TANACHAT007/diy-spirometer/02_design/feasibility.md

# Feasibility — DIY Spirometer (IoT, Venturi + SDP810)

Venturi D = 28.0 mm, d = 23.0 mm (β = 0.821), ρ = 1.15, Cd = 0.98; Sensirion SDP810-500Pa (±500 Pa, I2C).

| Q (L/s) | ΔP (Pa) | count SDP810 |
|---|---|---|
| 0.1 | 0.019 | 1 |
| 0.2 | 0.076 | 5 |
| 0.5 | 0.472 | 28 |
| 1 | 1.889 | 113 |
| 2 | 7.557 | 453 |
| 5 | 47.232 | 2834 |
| 8 | 120.914 | 7255 |
| 10 | 188.928 | 11336 |
| 12 | 272.057 | 16323 |
| 14 | 370.300 | 22218 |
| 16 | 483.657 | 29019 |

| ตรวจ | ค่า | ผล |
|---|---|---|
| ช่วงวัด ≥ 16 L/s ก่อนเซนเซอร์อิ่มตัว (ndd = ±16) | อิ่มตัวที่ 16.3 L/s | ✅ |
| ความต้านทานลม < 1.5 cmH2O/L/s (ATS/ERS 2019) | 0.046 cmH2O/L/s | ✅ |
| ความละเอียดที่ 0.2 L/s (ปลายการเป่า) | 0.076 Pa = 4.5 count | ✅ |
| อัตราสุ่ม ≥ 100 Hz | SDP810 continuous 0.5 ms → ใช้ 200 Hz | ✅ |
| แบต 1000 mAh ต่อการชาร์จ | ≈ 337 ครั้งเป่า / ชาร์จ, sleep ≈ 417 วัน | ✅ |
| ชาร์จผ่านแท่น (XIAO S3 charger 100 mA) | ≈ 12 ชม. เต็ม (ตั้งไว้บนแท่นข้ามคืน) | ✅ |
| ขั้วสปริง pogo 2 ขา 1 A | 5 V 0.5 A สูงสุด | ✅ |

## เทียบกับ ndd Easy on-PC
| | ndd Easy on-PC | ของเรา |
|---|---|---|
| การเชื่อมต่อ | สาย USB เข้า PC | ไร้สาย BLE (มือถือ) + Wi-Fi → คลาวด์ + USB-C |
| พลังงาน | ไฟจาก USB | แบต LiPo 1000 mAh + แท่นชาร์จ |
| แสดงผล | บนคอมเท่านั้น | จอกลม 1.28" บนตัวเครื่อง + เว็บแอป + แดชบอร์ดห้องเรียน |
| ข้อมูล | ซอฟต์แวร์ PC | Firebase: ประวัติรายคน, กราฟ, ส่งออก CSV |
| ราคา | ~60,000+ บาท | ~2,000 บาท |
| ความแม่นยำ | ±2.5 % (รับรอง ATS/ERS) | เป้าหมาย ±5 % หลังสอบเทียบ (ยังไม่รับรอง) |

## ข้อจำกัด
- ΔP ของ Venturi เป็นบวกทั้งสองทิศ → วัดลมออกเป็นหลัก (FVC, FEV1, PEF, FEV1/FVC, FEF25-75).
- ต้องสอบเทียบ Cd กับกระบอกฉีด 3 L (หรือยืมจากโรงพยาบาล) ก่อนอ้างตัวเลข.
- เป็นเครื่องมือเพื่อการเรียนรู้/คัดกรองเบื้องต้น ไม่ใช่เครื่องมือแพทย์.
