TANACHAT007/diy-spirometer/CREDITS.md

# Credits

**Designed and built by Tanachat S.** (GitHub: [TANACHAT007](https://github.com/TANACHAT007)) - team **MEDTHAI**, 2026.

If you reuse, remix or print this work, please keep this credit:

> DIY IoT Spirometer - designed by Tanachat S. (TANACHAT007) / MEDTHAI - 2026 - https://github.com/TANACHAT007/diy-spirometer

- Code: MIT (`LICENSE`) - keep the copyright notice.
- Designs / documents / models: CC BY 4.0 (`LICENSE-DESIGN`) - attribution required.
- Prepared for International Youth Summit (IYS) 2026, sub-theme Health.

Third-party parts are credited to their makers (Sensirion SDP810, Seeed XIAO ESP32, GC9A01 modules); their names are used only to identify compatible parts.
