TANACHAT007/diy-spirometer/01_reference/ndd_easy_on_pc.png

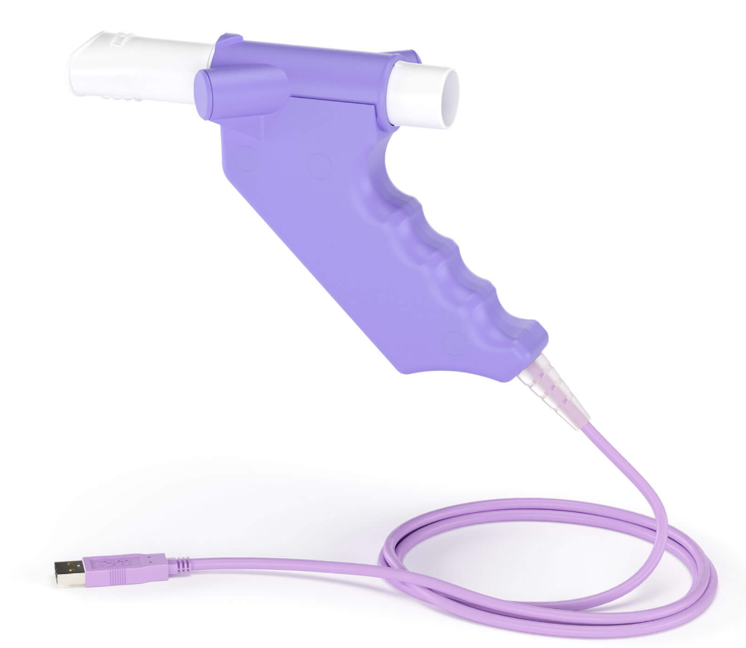
01_reference/ndd_easy_on_pc.png
