TANACHAT007/diy-spirometer/03_renders/diy-spirometer_cu_dock.png

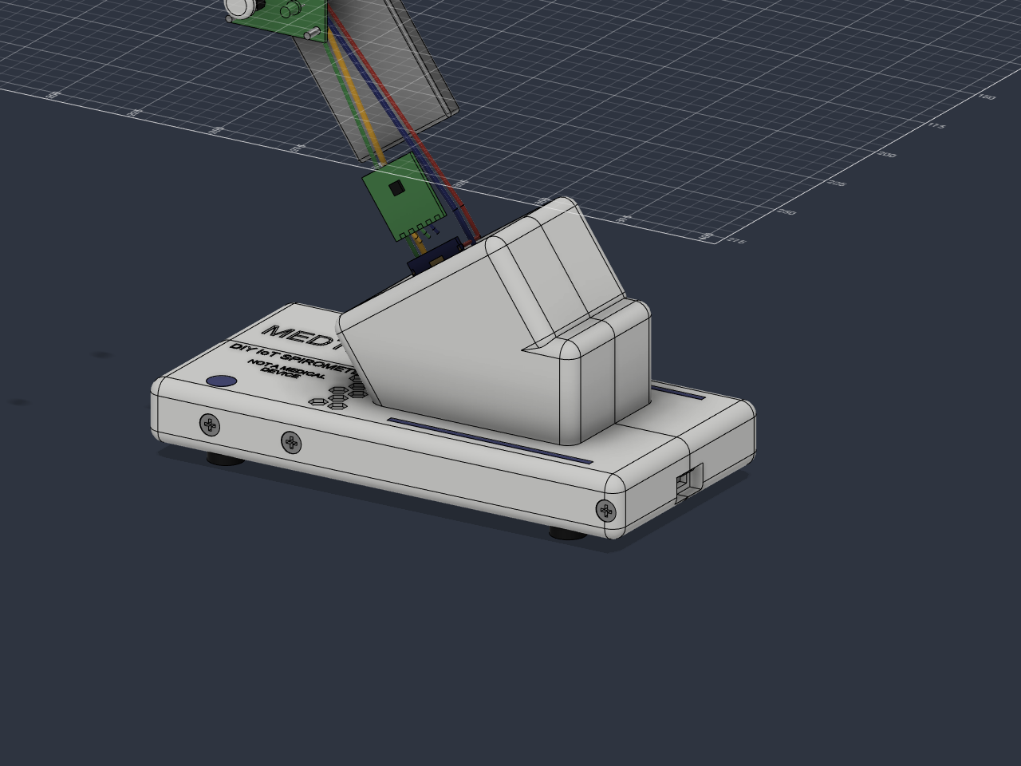
03_renders/diy-spirometer_cu_dock.png
