TANACHAT007/diy-spirometer/03_renders/diy-spirometer_cu_hero.png

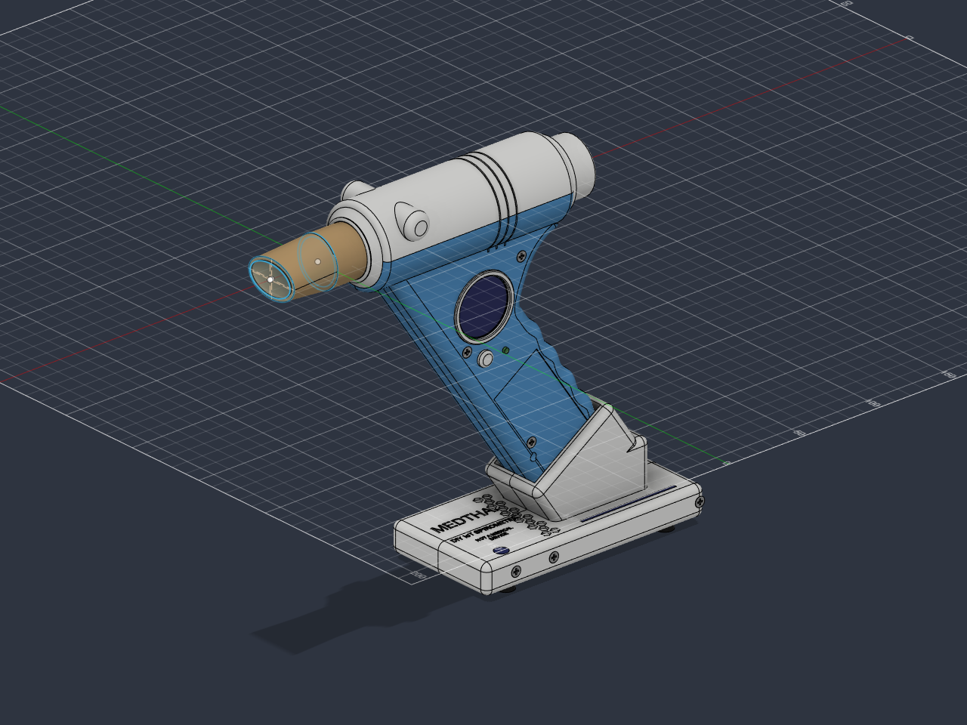
03_renders/diy-spirometer_cu_hero.png
