TANACHAT007/diy-spirometer/03_renders/diy-spirometer_cu_open.png

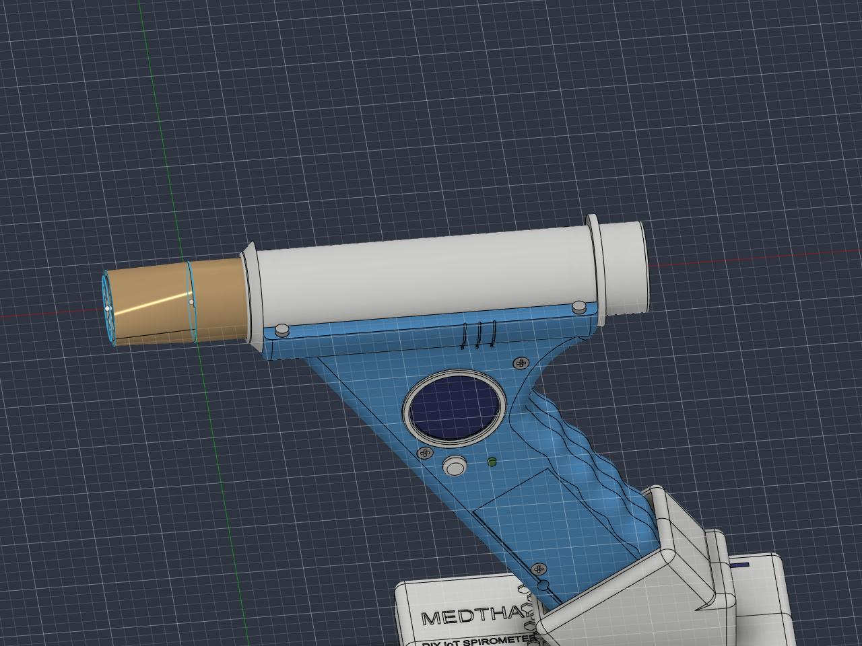
03_renders/diy-spirometer_cu_open.png
