TANACHAT007/diy-spirometer/03_renders/diy-spirometer_cut_grip.png

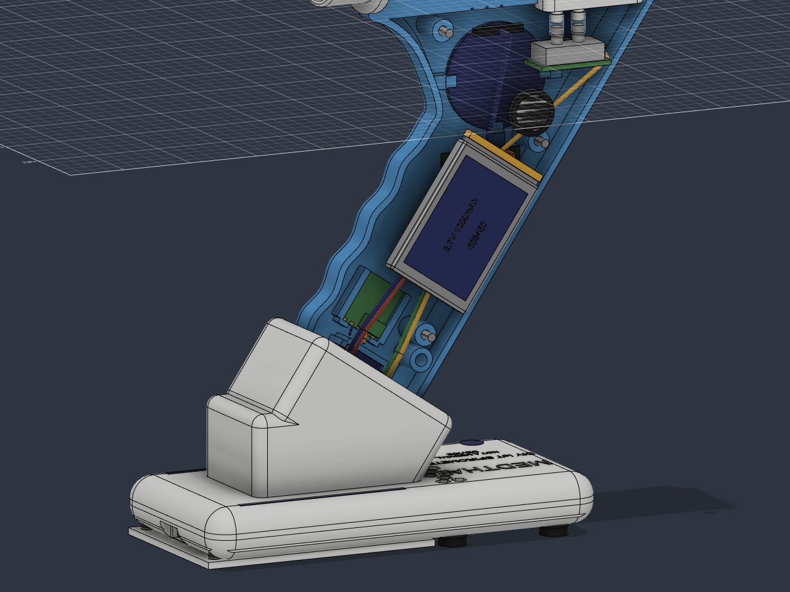
03_renders/diy-spirometer_cut_grip.png
