TANACHAT007/diy-spirometer/03_renders/diy-spirometer_cut_side.png

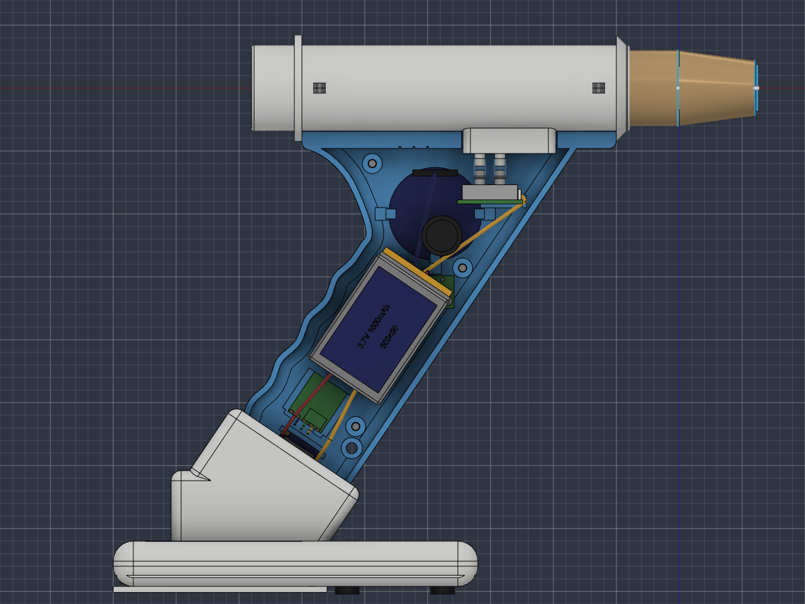
03_renders/diy-spirometer_cut_side.png
