TANACHAT007/diy-spirometer/03_renders/diy-spirometer_dockcut_open.png

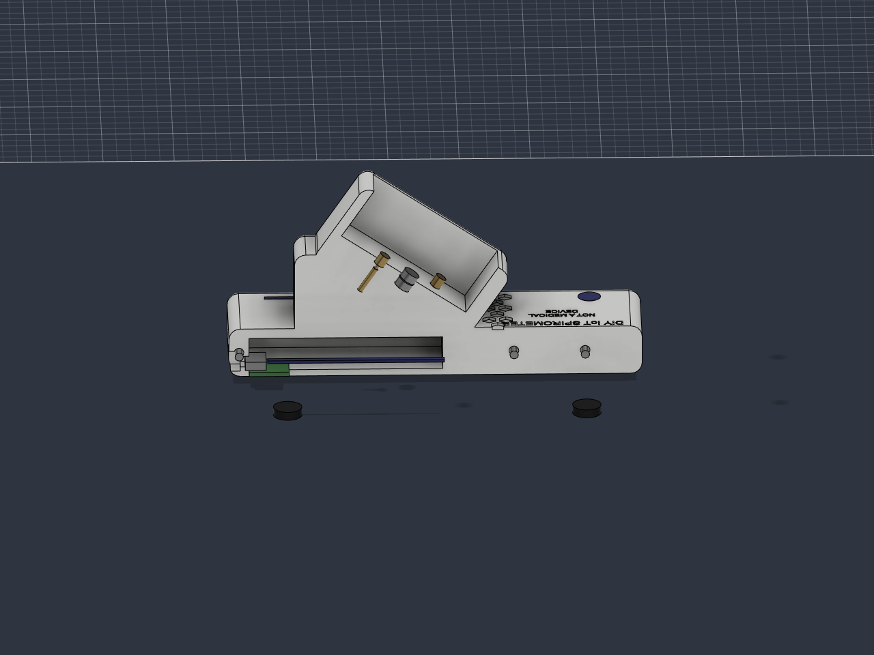
03_renders/diy-spirometer_dockcut_open.png
