TANACHAT007/diy-spirometer/03_renders/diy-spirometer_dockcut_top.png

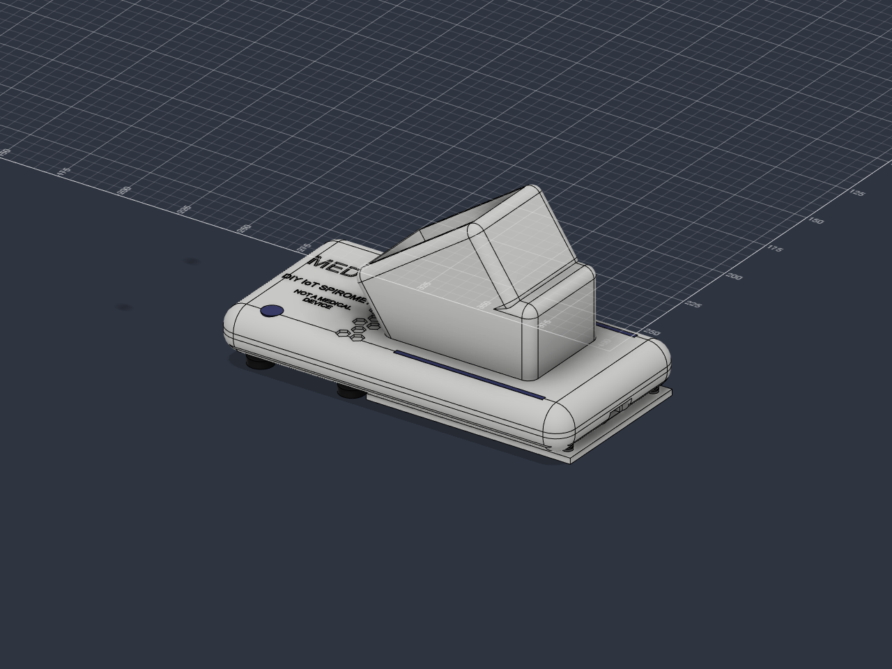
03_renders/diy-spirometer_dockcut_top.png
