TANACHAT007/diy-spirometer/03_renders/diy-spirometer_front.png

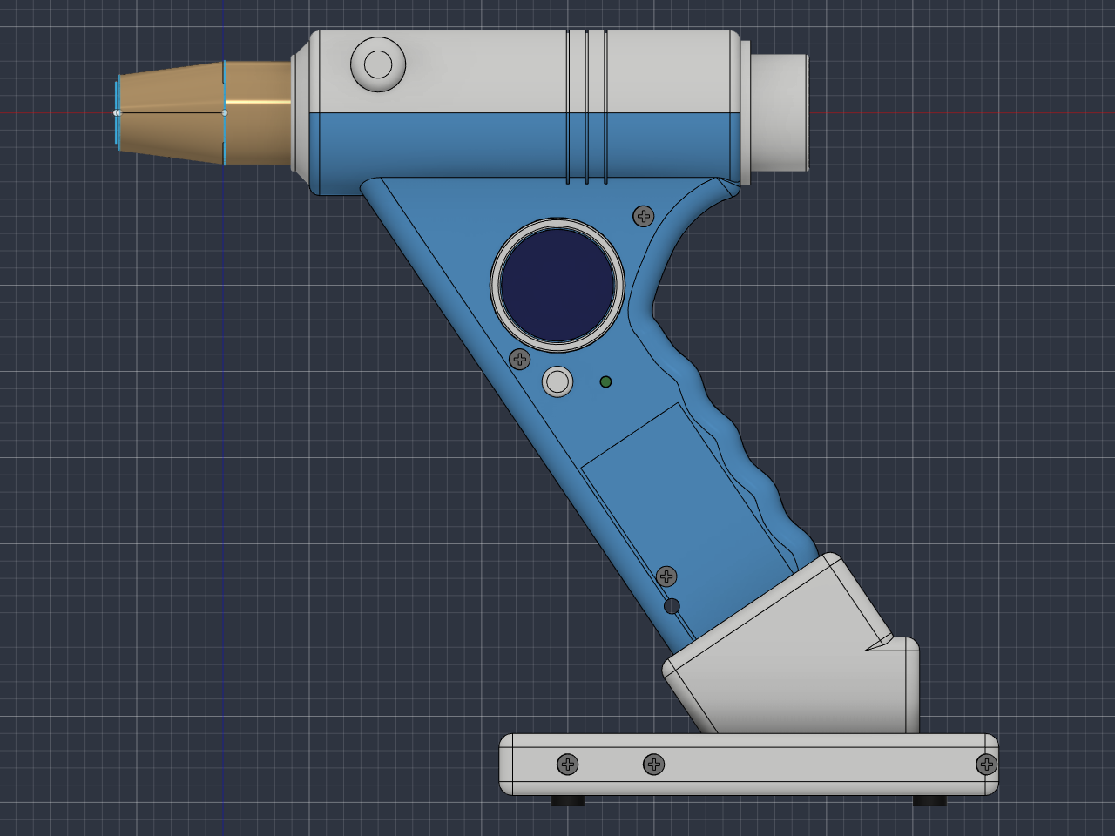
03_renders/diy-spirometer_front.png
