TANACHAT007/diy-spirometer/03_renders/diy-spirometer_iso.png

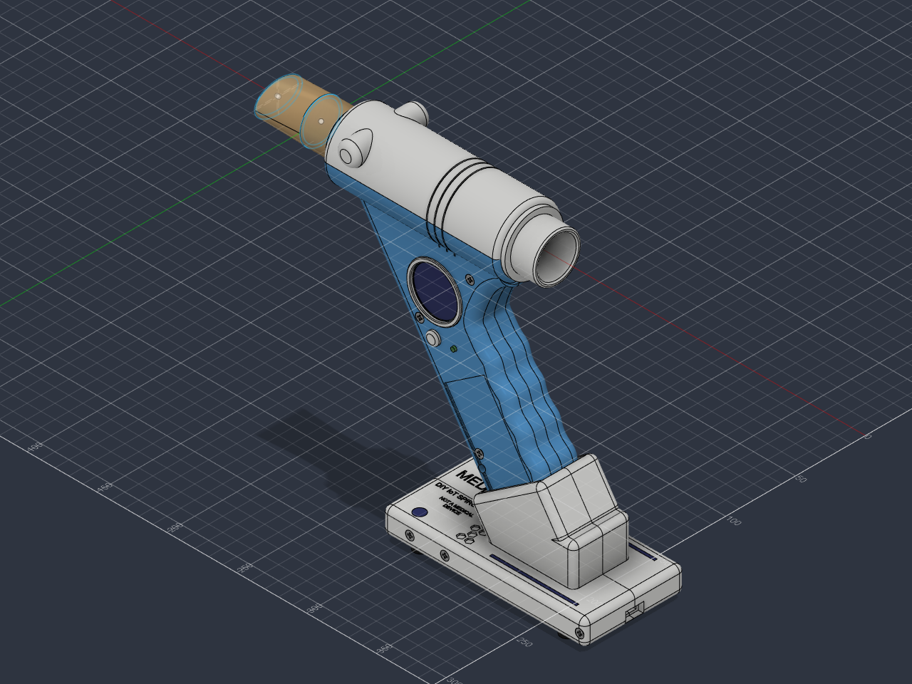
03_renders/diy-spirometer_iso.png
