TANACHAT007/diy-spirometer/03_renders/diy-spirometer_right.png

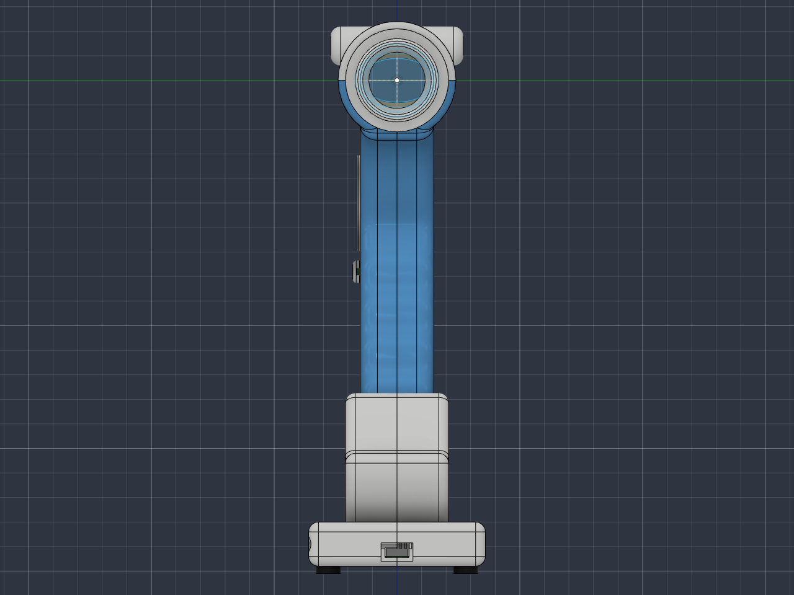
03_renders/diy-spirometer_right.png
