TANACHAT007/diy-spirometer/09_bom/bom.csv

# | Group | Item | Spec | Qty | Unit THB (est.) | Total THB | Status | Shopee | Lazada | Note
1 | อิเล็กทรอนิกส์ | บอร์ดหลัก Seeed XIAO ESP32-S3 (หรือ ESP32-C3) | 21x17.8 mm, BLE+Wi-Fi, มีวงจรชาร์จ LiPo | 1 | 350 | 350 | buy | https://shopee.co.th/search?keyword=Seeed%20XIAO%20ESP32S3 | https://www.lazada.co.th/catalog/?q=Seeed%20XIAO%20ESP32S3 | C3 ใช้ได้เหมือนกัน (ถูกกว่า) ใส่ได้ footprint เดียวกัน
2 | อิเล็กทรอนิกส์ | เซ็นเซอร์ความดันต่าง Sensirion SDP810-500Pa | I2C 0x25, บน breakout 26x14 + ขั้ว JST-GH 4 ขา | 1 | 1200 | 1200 | buy? | https://shopee.co.th/search?keyword=SDP810-500Pa%20breakout | https://www.lazada.co.th/catalog/?q=SDP810-500Pa%20breakout | ตัวเดียวที่อาจไม่มีใน Shopee: ถ้าหาไม่ได้สั่ง Mouser/DigiKey/Element14 + breakout; ตัว SMD ต้องบัดกรีละเอียด
3 | อิเล็กทรอนิกส์ | จอกลม GC9A01 1.28 นิ้ว | 240x240 SPI, PCB กลม Ø37 | 1 | 150 | 150 | buy | https://shopee.co.th/search?keyword=GC9A01%201.28%20inch%20round%20LCD | https://www.lazada.co.th/catalog/?q=GC9A01%201.28%20inch%20round%20LCD | ตรวจว่าเป็นรุ่น 7 ขา (ไม่มีทัช)
4 | อิเล็กทรอนิกส์ | แบตเตอรี่ LiPo 603450 1000 mAh | 3.7 V มีวงจร PCM, ขนาด 6x34x50 mm | 1 | 150 | 150 | buy | https://shopee.co.th/search?keyword=LiPo%20603450%201000mAh%203.7V | https://www.lazada.co.th/catalog/?q=LiPo%20603450%201000mAh%203.7V | ต้องมีวงจรป้องกัน; ขั้วต่อ JST 1.25/PH ให้ตรงกับบอร์ดหรือบัดกรีตรง
5 | อิเล็กทรอนิกส์ | ลำโพงกลมบาง Ø16 x 3.5 mm 8 ohm 0.5 W | ติดผนังด้ามขวา เสียงออกรู Ø1.4 x 19 รู | 1 | 25 | 25 | buy | https://shopee.co.th/search?keyword=mini%20speaker%2016mm%208ohm%200.5W | https://www.lazada.co.th/catalog/?q=mini%20speaker%2016mm%208ohm%200.5W | ตรวจขนาดจริงก่อนพิมพ์ (ถ้า Ø15/Ø20 ปรับ SPK_D ใน model.py); ติดเทปโฟมกันเสียงรั่ว
6 | อิเล็กทรอนิกส์ | แอมป์เสียง I2S MAX98357A breakout | 3 W class-D, ~19 x 18 mm, ไม่ต้องมี DAC | 1 | 90 | 90 | buy | https://shopee.co.th/search?keyword=MAX98357A%20I2S%20amplifier%20module | https://www.lazada.co.th/catalog/?q=MAX98357A%20I2S%20amplifier%20module | ต่อ BCLK/LRC/DIN เข้า D3/D6/D7, ใช้ 3.3 V จากบอร์ด, SD/GAIN ปล่อยค่าเดิม
7 | อิเล็กทรอนิกส์ | ปุ่ม tact switch 6x6 สูง 7 mm | ก้านยาว 7 mm | 2 | 3 | 6 | buy | https://shopee.co.th/search?keyword=tact%20switch%206x6x7 | https://www.lazada.co.th/catalog/?q=tact%20switch%206x6x7 | ซื้อเผื่อ 1
8 | อิเล็กทรอนิกส์ | LED 3 mm | สีเขียว/ฟ้า + R 330 ohm | 2 | 2 | 4 | buy | https://shopee.co.th/search?keyword=LED%203mm | https://www.lazada.co.th/catalog/?q=LED%203mm | บวกตัวต้านทาน 330 ohm
9 | อิเล็กทรอนิกส์ | แผงปุ่ม+LED (perfboard 13x29 mm) | บัดกรีปุ่ม tact + LED ลงแผงก่อน แล้ววางลงเสา 2 ต้นในตัวเครื่อง | 1 | 5 | 5 | buy | https://shopee.co.th/search?keyword=perfboard%202x8%20cm | https://www.lazada.co.th/catalog/?q=perfboard%202x8%20cm | ตัดจากแผ่นยาว
10 | ฮาร์ดแวร์ | สกรู M2x6 หัวกลม (tapping) | ยึดแผงปุ่ม+LED 2 ตัว | 2 | 2 | 4 | buy | https://shopee.co.th/search?keyword=M2x6%20self%20tapping%20screw | https://www.lazada.co.th/catalog/?q=M2x6%20self%20tapping%20screw | ซื้อเป็นชุด
11 | อิเล็กทรอนิกส์ | ตัวต้านทาน 4.7 kohm | ดึงขึ้น I2C 2 ตัว + ตัวหาร R 100 kohm 2 ตัว (วัดแบต) | 6 | 1 | 6 | buy | https://shopee.co.th/search?keyword=resistor%20kit%201/4W | https://www.lazada.co.th/catalog/?q=resistor%20kit%201/4W | ซื้อเป็นชุด
12 | อิเล็กทรอนิกส์ | สายไฟ 28-30 AWG / สาย silicone | หลายสี | 1 | 40 | 40 | buy | https://shopee.co.th/search?keyword=%E0%B8%AA%E0%B8%B2%E0%B8%A2%E0%B9%84%E0%B8%9F%2028AWG%20silicone | https://www.lazada.co.th/catalog/?q=%E0%B8%AA%E0%B8%B2%E0%B8%A2%E0%B9%84%E0%B8%9F%2028AWG%20silicone
13 | อิเล็กทรอนิกส์ | USB-C breakout (แท่นชาร์จ) | ตัวเมีย 5 V | 1 | 30 | 30 | buy | https://shopee.co.th/search?keyword=USB-C%20breakout%20board | https://www.lazada.co.th/catalog/?q=USB-C%20breakout%20board
14 | กล/ตัวยึด | Pogo pin ก้าน Ø2.0 | สปริง 2 ตัว ระยะยื่น ~2 mm | 2 | 15 | 30 | buy | https://shopee.co.th/search?keyword=pogo%20pin%202mm%20spring | https://www.lazada.co.th/catalog/?q=pogo%20pin%202mm%20spring | วัดเส้นผ่าศูนย์กลางก้านให้ได้ 2.0 mm (รูเจาะ 2.2)
15 | กล/ตัวยึด | น็อตฝังทองเหลือง M3 x 5 (OD4.5) | heat-set insert | 4 | 1 | 4 | buy | https://shopee.co.th/search?keyword=heat%20set%20insert%20M3%205mm | https://www.lazada.co.th/catalog/?q=heat%20set%20insert%20M3%205mm | ซื้อแพ็ค 50-100 ตัว
16 | กล/ตัวยึด | น็อตฝังทองเหลือง M3 x 4 (OD4.5) | heat-set insert | 6 | 1 | 6 | buy | https://shopee.co.th/search?keyword=heat%20set%20insert%20M3%204mm | https://www.lazada.co.th/catalog/?q=heat%20set%20insert%20M3%204mm | แท่นชาร์จ 4 + หน้าสัมผัสบนเครื่อง 2
17 | กล/ตัวยึด | สกรู M3x20 หัวเตเปอร์ (flat head) |  | 4 | 1 | 4 | buy | https://shopee.co.th/search?keyword=M3x20%20flat%20head%20screw | https://www.lazada.co.th/catalog/?q=M3x20%20flat%20head%20screw | ตัวเครื่อง
18 | กล/ตัวยึด | สกรู M3x6 หัวเตเปอร์ |  | 4 | 1 | 4 | buy | https://shopee.co.th/search?keyword=M3x6%20flat%20head%20screw | https://www.lazada.co.th/catalog/?q=M3x6%20flat%20head%20screw | ปิดแท่นชาร์จ
19 | กล/ตัวยึด | แม่เหล็กนีโอไดเมียม 5x2 |  | 8 | 3 | 24 | buy | https://shopee.co.th/search?keyword=neodymium%20magnet%205x2 | https://www.lazada.co.th/catalog/?q=neodymium%20magnet%205x2 | ฝาท่อ 4 คู่ (ตรวจขั้วตอนติดกาว)
20 | กล/ตัวยึด | แม่เหล็กนีโอไดเมียม 6x3 |  | 2 | 5 | 10 | buy | https://shopee.co.th/search?keyword=neodymium%20magnet%206x3 | https://www.lazada.co.th/catalog/?q=neodymium%20magnet%206x3 | นำทางด้ามเข้าแท่น
21 | กล/ตัวยึด | ท่อซิลิโคน ID3 OD5 | ยาว ~50 mm 2 ท่อน | 1 | 30 | 30 | buy | https://shopee.co.th/search?keyword=silicone%20tube%203x5mm | https://www.lazada.co.th/catalog/?q=silicone%20tube%203x5mm
22 | กล/ตัวยึด | ยางรองเท้า Ø10 x 3 mm |  | 4 | 3 | 12 | buy | https://shopee.co.th/search?keyword=rubber%20feet%2010mm%20adhesive | https://www.lazada.co.th/catalog/?q=rubber%20feet%2010mm%20adhesive | ใต้แท่นชาร์จ
23 | วัสดุพิมพ์ | เส้น PETG (สีขาว/ใส/เขียวอ่อน) สำหรับที่เป่าต้นแบบ | ที่เป่าใช้แล้วทิ้ง ชิ้นละ ~11 g (~5 บาท) | 1 | 400 | 400 | buy? | https://shopee.co.th/search?keyword=PETG%20filament%201kg | https://www.lazada.co.th/catalog/?q=PETG%20filament%201kg | ใช้พิมพ์ที่เป่าอย่างเดียว; ไม่ย่อยสลาย รุ่นต่อไปเปลี่ยนเป็นวัสดุเศษพืช; ซื้อเป็นม้วน 250-500 g ก็ได้
24 | กล/ตัวยึด | กาวตะกั่ว/ซุปเปอร์กลู + สายคล้องมือ | ติดขอบจอและฝาปุ่ม; สายร้อยรู Ø4.5 ที่ท้ายด้าม | 1 | 30 | 30 | buy | https://shopee.co.th/search?keyword=super%20glue%20gel%20%2B%20wrist%20strap%20cord | https://www.lazada.co.th/catalog/?q=super%20glue%20gel%20%2B%20wrist%20strap%20cord | ใช้กาวเจลหยดเล็กน้อย อย่าให้เข้าหน้าจอ
25 | วัสดุพิมพ์ | เทปโฟมกาวสองหน้า 1 mm | ติดลำโพง/กันเสียงรั่ว | 1 | 20 | 20 | buy | https://shopee.co.th/search?keyword=foam%20tape%201mm%20double%20sided | https://www.lazada.co.th/catalog/?q=foam%20tape%201mm%20double%20sided
26 | วัสดุพิมพ์ | เส้น PETG | ≈ 520 g (รวม +10%) | 1 | 450 | 450 | buy? | https://shopee.co.th/search?keyword=PETG%20filament%201kg | https://www.lazada.co.th/catalog/?q=PETG%20filament%201kg | ถ้ามีเส้นอยู่แล้วไม่ต้องซื้อ
