TANACHAT007/diy-spirometer/09_bom/fasteners_bom.csv

item | qty
M3x5_heat-set_insert_brass | 7
M3x20_flat_head_phillips_countersunk | 4
M3x40_flat_head_phillips_countersunk | 3
