TANACHAT007/diy-spirometer/06_cad_export/diy-spirometer_assembly.step

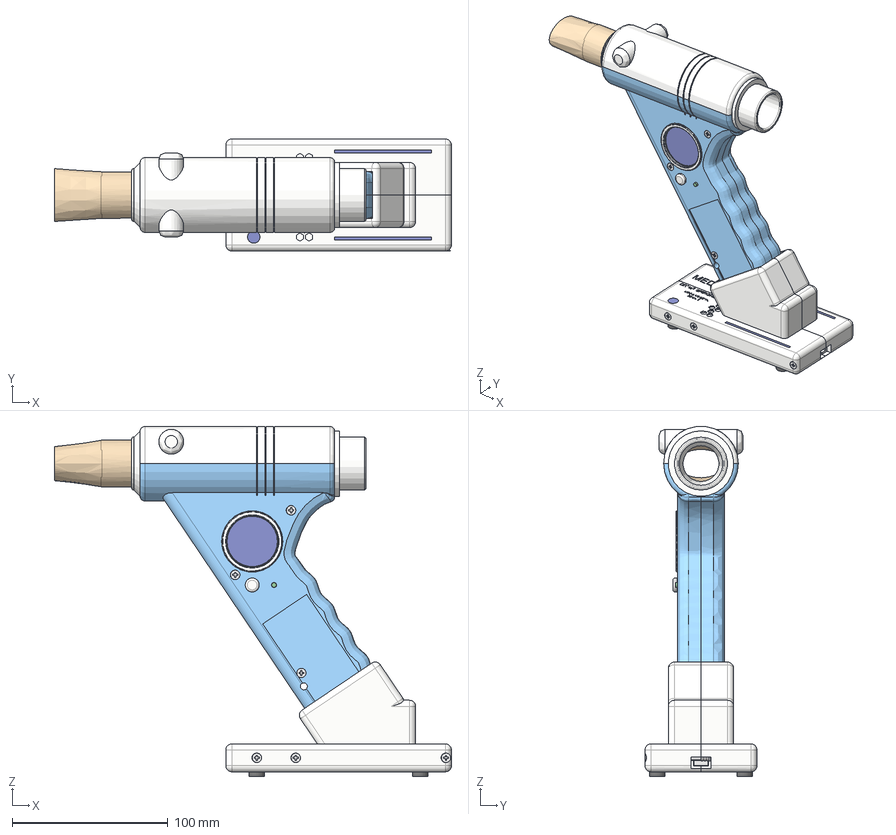
[picture p27: CAD file, 2026-10-21]
06_cad_export/diy-spirometer_assembly.step
255.0 x 72.0 x 224.8 mm
