TANACHAT007/diy-spirometer/04_print_stl/dock_left.stl

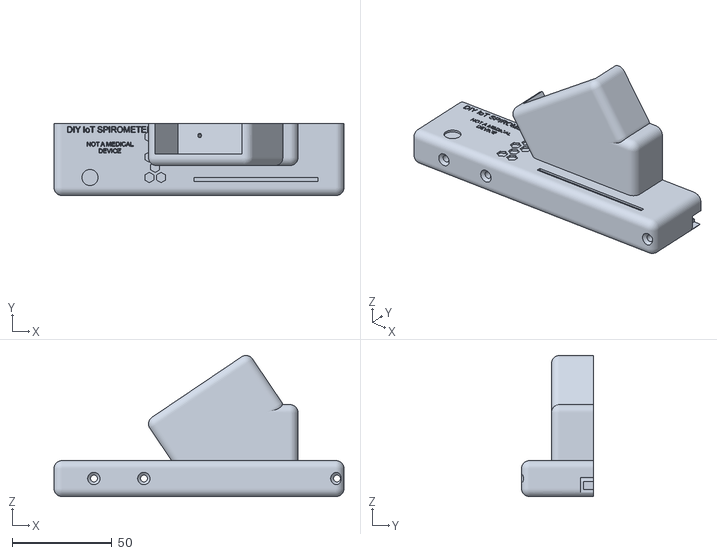
[picture p28: CAD file, 2026-10-21]
04_print_stl/dock_left.stl
145.0 x 36.0 x 70.5
