TANACHAT007/diy-spirometer/04_print_stl/print_ready/plate3_dock_halves.stl

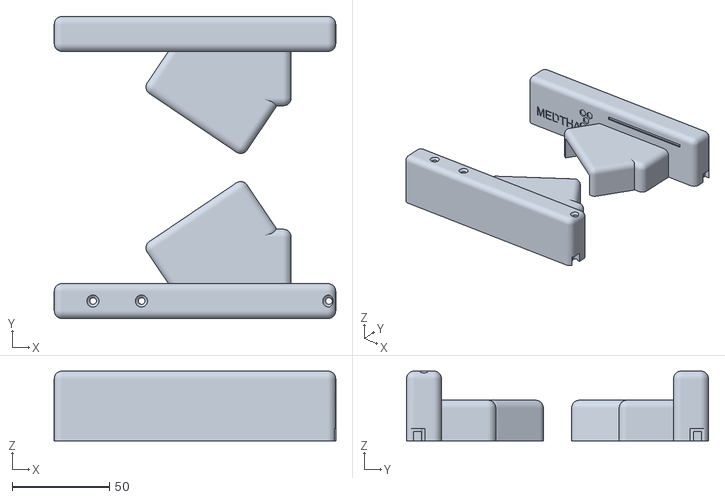
[picture p29: CAD file, 2026-10-22]
04_print_stl/print_ready/plate3_dock_halves.stl
145.0 x 155.5 x 36.0
