TANACHAT007/diy-spirometer/10_manual/web/internals/Rubber_Feet.stl

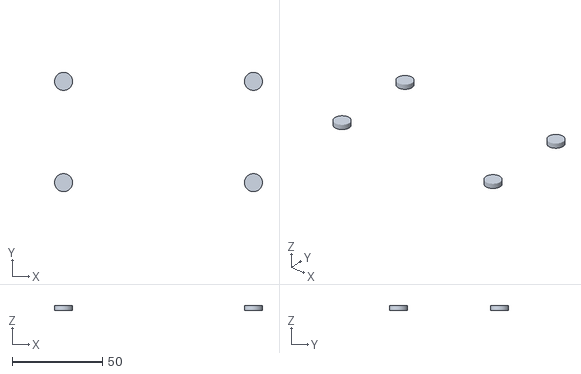
[picture p30: CAD file, 2026-10-22]
10_manual/web/internals/Rubber_Feet.stl
115.0 x 66.0 x 3.00
