TANACHAT007/diy-spirometer/04_print_stl/print_ready/plate4_small_parts.stl

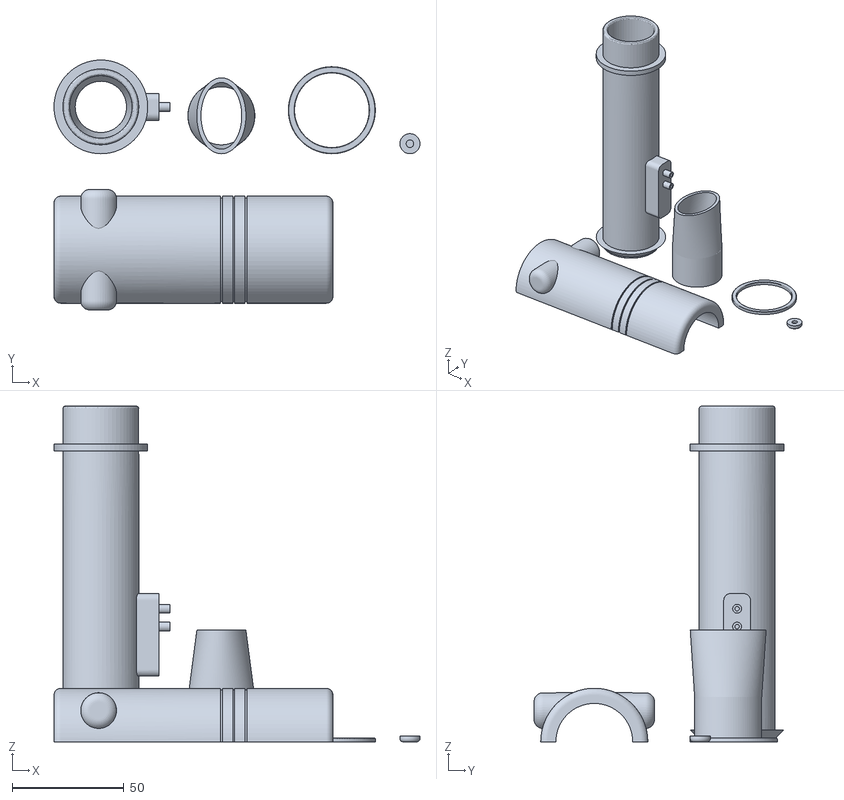
[picture p31: CAD file, 2026-10-22]
04_print_stl/print_ready/plate4_small_parts.stl
164.0 x 112.0 x 150.4
