TANACHAT007/diy-spirometer/10_manual/web/internals/E7_USB_C_Breakout_Dock.stl

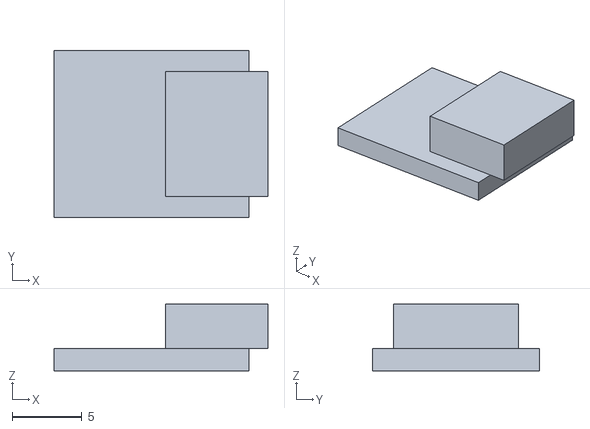
[picture p32: CAD file, 2026-10-22]
10_manual/web/internals/E7_USB_C_Breakout_Dock.stl
15.4 x 12.0 x 4.80
