TANACHAT007/diy-spirometer/04_print_stl/housing_right.stl

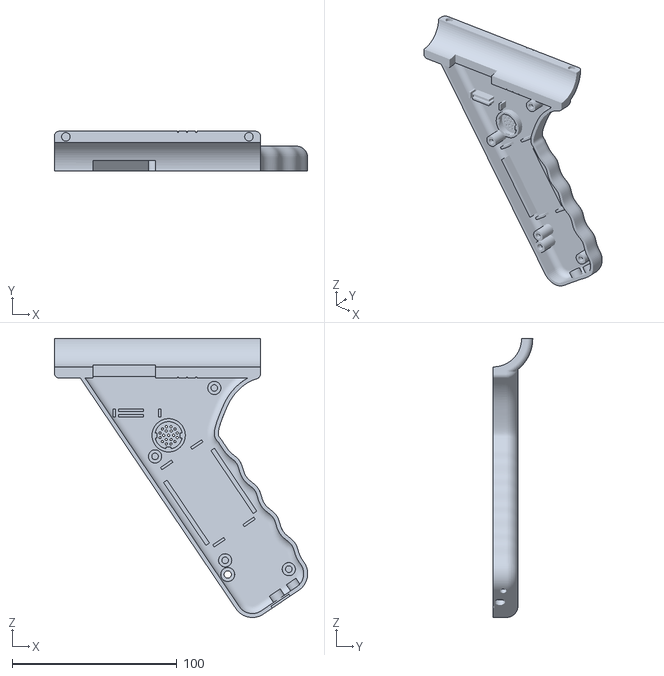
[picture p33: CAD file, 2026-10-21]
04_print_stl/housing_right.stl
153.6 x 24.0 x 169.1
