TANACHAT007/diy-spirometer/04_print_stl/print_ready/plate1_housing_left.stl

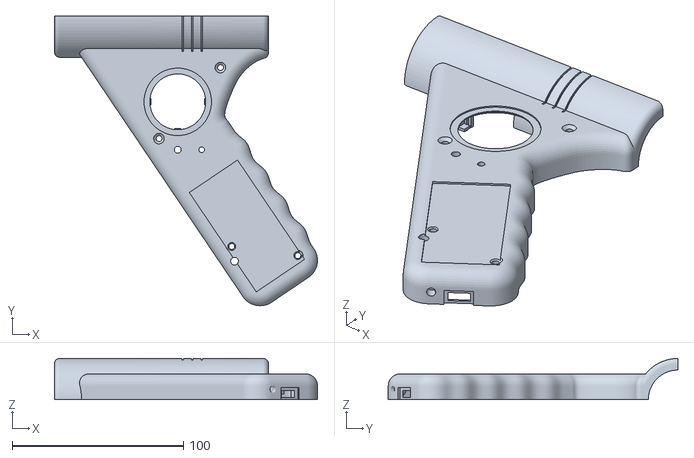
[picture p34: CAD file, 2026-10-22]
04_print_stl/print_ready/plate1_housing_left.stl
153.6 x 169.1 x 24.0
