TANACHAT007/diy-spirometer/10_manual/web/internals/E6_LED_3mm.stl

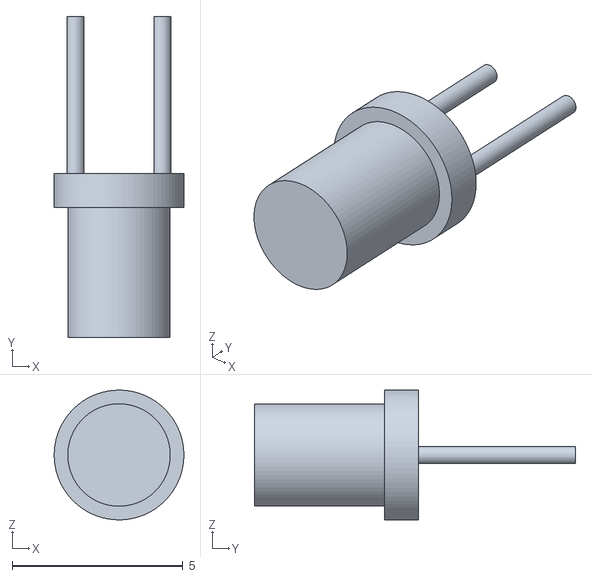
[picture p35: CAD file, 2026-10-16]
10_manual/web/internals/E6_LED_3mm.stl
3.80 x 9.40 x 3.80
