TANACHAT007/diy-spirometer/10_manual/web/internals/E7_Button_LED_Board.stl

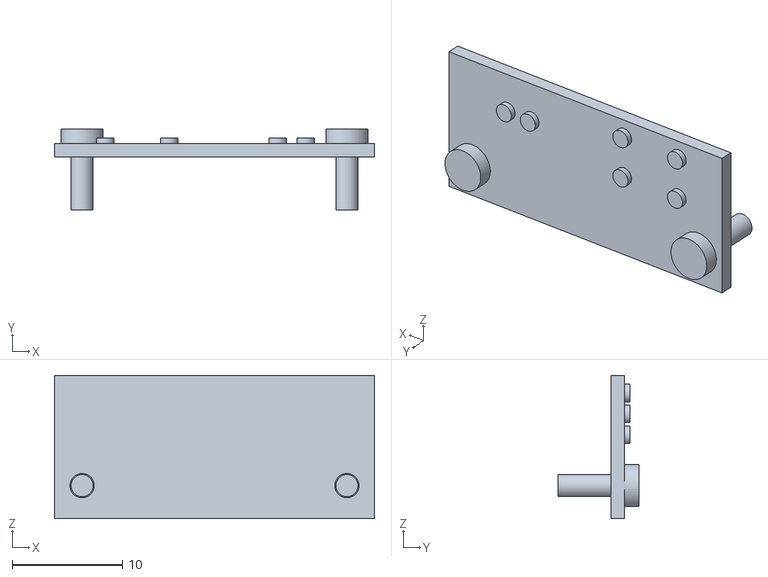
[picture p36: CAD file, 2026-10-16]
10_manual/web/internals/E7_Button_LED_Board.stl
29.0 x 7.30 x 13.0
