TANACHAT007/diy-spirometer/04_print_stl/mouthpiece.stl

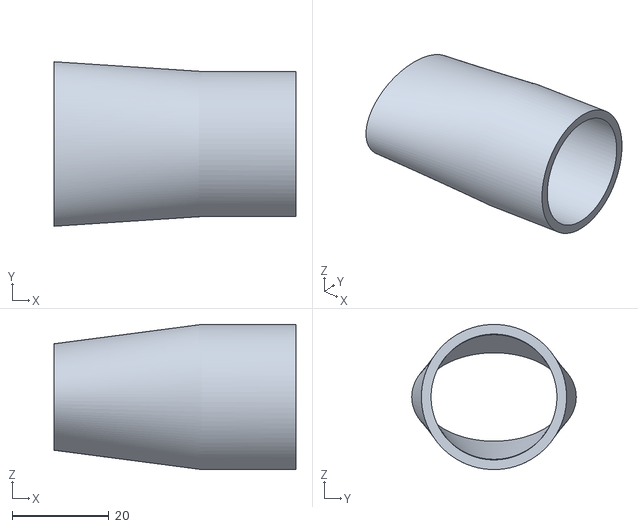
[picture p37: CAD file, 2026-10-21]
04_print_stl/mouthpiece.stl
50.0 x 34.0 x 30.0
