TANACHAT007/diy-spirometer/10_manual/web/internals/E9_MAX98357A_I2S_Amp.stl

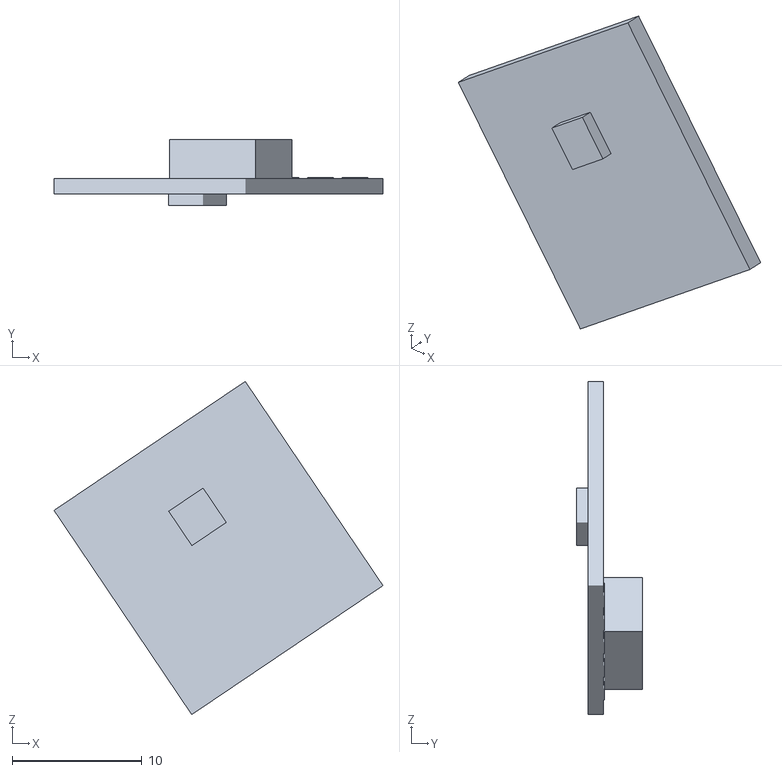
[picture p38: CAD file, 2026-10-15]
10_manual/web/internals/E9_MAX98357A_I2S_Amp.stl
25.4 x 5.10 x 25.7
