TANACHAT007/diy-spirometer/04_print_stl/button_cap.stl

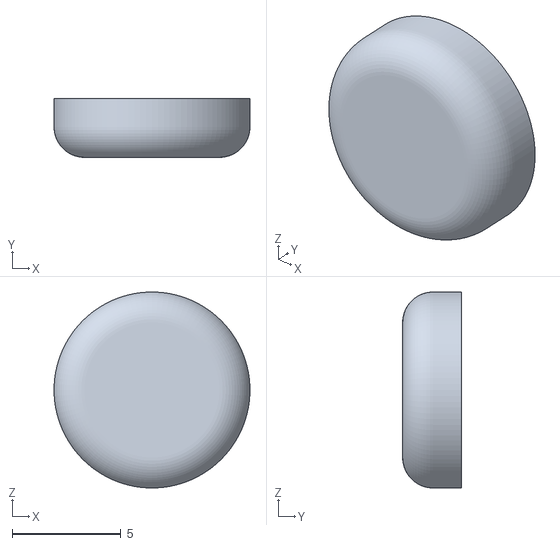
[picture p39: CAD file, 2026-10-21]
04_print_stl/button_cap.stl
9.00 x 2.70 x 9.00
