TANACHAT007/diy-spirometer/10_manual/web/internals/E8_Speaker_16mm.stl

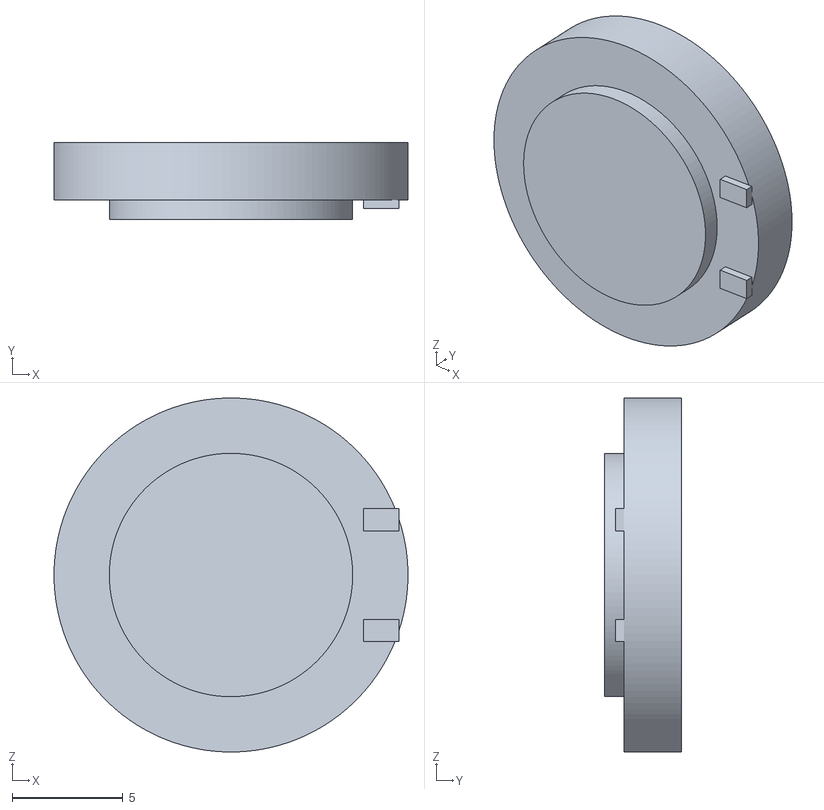
[picture p40: CAD file, 2026-10-15]
10_manual/web/internals/E8_Speaker_16mm.stl
16.0 x 3.50 x 16.0
