TANACHAT007/diy-spirometer/04_print_stl/bezel.stl

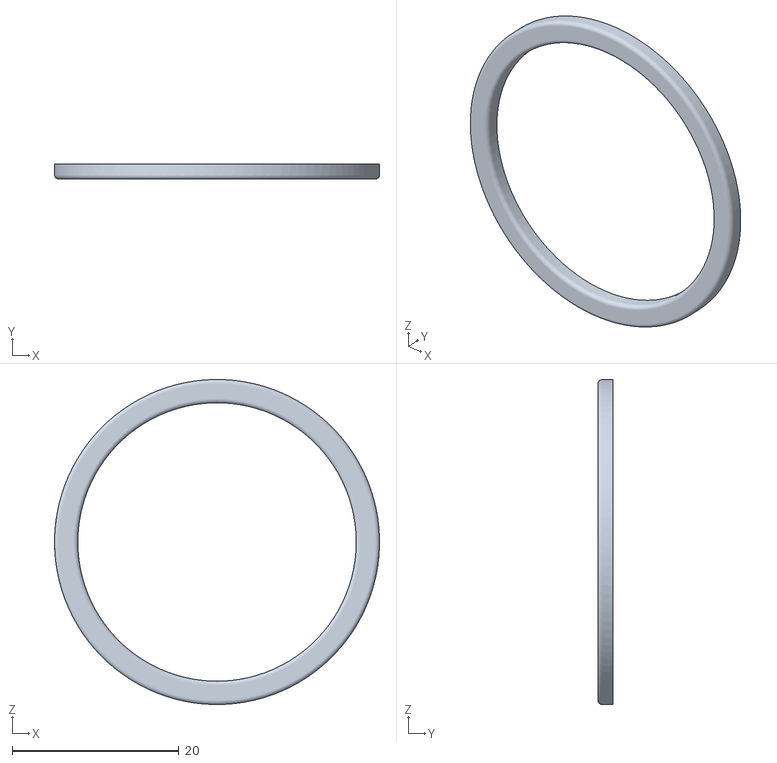
[picture p41: CAD file, 2026-10-21]
04_print_stl/bezel.stl
39.0 x 1.80 x 39.0
