TANACHAT007/diy-spirometer/10_manual/web/internals/Wires_Audio.stl

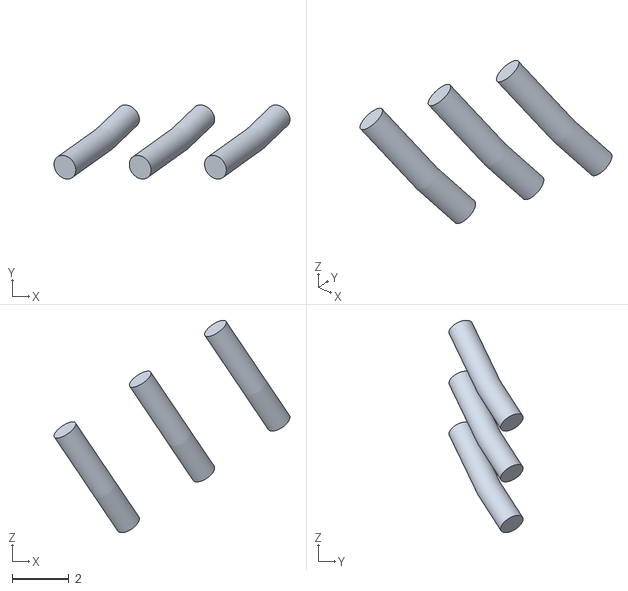
[picture p42: CAD file, 2026-10-15]
10_manual/web/internals/Wires_Audio.stl
8.32 x 2.61 x 7.49
