TANACHAT007/diy-spirometer/04_print_stl/top_cover.stl

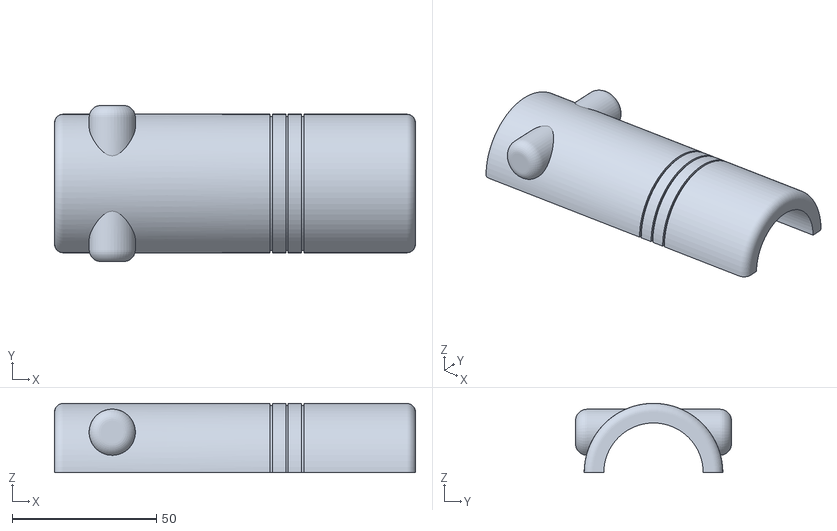
[picture p43: CAD file, 2026-10-21]
04_print_stl/top_cover.stl
125.0 x 54.0 x 24.0
