TANACHAT007/diy-spirometer/10_manual/web/internals/E2_SDP810_500Pa.stl

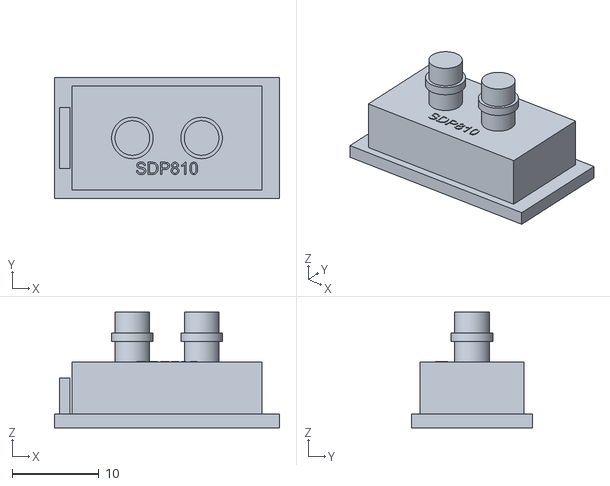
[picture p44: CAD file, 2026-10-15]
10_manual/web/internals/E2_SDP810_500Pa.stl
26.0 x 14.0 x 13.4
