TANACHAT007/diy-spirometer/04_print_stl/flow_tube.stl

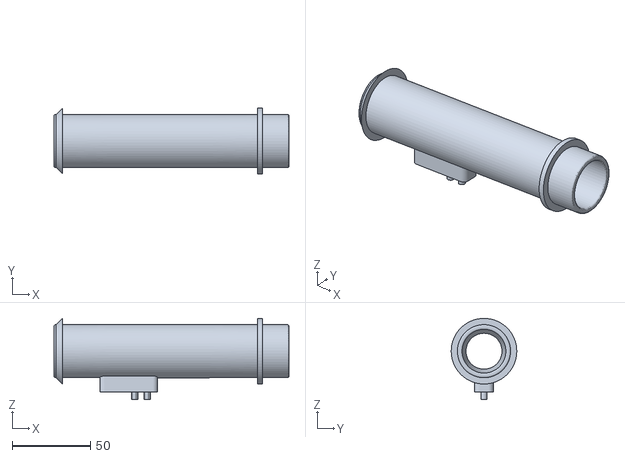
[picture p45: CAD file, 2026-10-15]
04_print_stl/flow_tube.stl
150.4 x 42.0 x 52.0
