TANACHAT007/diy-spirometer/10_manual/web/internals/Wires.stl

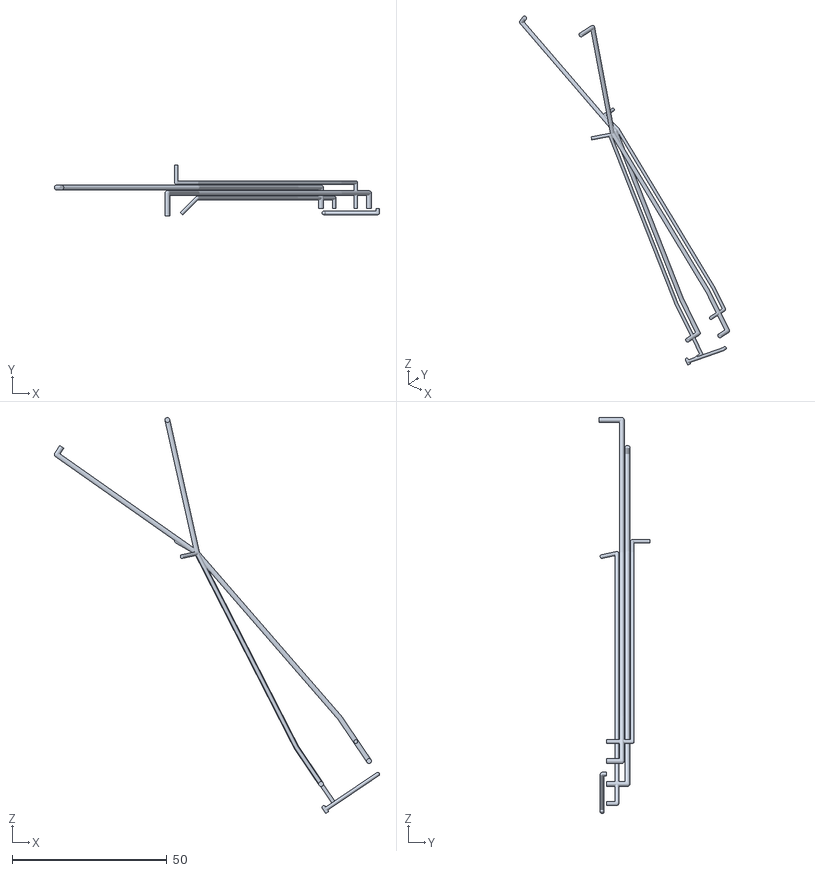
[picture p46: CAD file, 2026-10-15]
10_manual/web/internals/Wires.stl
105.2 x 16.5 x 128.1
