TANACHAT007/diy-spirometer/10_manual/web/internals/Magnets_5x2.stl

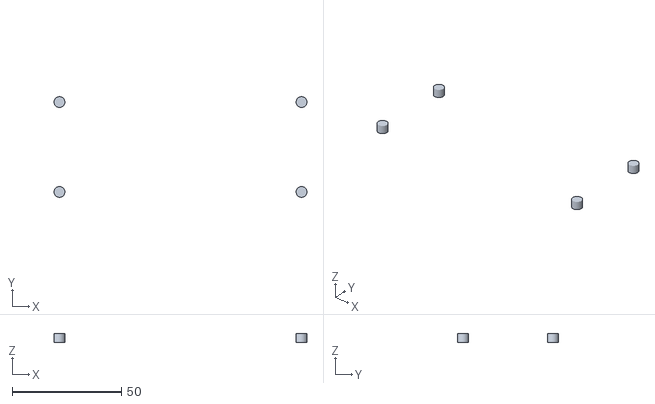
[picture p47: CAD file, 2026-10-15]
10_manual/web/internals/Magnets_5x2.stl
116.0 x 46.2 x 4.00
