TANACHAT007/diy-spirometer/10_manual/web/internals/E5_Button_6x6.stl

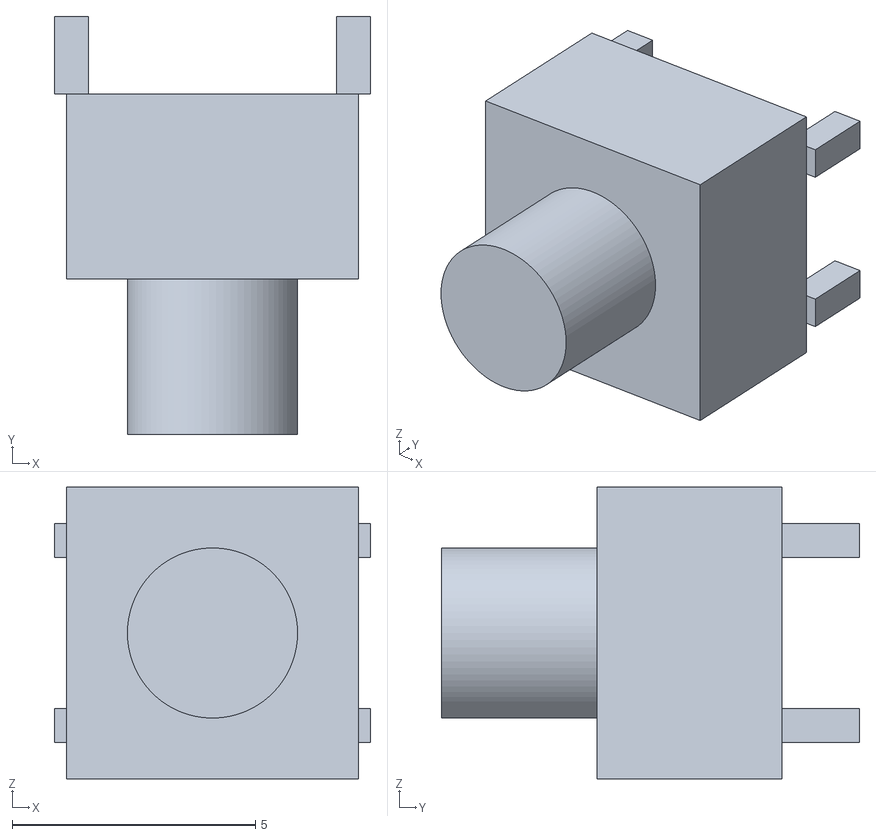
[picture p48: CAD file, 2026-10-15]
10_manual/web/internals/E5_Button_6x6.stl
6.50 x 8.60 x 6.00
