TANACHAT007/diy-spirometer/10_manual/web/internals/Silicone_Tube_3x5.stl

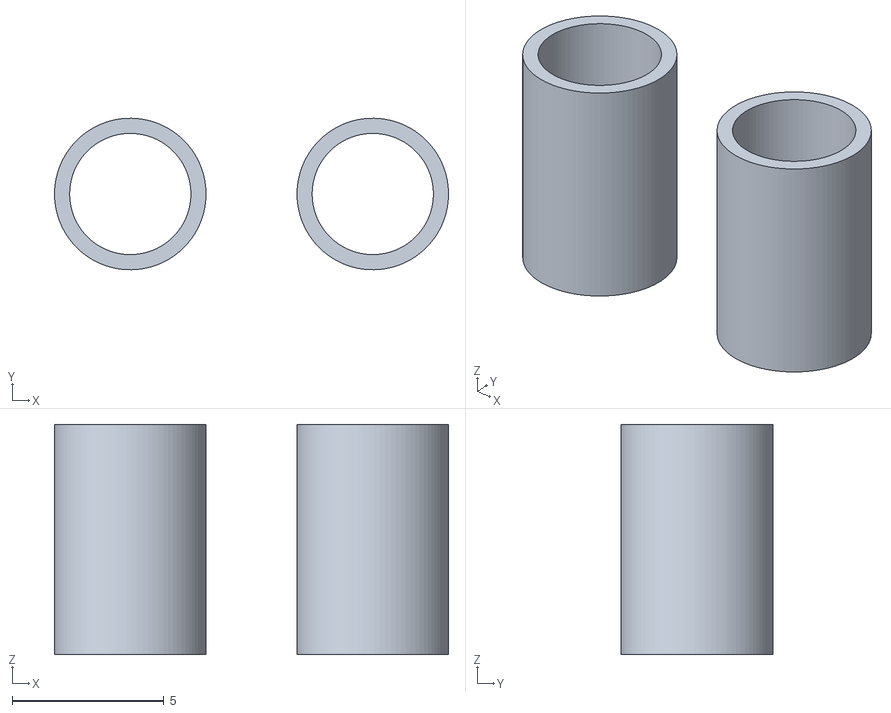
[picture p49: CAD file, 2026-10-15]
10_manual/web/internals/Silicone_Tube_3x5.stl
13.0 x 5.00 x 7.60
