TANACHAT007/diy-spirometer/10_manual/web/internals/E1_XIAO_ESP32S3.stl

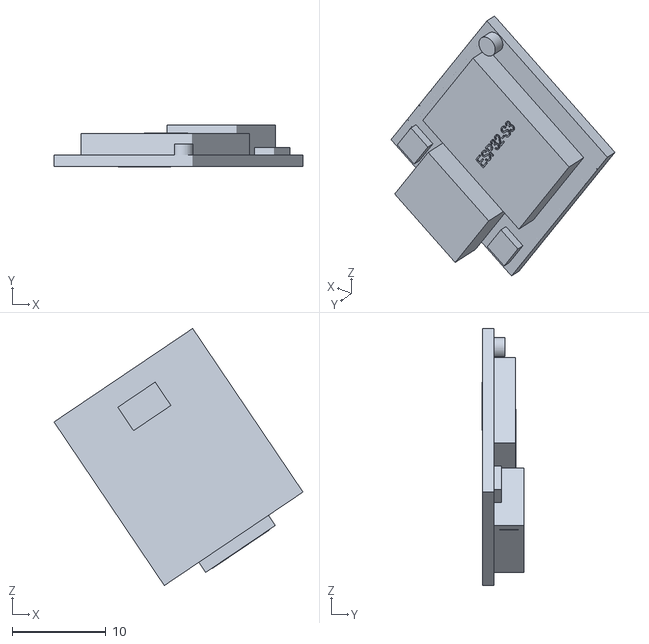
[picture p50: CAD file, 2026-10-15]
10_manual/web/internals/E1_XIAO_ESP32S3.stl
26.5 x 4.45 x 27.4
