TANACHAT007/diy-spirometer/10_manual/web/internals/E4_LiPo_603450.stl

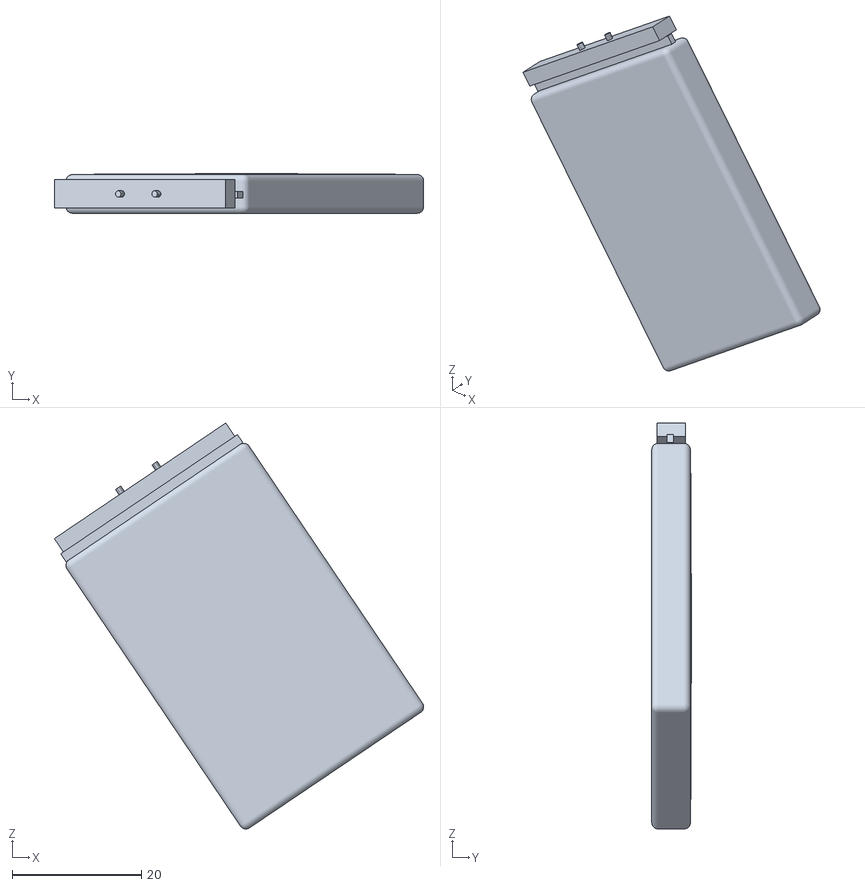
[picture p51: CAD file, 2026-10-15]
10_manual/web/internals/E4_LiPo_603450.stl
57.2 x 6.13 x 62.8
