TANACHAT007/diy-spirometer/10_manual/web/internals/E3_GC9A01_Round_TFT.stl

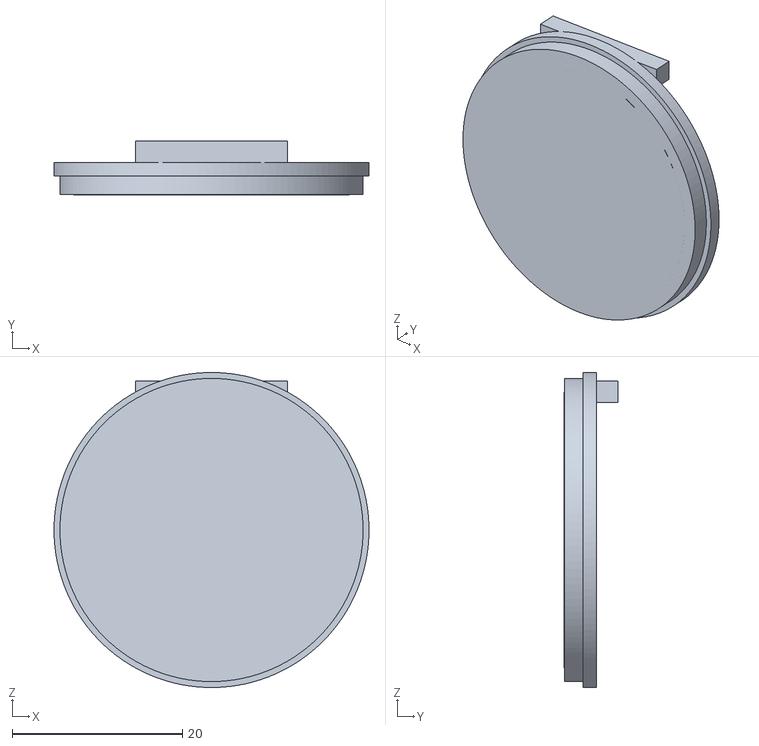
[picture p52: CAD file, 2026-10-15]
10_manual/web/internals/E3_GC9A01_Round_TFT.stl
37.0 x 6.32 x 37.0
