TANACHAT007/diy-spirometer/10_manual/web/internals/Charge_Contacts.stl

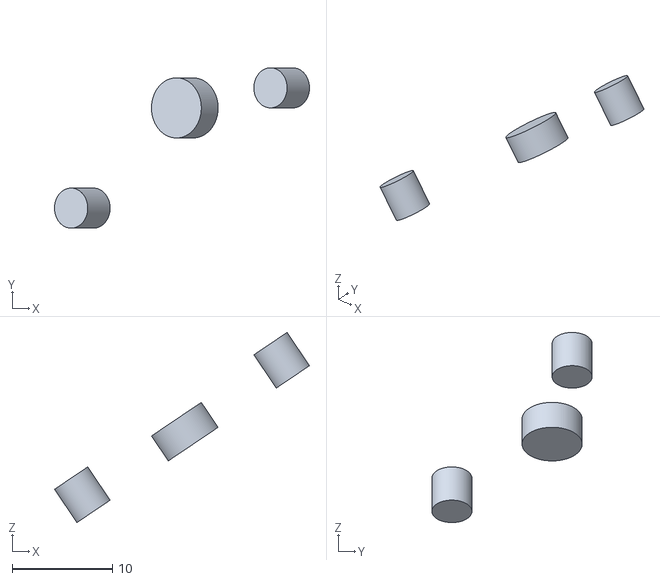
[picture p53: CAD file, 2026-10-15]
10_manual/web/internals/Charge_Contacts.stl
25.4 x 16.0 x 19.0
