TANACHAT007/diy-spirometer/10_manual/web/internals/Pogo_Pins.stl

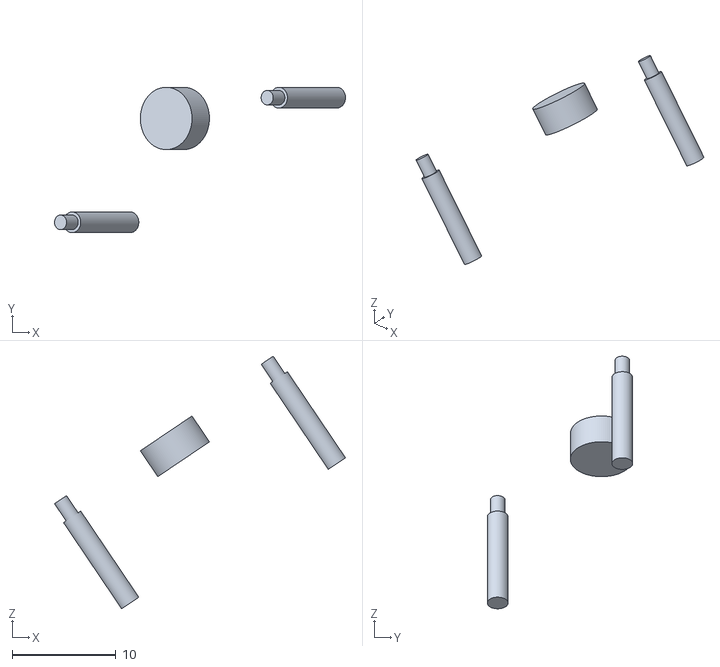
[picture p54: CAD file, 2026-10-15]
10_manual/web/internals/Pogo_Pins.stl
28.0 x 14.0 x 24.3
