TANACHAT007/diy-spirometer/(list of files, cad)

Other CAD files:
04_print_stl/dock_right.stl
04_print_stl/housing_left.stl
04_print_stl/print_ready/plate2_housing_right.stl
