TANACHAT007/diy-spirometer/04_print_stl/print_guide.md

# Print guide — diy-spirometer (Bambu A1, PETG)

Totals (model v3, 2026-10-15): ≈470 g PETG, ≈27 h, ≈360 THB. All parts fit the 256 mm bed.
Profile: 0.2 mm layer, 4 walls (≥1.6 mm), 20 % gyroid, 0.4 nozzle. Printed hole sizes already include the 0.4 mm fit rule.

| Part | File | Orientation | Supports | Notes |
|---|---|---|---|---|
| Housing left | housing_left.stl | **seam face down** (open side on the bed; STL analysis 2026-10-21: outer flat face is 9 mm above the barrel tangent, so outer-down needs supports under the visible face) | **auto tree supports inside the open cavity**, Z gap 0.25-0.3 mm (PETG sticks); remove by hand/pliers through the open side | blue; heat-set M3x5 inserts go into the **right** half only |
| Housing right | housing_right.stl | seam face down | as above | 4 × M3x5x4.5 inserts at the seam bosses, 1 × 6x3 magnet pocket in the grip end |
| Flow tube | flow_tube.stl | **vertical, mouth end down** | exit ring (flat 3 mm lip) + the manifold block's horizontal channel need small supports/bridging; mouth ring is 45° (no support) | white; the venturi cone prints at 10.5° from vertical = clean. Do NOT print lying down (venturi would be oval). Test the channel with a Ø2 mm wire before use |
| Top cover | top_cover.stl | flat side (z=0) down | none | 4 × 5x2 magnets glued, polarity checked against the housing seats |
| Mouthpiece (DISPOSABLE) | mouthpiece.stl | wide end down | none | **PETG (prototype; later replace with agri-waste pulp/paper).** 0.2 mm layers, 2 walls, 10 % infill, ~11 g ≈ 5 THB, ~40 min. Print a batch of 10. One per person; replace after 20 blows or 7 days (the device counts; hold button 4 s after fitting a new one). PETG is not biodegradable; do not wash and reuse across people (it is not a bacterial filter). |
| Display bezel | bezel.stl | flat | none | **white**, glue into the 0.6 mm rebate around the display window (CA gel, keep glue off the glass) |
| Button cap | button_cap.stl | domed side down? **flat side (socket) up** | none | **white**, press onto the tact stem + one tiny drop of glue |
| Dock left | dock_left.stl | **split face (y=0) down** | none; cavity is closed at the top, tree supports only if the slicer asks | cavity for USB-C board, 1 pogo hole Ø2.2 (y−6) in the cradle wall, light-guide strip + status LED seat; 3 × M3x40 csk heads on the outer face |
| Dock right | dock_right.stl | **split face (y=0) down** | as above | 3 × M3x5x4.5 heat-set inserts at the seam, 1 pogo hole Ø2.2 (y+6) + 6x3 magnet pocket in the cradle wall, light-guide strip seat |

## Post-print
1. Heat-set inserts at 220 °C with the iron tip straight; insert flush. Brass **contact** inserts (M3x4x4.5) go into the grip end of each half *before* closing (contacts are NOT on the seam: left half w=13, right half w=37).
2. Magnets: 5x2 mm ×8 (cover + housing seats), 6x3 mm ×2 (grip + dock). Test polarity with the parts together, then glue (CA).
3. Pogo pins: Ø2.0 barrel in the Ø2.2 holes, a drop of CA/hot-glue; solder wires to the rear ends.
4. Flow tube: ream the Ø2 channel, then check by blowing through each nipple — air must come out of the matching tap.
5. Leak test: plug the mouth end, put 3 L syringe on the exit, push to 300 Pa (≈3 cmH2O), pressure must hold; the venturi has no other seals than the 2 silicone stubs.

## Known risks (not yet verified by a real print)
- Manifold channel Ø2.4 printed horizontally (bridging) may sag → ream it.
- 2.4 mm shell wall is only 6 perimeters of 0.4 — OK for PETG but grip ridges are 1 mm deep.
- Venturi surface roughness changes the discharge coefficient → calibrate K after every re-print.

## Assembly order note (button + LED)
Solder the 6x6 tact switch and the 3 mm LED to the 13x29 mm perfboard first (stem and LED face the same side, away from the board). Drop the board onto the two bosses on the inside of the left housing so the tact stem and the LED body pass through their wall holes, then lock it with two M2x6 self-tapping screws. Only then fit the display, battery and close the housings. Press the white button cap onto the stem last.
