TANACHAT007/diy-spirometer/10_manual/web/img/story/PROMPTS.md

# Gemini / image prompts for the 6 story cards (16:10, 1600x1000, no text in the image)
Save as s1.jpg ... s6.jpg in this folder, then tell Claude "รูปใส่แล้ว". Style for all: soft 3D clay/cartoon render, pastel, clean studio light, sky-blue + warm straw colours, no text, no logos.
s1: Thai sugarcane/rice field after harvest, farmer's stubble burning at dusk, thick grey smoke rising into hazy sky, soft 3D clay style, wide shot.
s2: Cutaway illustration of human lungs in soft pink with tiny grey PM2.5 dust particles drifting in, light-blue background, soft 3D clay style, friendly medical look.
s3: Process scene: rice straw and sugarcane leaves -> pulping vat -> moulding press -> small paper-pulp mouthpiece tubes, left-to-right, soft 3D clay style, warm straw tones.
s4: Pistol-grip handheld sky-blue and white spirometer with a brown paper-pulp mouthpiece being pulled off the front, pastel studio background, soft 3D product render.
s5: Three round mouthpiece samples side by side on a table: blue 3D-printed PETG, brown moulded straw pulp, cream rolled paper; soft studio light, 3D clay style.
s6: Circular economy loop: farmer's field -> community pulp workshop -> mouthpiece -> child blowing into a spirometer at a health clinic -> back to field; friendly soft 3D clay style, pastel.
