TANACHAT007/diy-spirometer/10_manual/drawings/Spiro_part_drawings.pdf

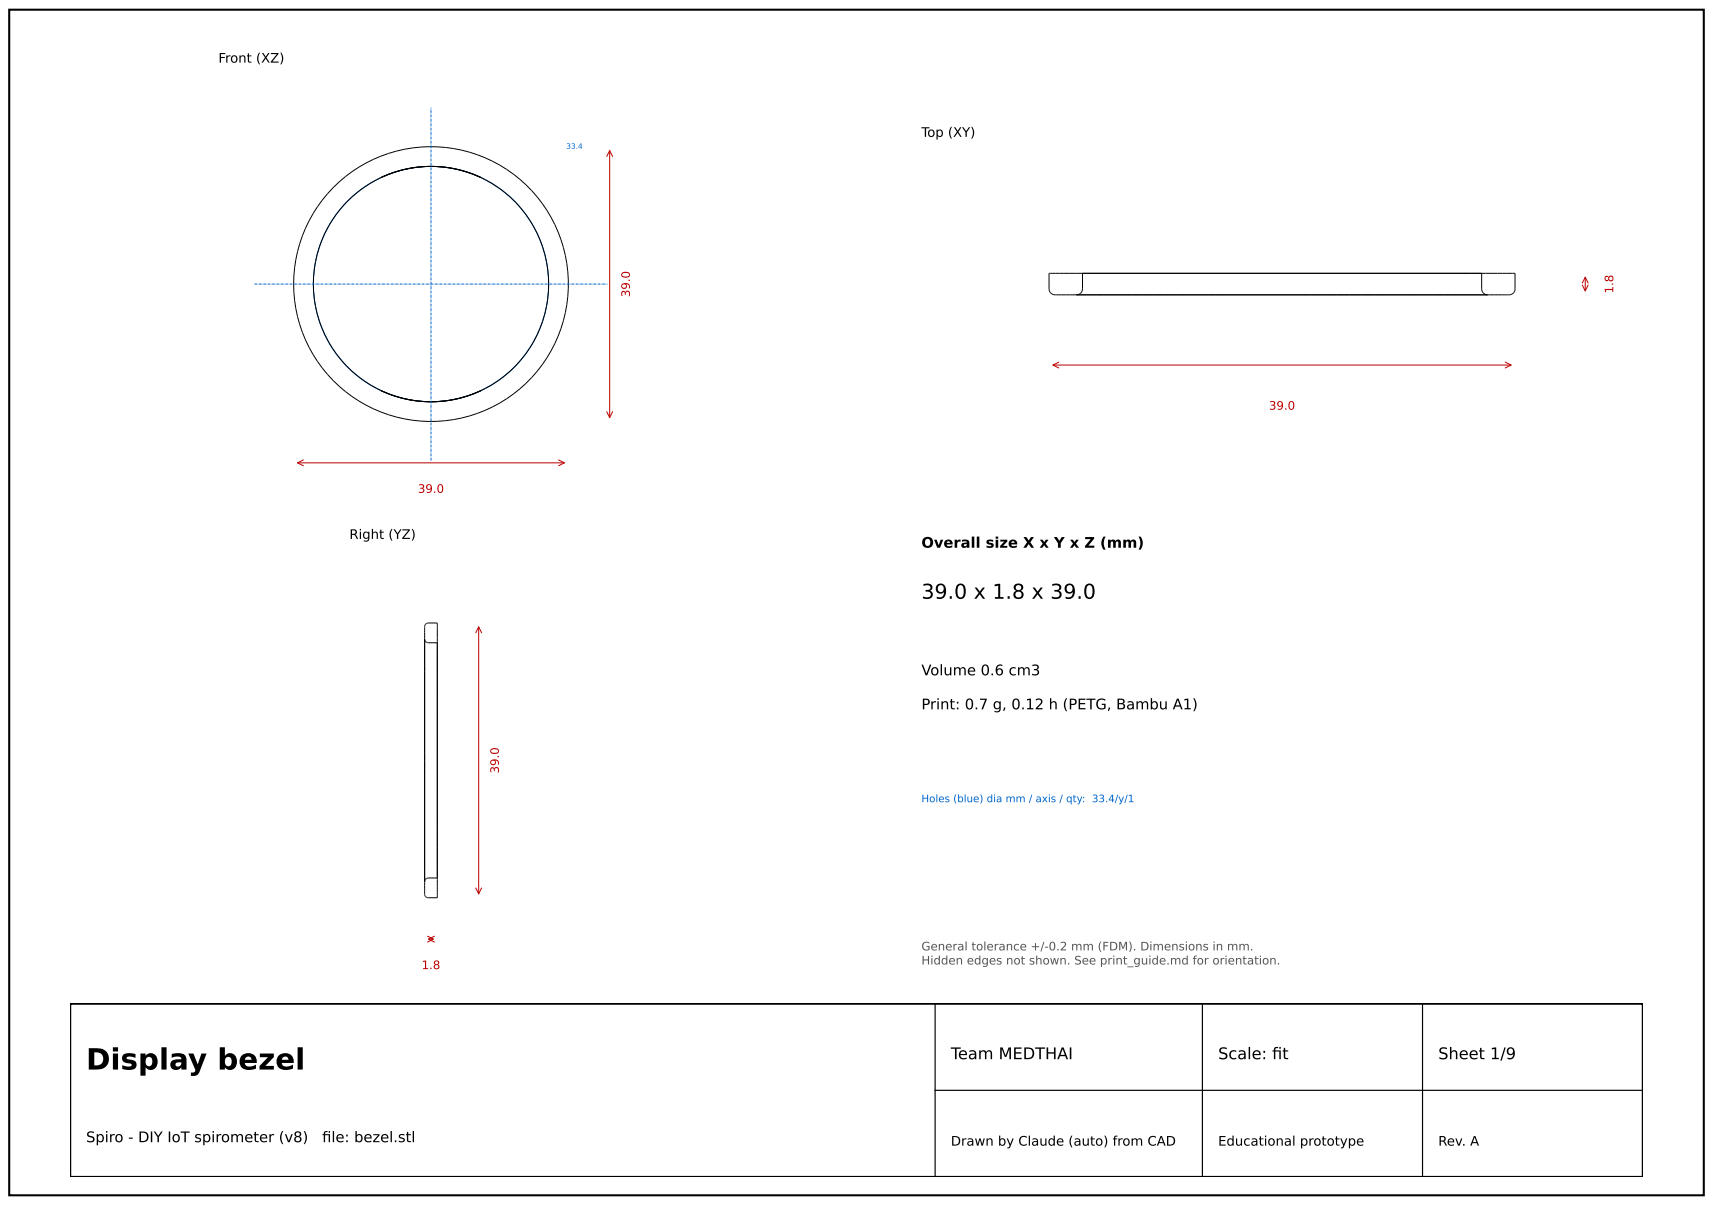
[picture p57: page 1]
Front (XZ); Top (XY); Right (YZ); Overall size X x Y x Z (mm); Volume 0.6 cm3; Display bezel; Team MEDTHAI; Scale: fit; Educational prototype; Sheet 1/9; Rev. A

Print: 0.7 g, 0.12 h (PETG, Bambu A1)

Holes (blue) dia mm / axis / qty: 33.4/y/1

General tolerance +/-0.2 mm (FDM). Dimensions in mm.
Hidden edges not shown. See print_guide.md for orientation.

Spiro - DIY IoT spirometer (v8) file: bezel.stl

Drawn by Claude (auto) from CAD

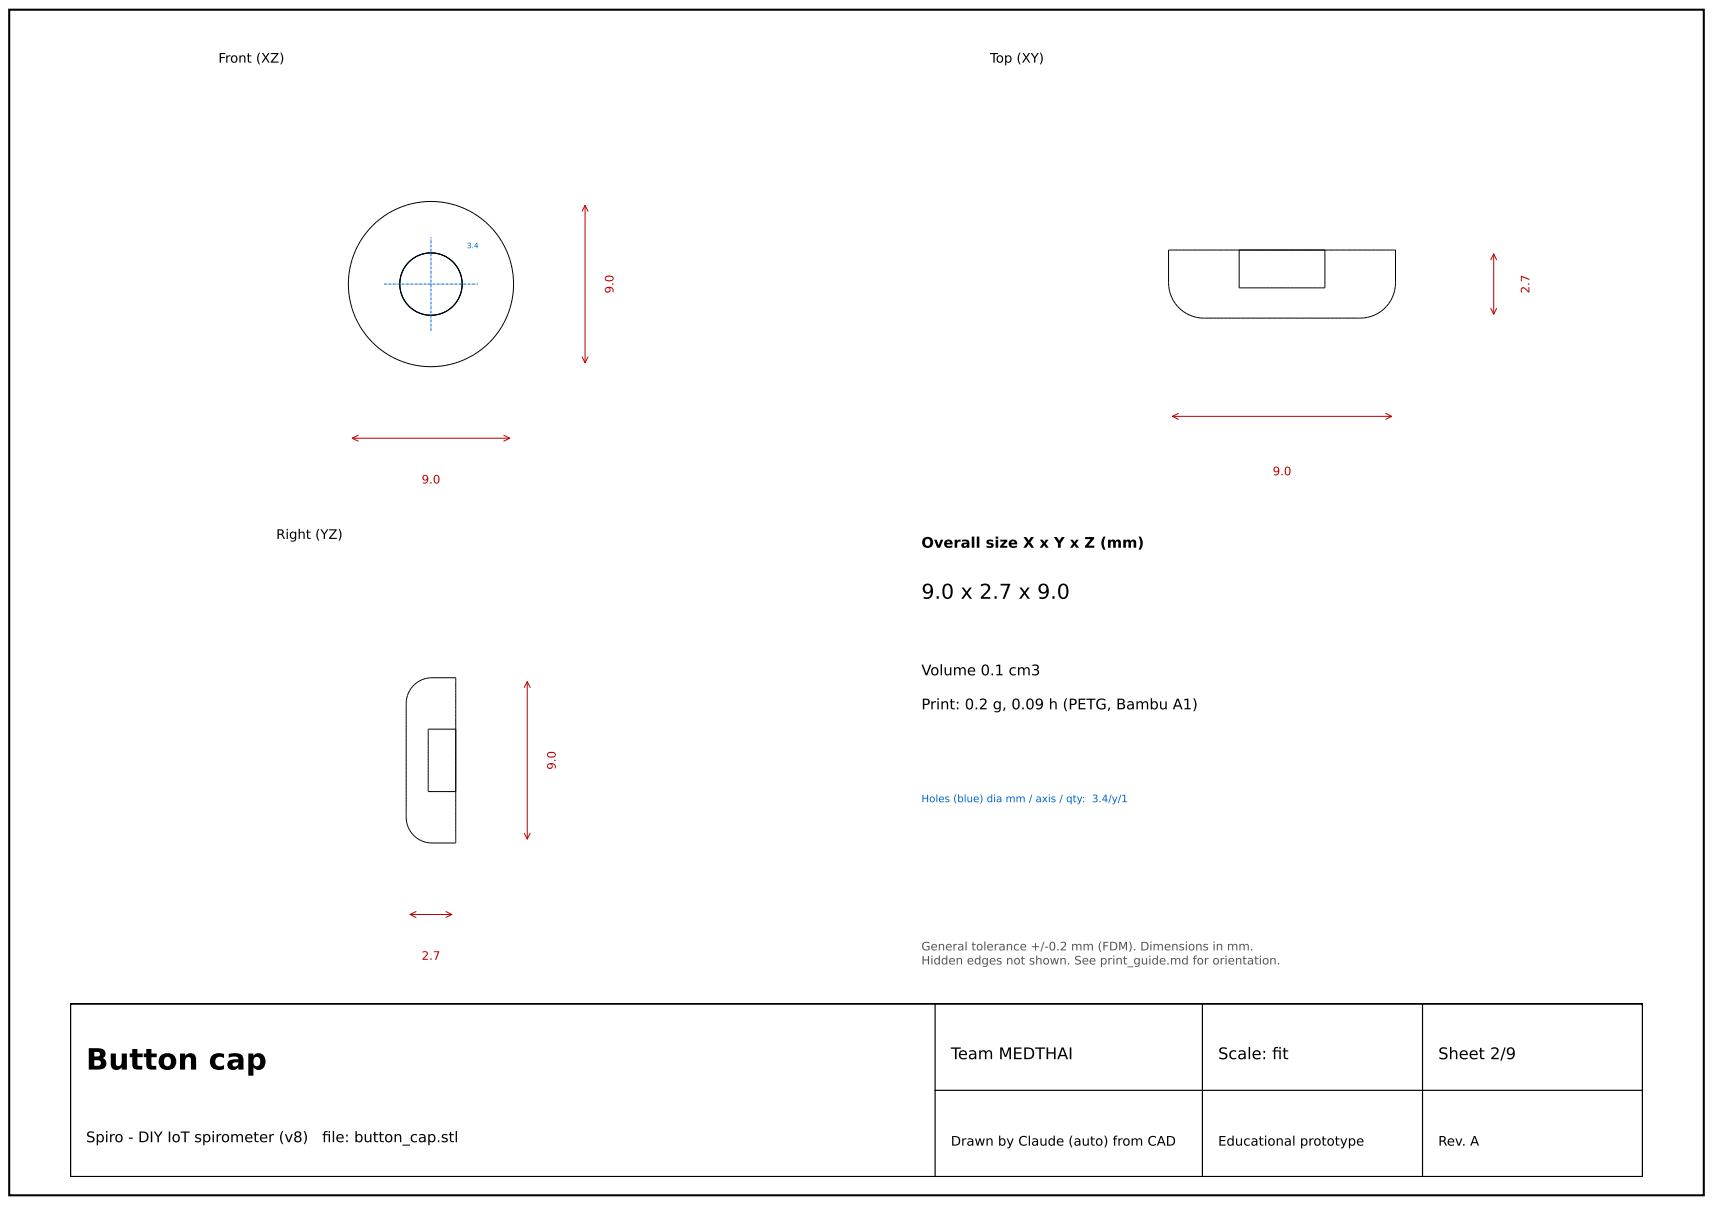
[picture p58: page 2]
Top (XY); Right (YZ); Overall size X x Y x Z (mm); Volume 0.1 cm3; Button cap; Team MEDTHAI; Scale: fit; Sheet 2/9

Print: 0.2 g, 0.09 h (PETG, Bambu A1)

Holes (blue) dia mm / axis / qty: 3.4/y/1

General tolerance +/-0.2 mm (FDM). Dimensions in mm.
Hidden edges not shown. See print_guide.md for orientation.

Spiro - DIY IoT spirometer (v8) file: button_cap.stl

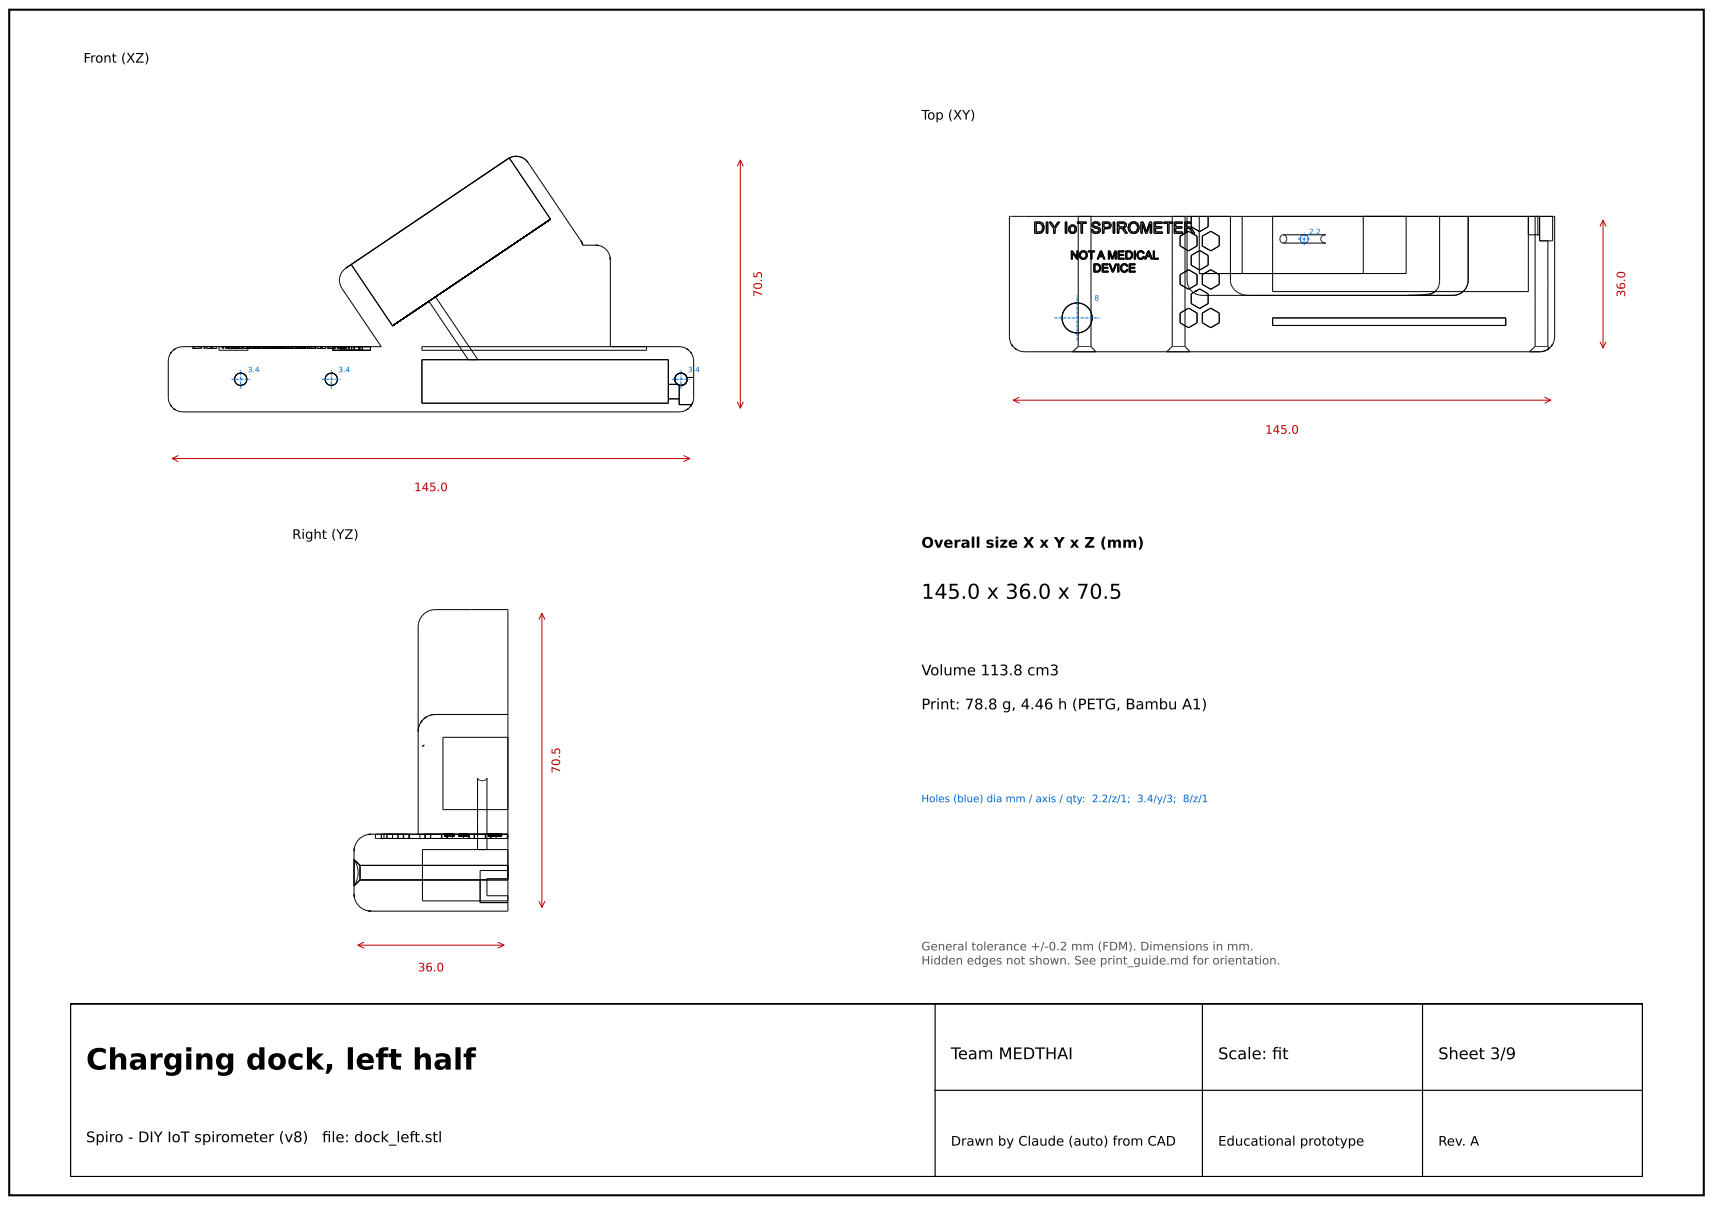
[picture p59: page 3]
Top (XY); Right (YZ); Overall size X x Y x Z (mm); Volume 113.8 cm3; Team MEDTHAI; Scale: fit; Sheet 3/9

Print: 78.8 g, 4.46 h (PETG, Bambu A1)

Holes (blue) dia mm / axis / qty: 2.2/z/1; 3.4/y/3; 8/z/1

General tolerance +/-0.2 mm (FDM). Dimensions in mm.
Hidden edges not shown. See print_guide.md for orientation.

Charging dock, left half

Spiro - DIY IoT spirometer (v8) file: dock_left.stl

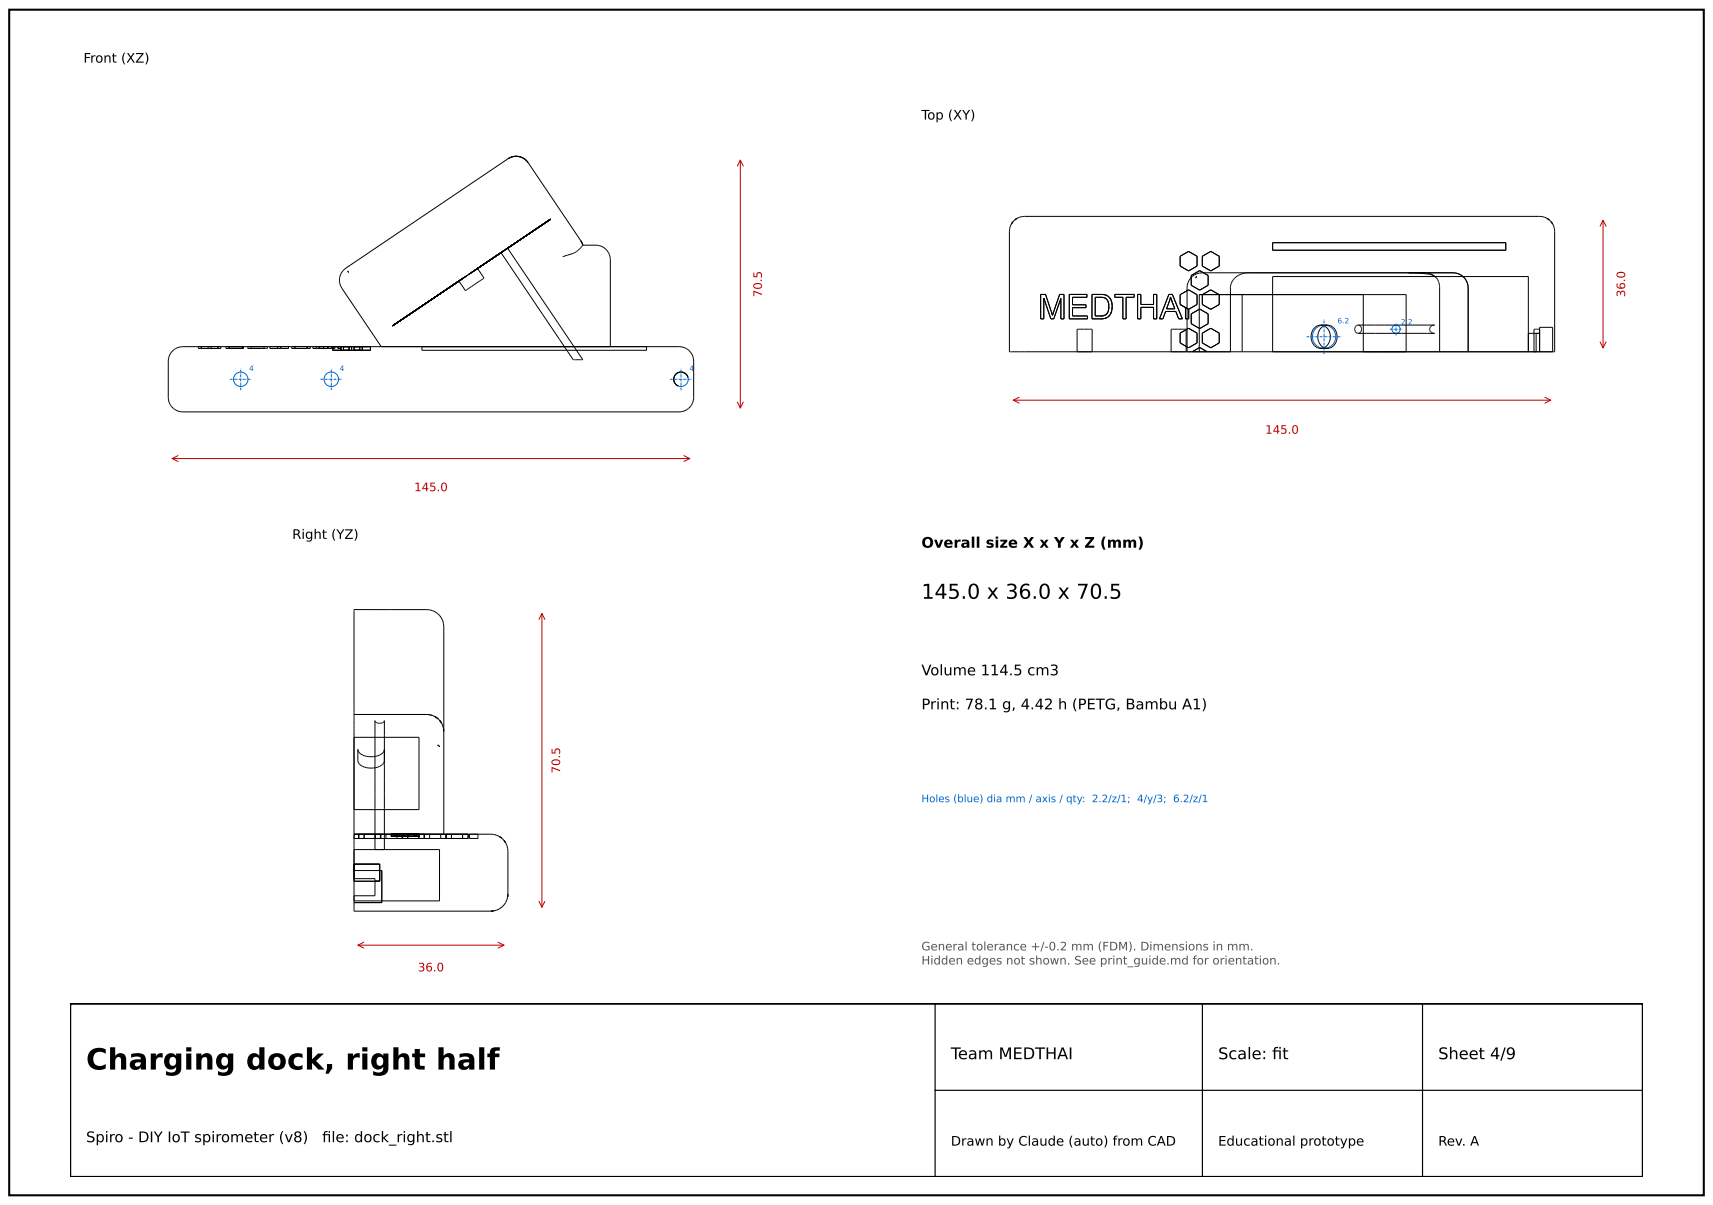
[picture p60: page 4]
Top (XY); Right (YZ); Overall size X x Y x Z (mm); Volume 114.5 cm3; Team MEDTHAI; Scale: fit; Sheet 4/9

Print: 78.1 g, 4.42 h (PETG, Bambu A1)

Holes (blue) dia mm / axis / qty: 2.2/z/1; 4/y/3; 6.2/z/1

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

Charging dock, right half

Spiro - DIY IoT spirometer (v8) file: dock_right.stl

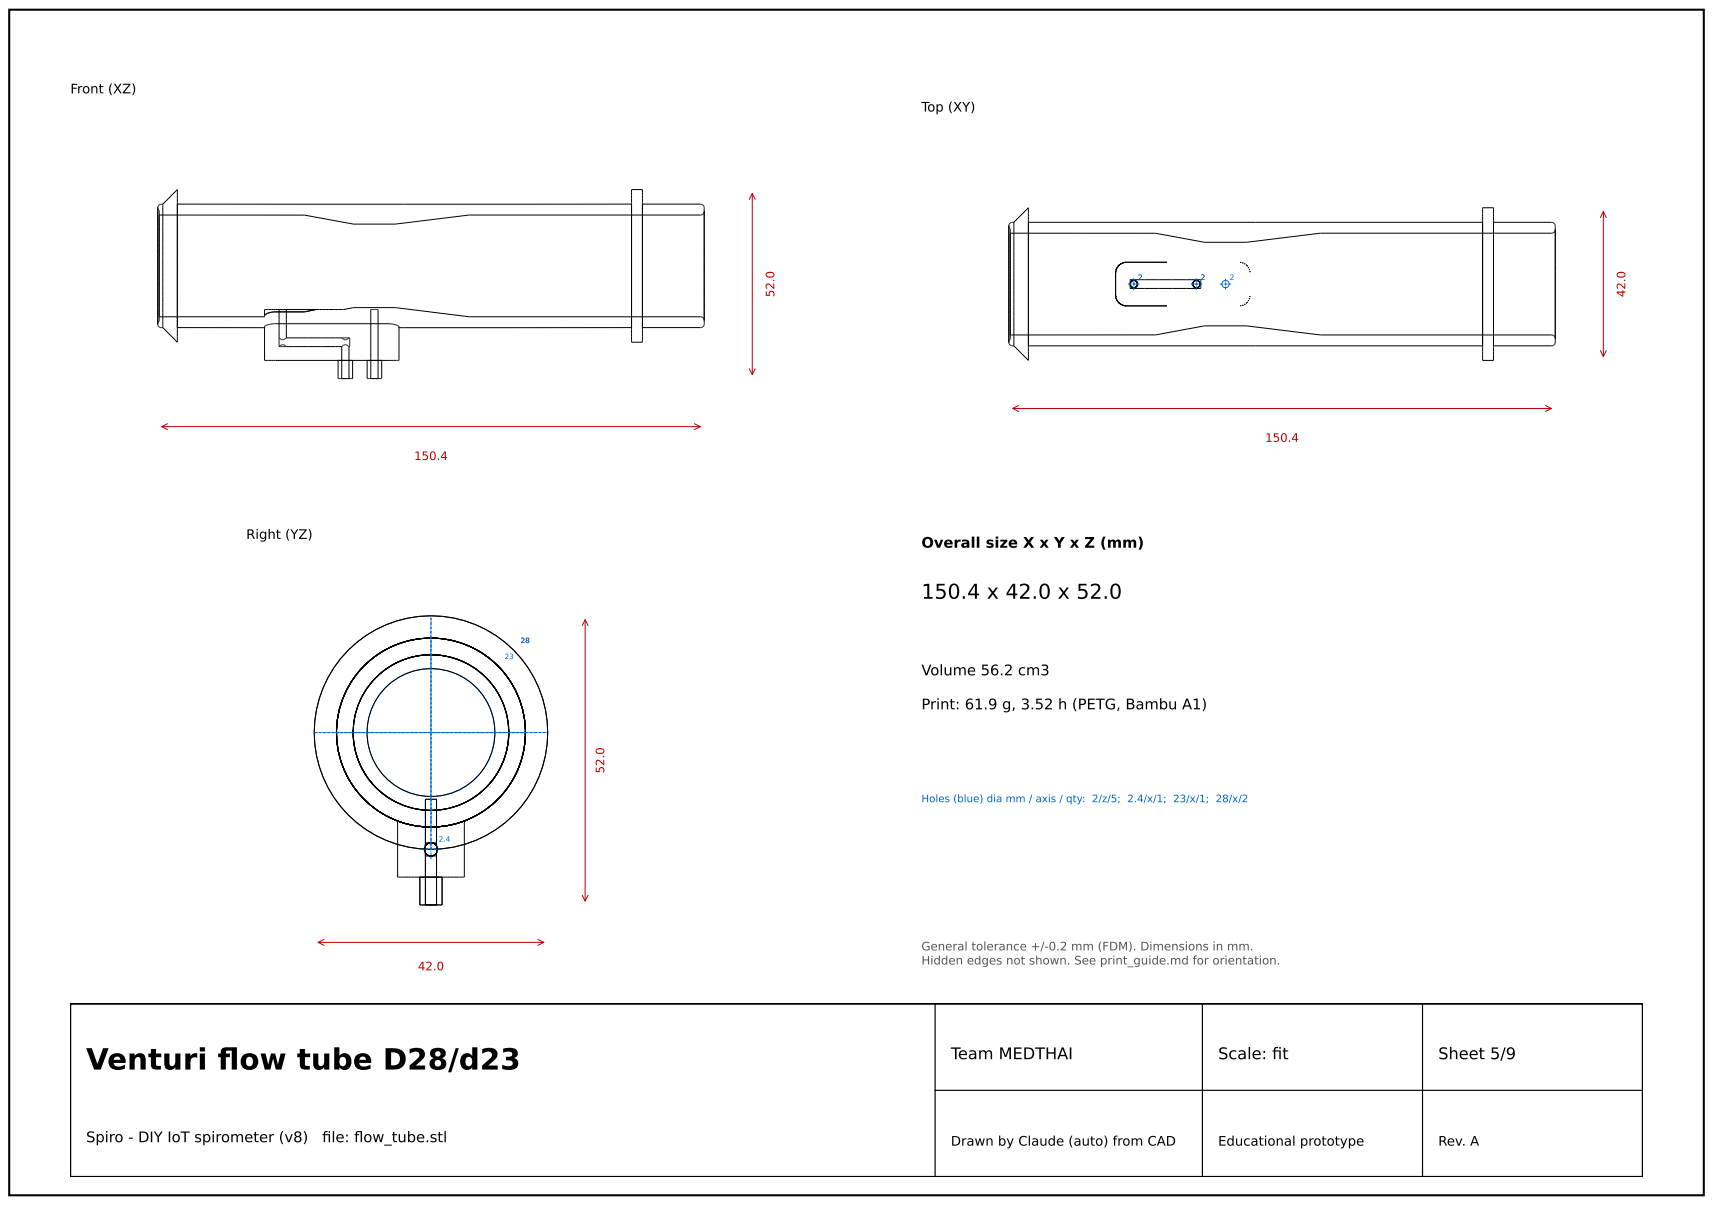
[picture p61: page 5]
Top (XY); Right (YZ); Overall size X x Y x Z (mm); Volume 56.2 cm3; Team MEDTHAI; Scale: fit; Sheet 5/9

Print: 61.9 g, 3.52 h (PETG, Bambu A1)

Holes (blue) dia mm / axis / qty: 2/z/5; 2.4/x/1; 23/x/1; 28/x/2

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

Venturi flow tube D28/d23

Spiro - DIY IoT spirometer (v8) file: flow_tube.stl

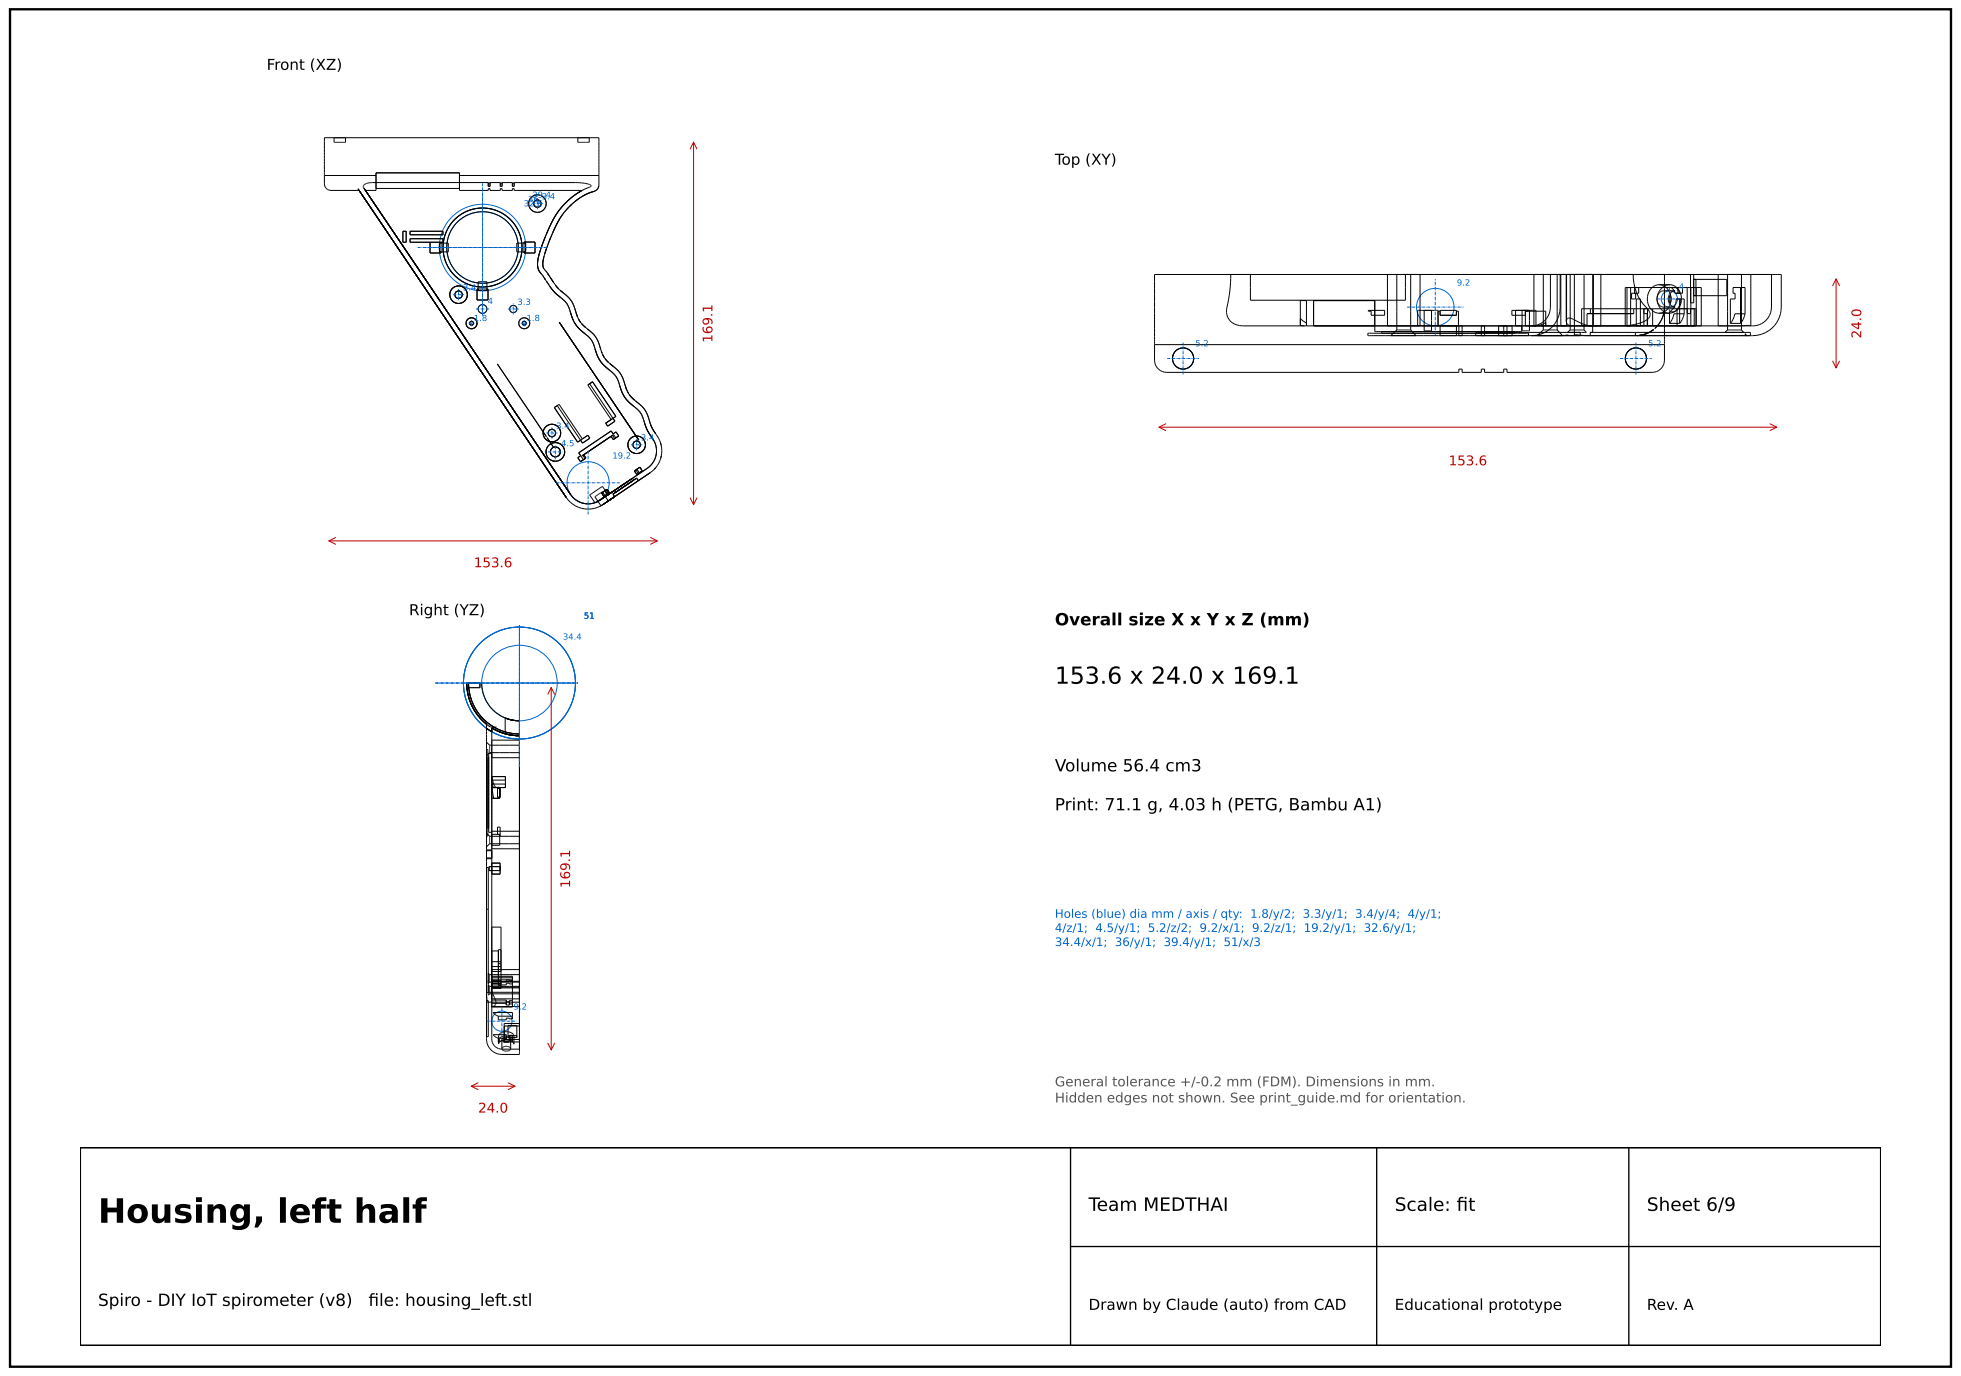
[picture p62: page 6]
Top (XY); Right (YZ); Overall size X x Y x Z (mm); Volume 56.4 cm3; Team MEDTHAI; Scale: fit; Sheet 6/9

Print: 71.1 g, 4.03 h (PETG, Bambu A1)

Holes (blue) dia mm / axis / qty: 1.8/y/2; 3.3/y/1; 3.4/y/4; 4/y/1;

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

Housing, left half

Spiro - DIY IoT spirometer (v8) file: housing_left.stl

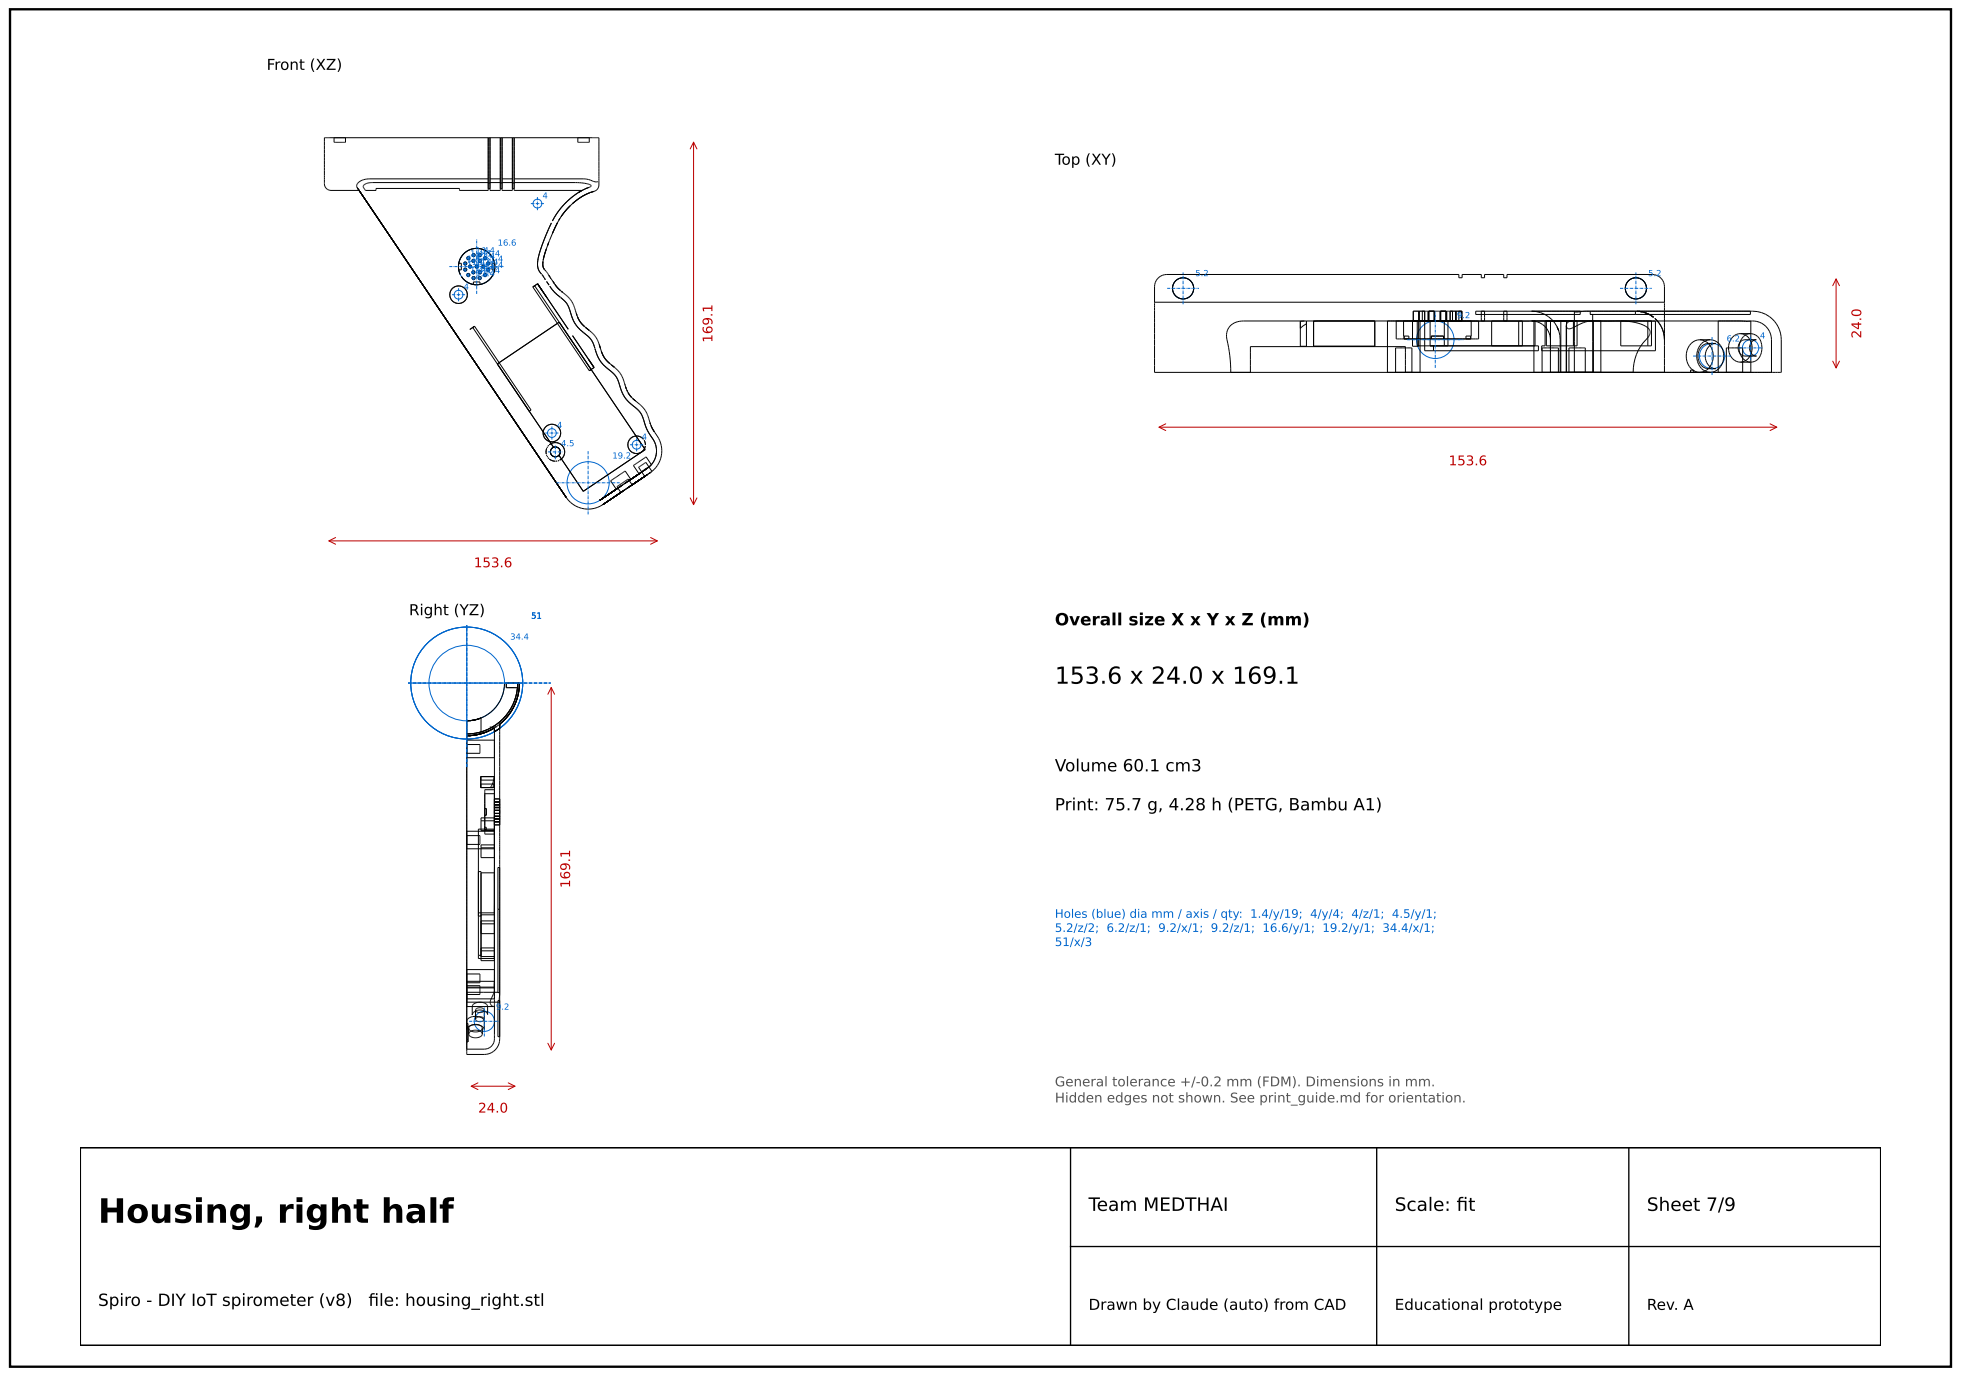
[picture p63: page 7]
Top (XY); Right (YZ); Overall size X x Y x Z (mm); Volume 60.1 cm3; Team MEDTHAI; Scale: fit; Sheet 7/9

Print: 75.7 g, 4.28 h (PETG, Bambu A1)

Holes (blue) dia mm / axis / qty: 1.4/y/19; 4/y/4; 4/z/1; 4.5/y/1;

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

Housing, right half

Spiro - DIY IoT spirometer (v8) file: housing_right.stl

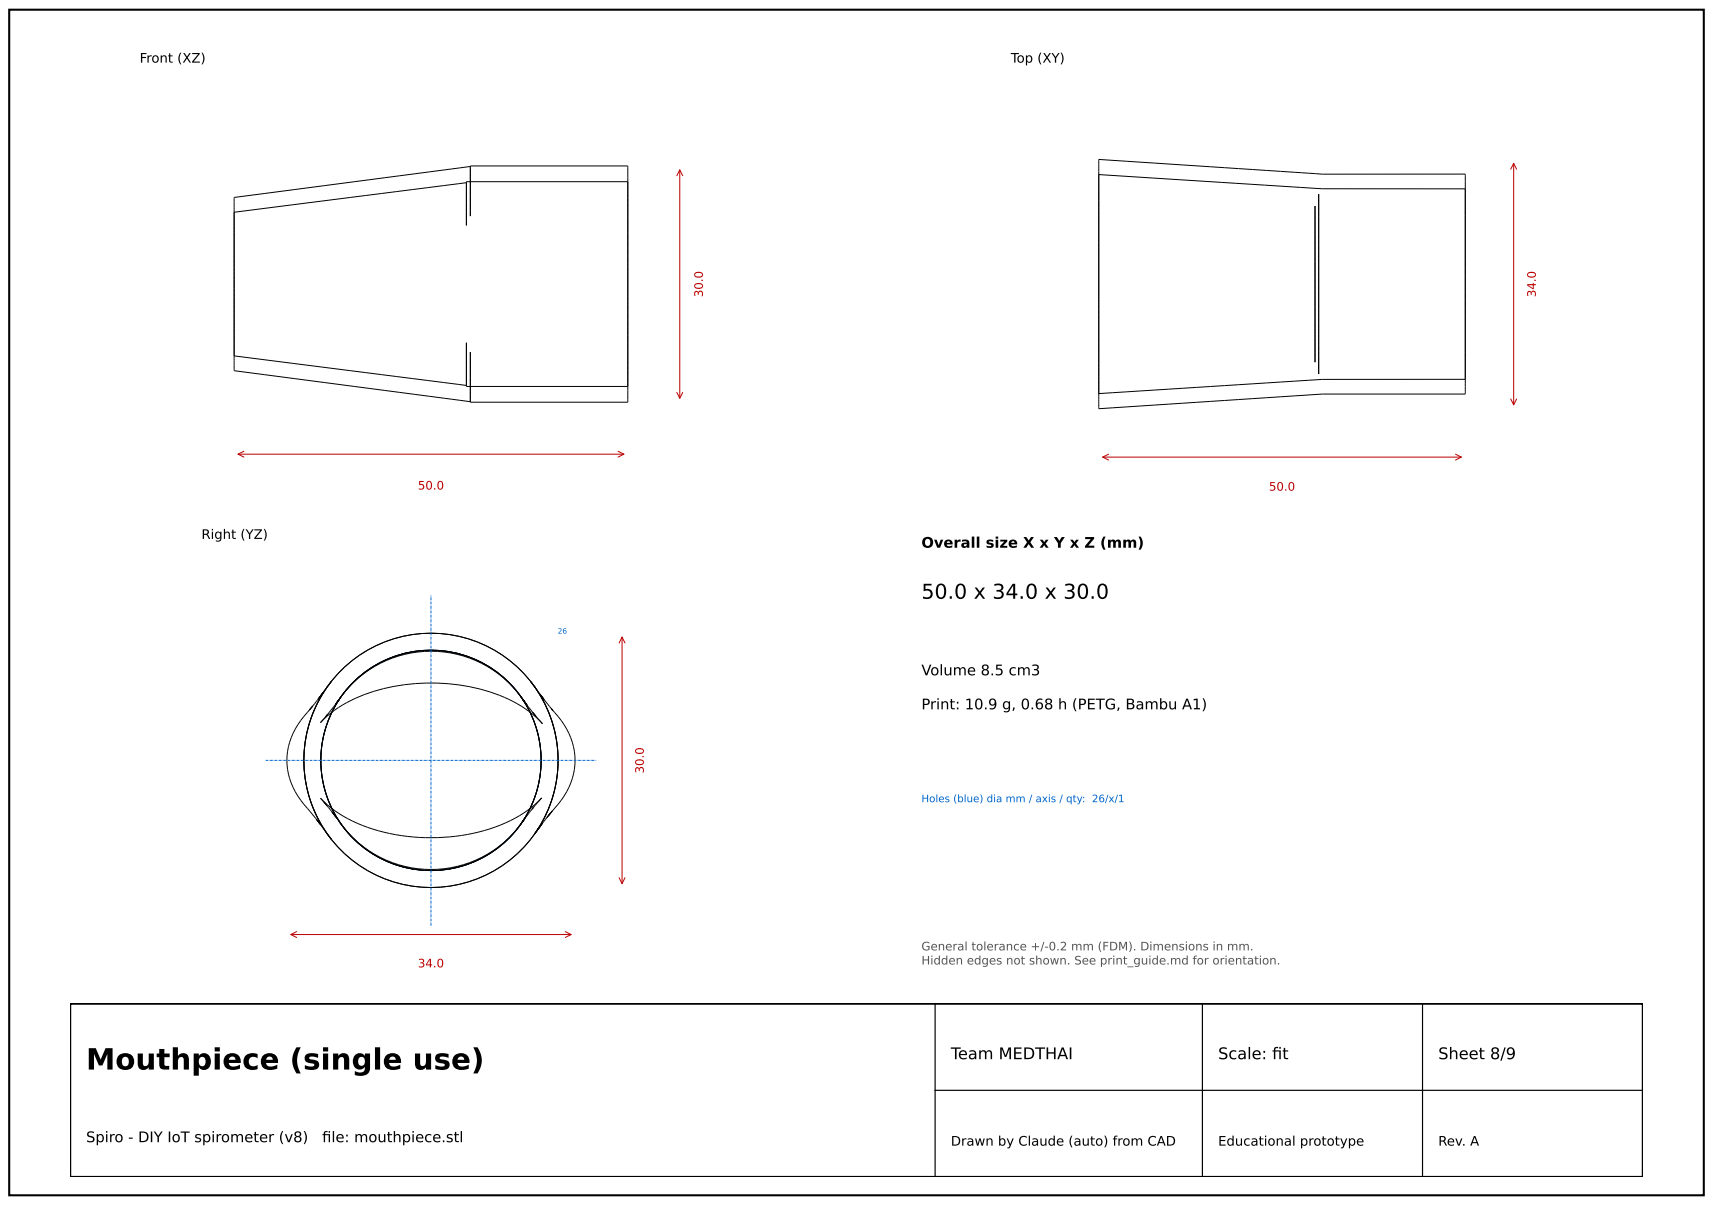
[picture p64: page 8]
Top (XY); Right (YZ); Overall size X x Y x Z (mm); Volume 8.5 cm3; Team MEDTHAI; Scale: fit; Sheet 8/9

Print: 10.9 g, 0.68 h (PETG, Bambu A1)

Holes (blue) dia mm / axis / qty: 26/x/1

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

Mouthpiece (single use)

Spiro - DIY IoT spirometer (v8) file: mouthpiece.stl

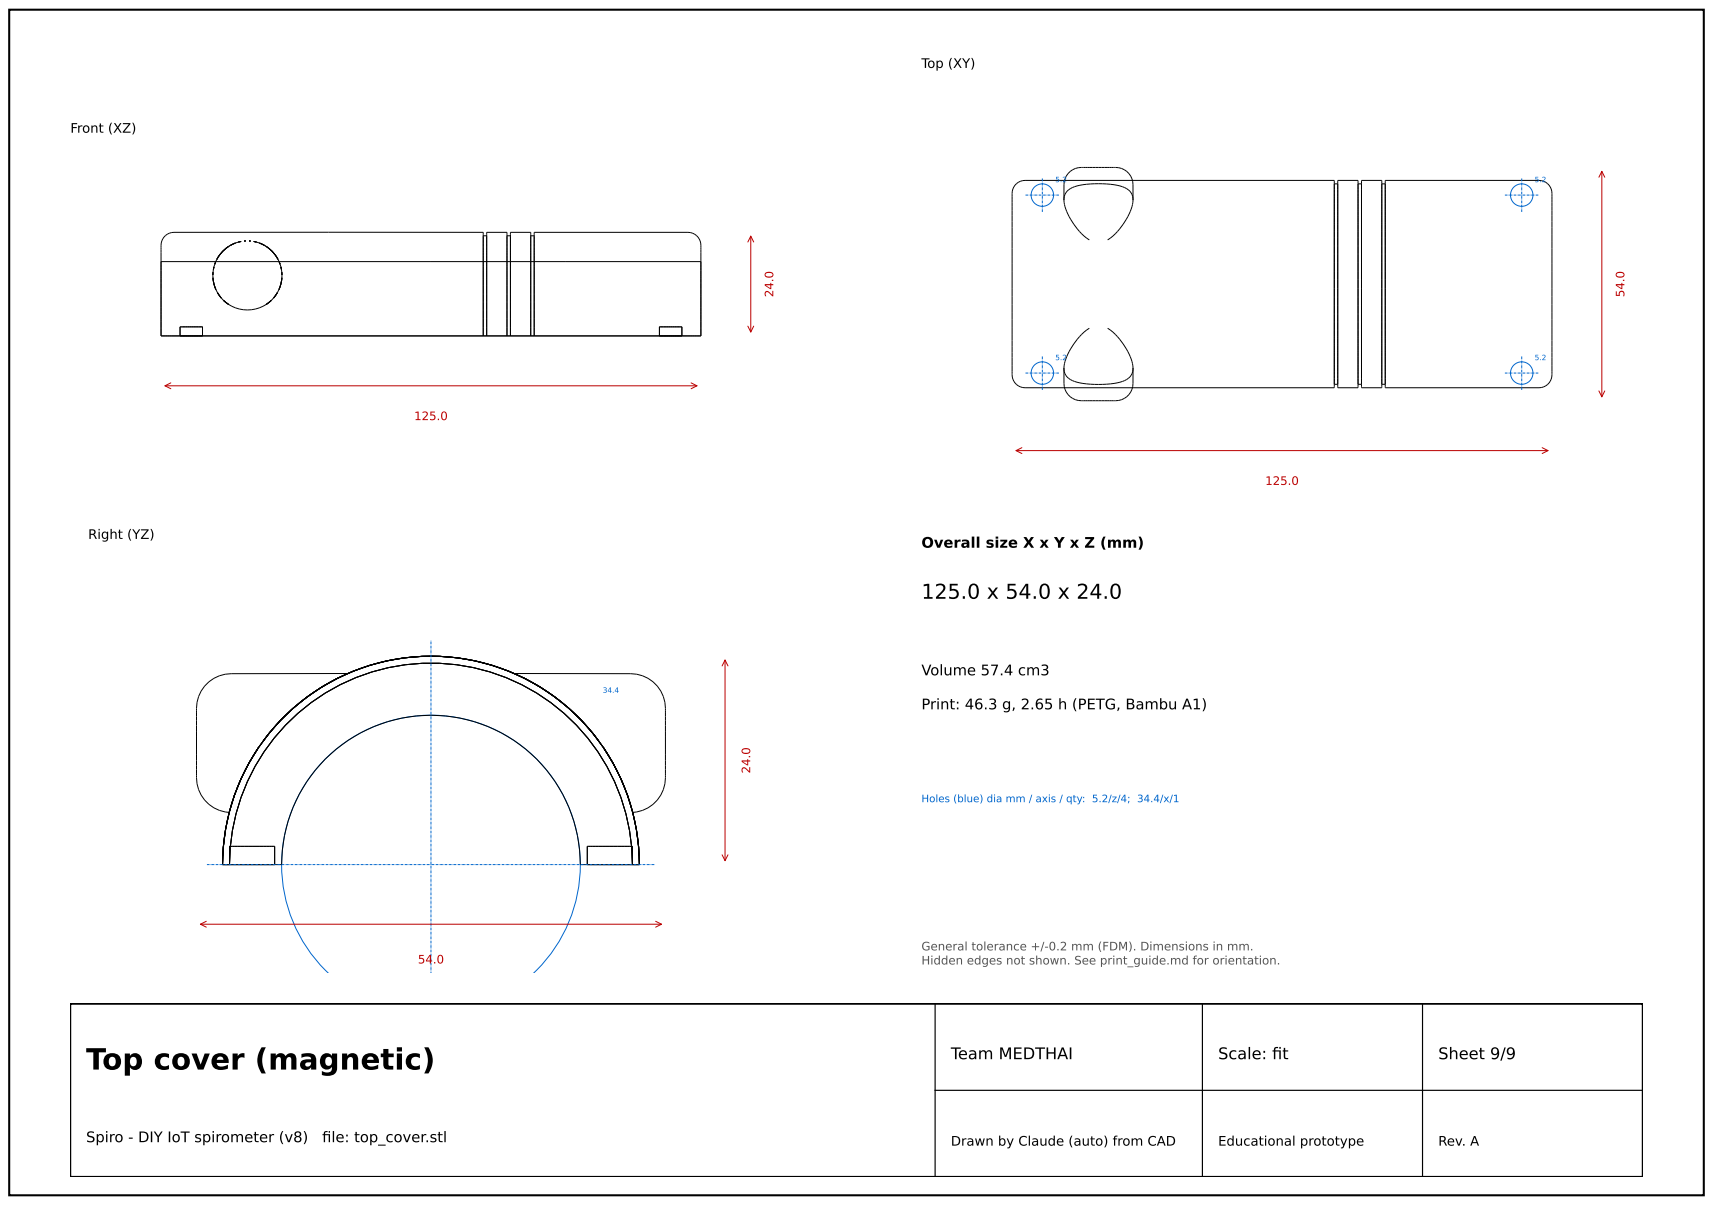
[picture p65: page 9]
Front (XZ); Top (XY); Right (YZ); Overall size X x Y x Z (mm); Volume 57.4 cm3; Team MEDTHAI; Scale: fit; Sheet 9/9

Print: 46.3 g, 2.65 h (PETG, Bambu A1)

Holes (blue) dia mm / axis / qty: 5.2/z/4; 34.4/x/1

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

Top cover (magnetic)

Spiro - DIY IoT spirometer (v8) file: top_cover.stl
