TANACHAT007/diy-spirometer/10_manual/iys_essay/CHECKLIST_TH.md

# สิ่งที่ต้องส่ง 7th IYS (ตาม GUIDE BOOK) — มีแค่นี้

ปิดรับ Batch 2: **18 ต.ค. 2026** (ค่าสมัคร USD 10 ต่อบทความ) ประกาศผลรอบแรก 24 ต.ค.
Poster + พรีเซนต์ ใช้เฉพาะ Top 100 ในรอบสุดท้าย (ไม่ต้องส่งตอนสมัคร)

| # | รายการ | สถานะ |
|---|---|---|
| 1 | **บทความ (Essay)** `IYS7_Health_Spiro_essay.docx` (+ PDF) Times New Roman 12 มีเลขหน้า ตั้งแต่ Introduction ถึง Conclusion 3-10 หน้า (ตอนนี้ 8 หน้า) | ทำแล้ว ต้องกรอกชื่อสมาชิก+สถาบันในหน้าปก |
| 2 | **Registration Form** ที่ https://linktr.ee/InternationalYouthSummit_IYS | คุณกรอกเอง |
| 3 | **Submission Form** (แนบบทความ) ที่ลิงก์เดียวกัน ต้องส่งใน Batch เดียวกับที่สมัคร | คุณกรอกเอง |
| 4 | **โอนเงิน USD 10** BSI / Rizki Prima Sentosa / 1137118013 | คุณโอนเอง |
| 5 | **ยืนยันชำระเงินทาง WhatsApp 0878-4924-8204** รูปแบบข้อความข้างล่าง | คุณส่งเอง |
| 6 | **ยืนยันการส่งงานทาง WhatsApp เบอร์เดียวกัน** รูปแบบเดียวกัน | คุณส่งเอง |

รูปแบบข้อความ (ข้อ 5 และ 6):
`Health_7thIYS_Puttitada Pruetchayakul_Bodindecha (Sing Singhaseni) School_Thailand_Spiro A Low-Cost`
(ถ้าเปลี่ยนหัวหน้าทีม ให้เปลี่ยนชื่อและสถาบันในข้อความตาม)

เงื่อนไข: อายุ 15-27 ปี, ทีม 2-5 คน (หนึ่งคนเป็นหัวหน้า), บทความมากกว่า 10 หน้าจะไม่ถูกตรวจ

ทีม (5 คน เกณฑ์ 2-5): หัวหน้าทีม Puttitada Pruetchayakul (Bodindecha); สมาชิก Pimnara Roongsetthavitr (International Community School), Suchanan Kittikraisak (The Newton Sixth Form), Natnicha Taepucharoen (Samsenwittayalai), Nabhat Sethaudom (International Community School); ที่ปรึกษา Tanachat Srinurat
ต้องเช็ก: สมาชิกทุกคนอายุ 15-27 ปี, อีเมล/เบอร์โทรใช้กรอกในฟอร์ม linktr.ee เท่านั้น ไม่ได้ใส่ในบทความ
