TANACHAT007/diy-spirometer/10_manual/drawings/bezel.png

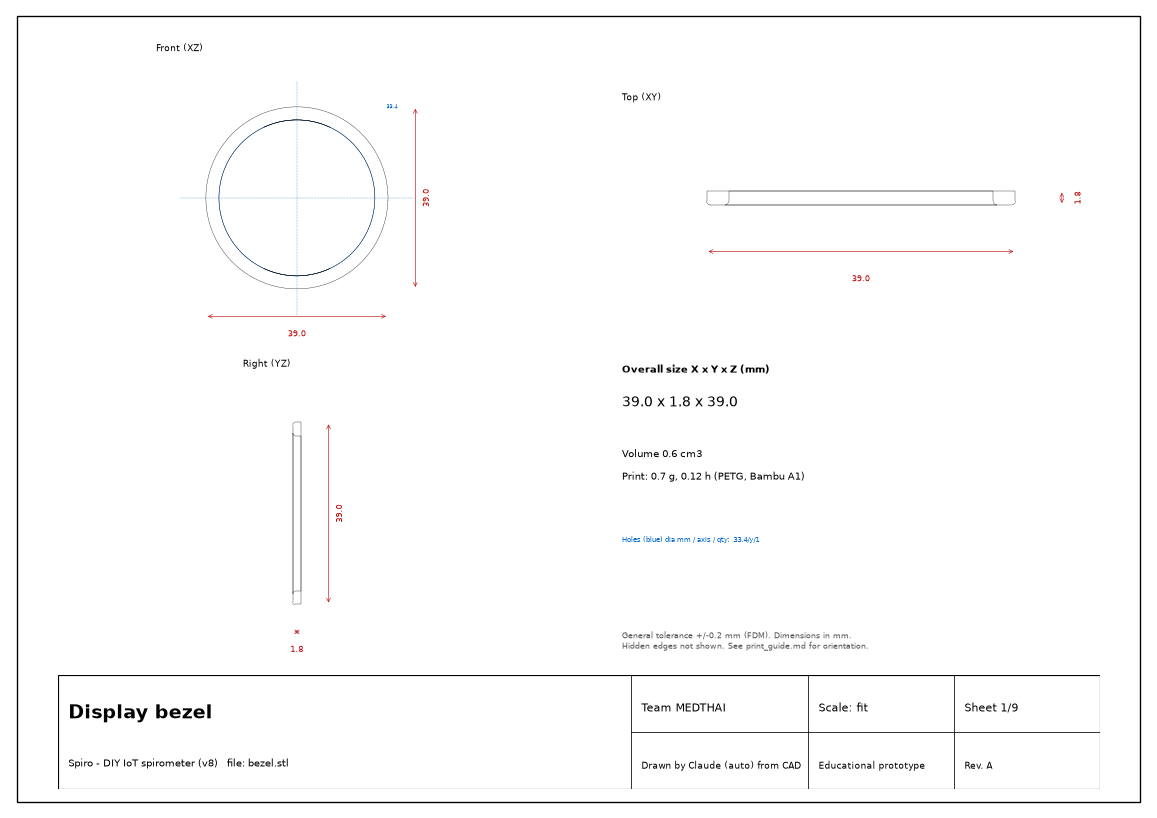
10_manual/drawings/bezel.png
