TANACHAT007/diy-spirometer/10_manual/drawings/button_cap.png

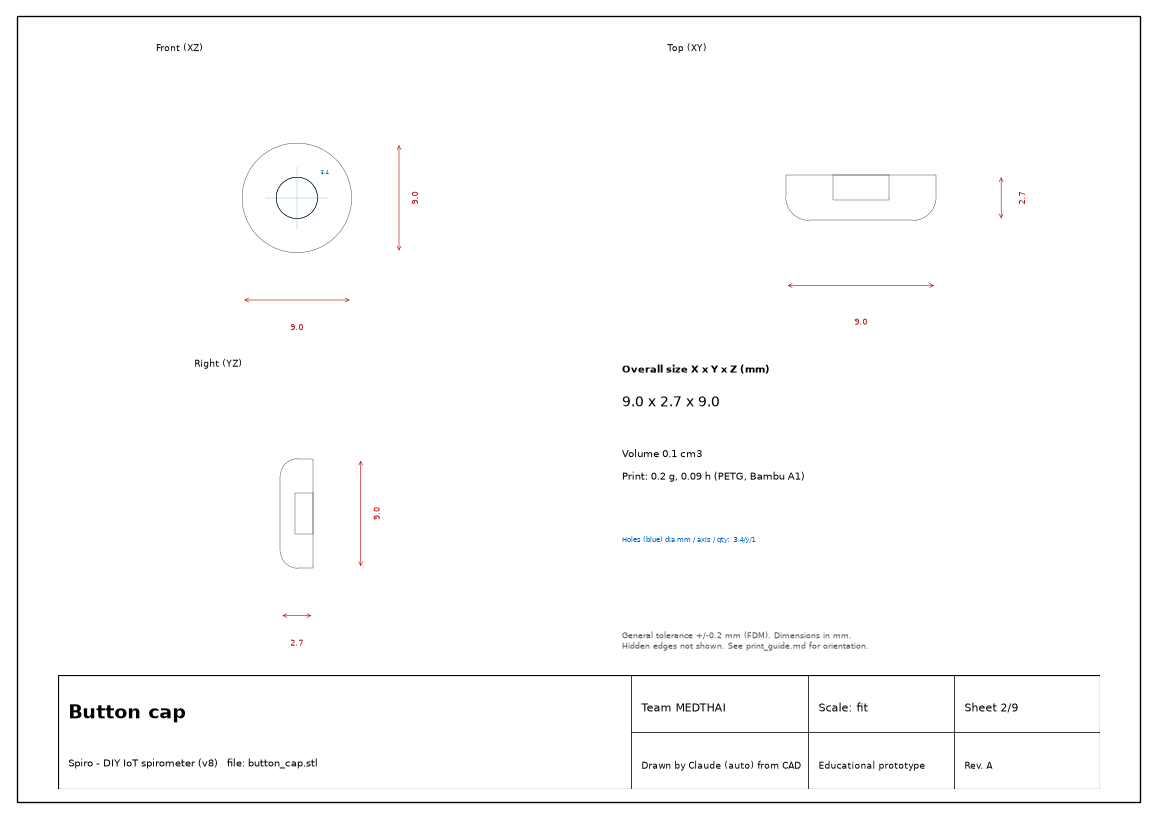
10_manual/drawings/button_cap.png
