TANACHAT007/diy-spirometer/10_manual/drawings/dock.png

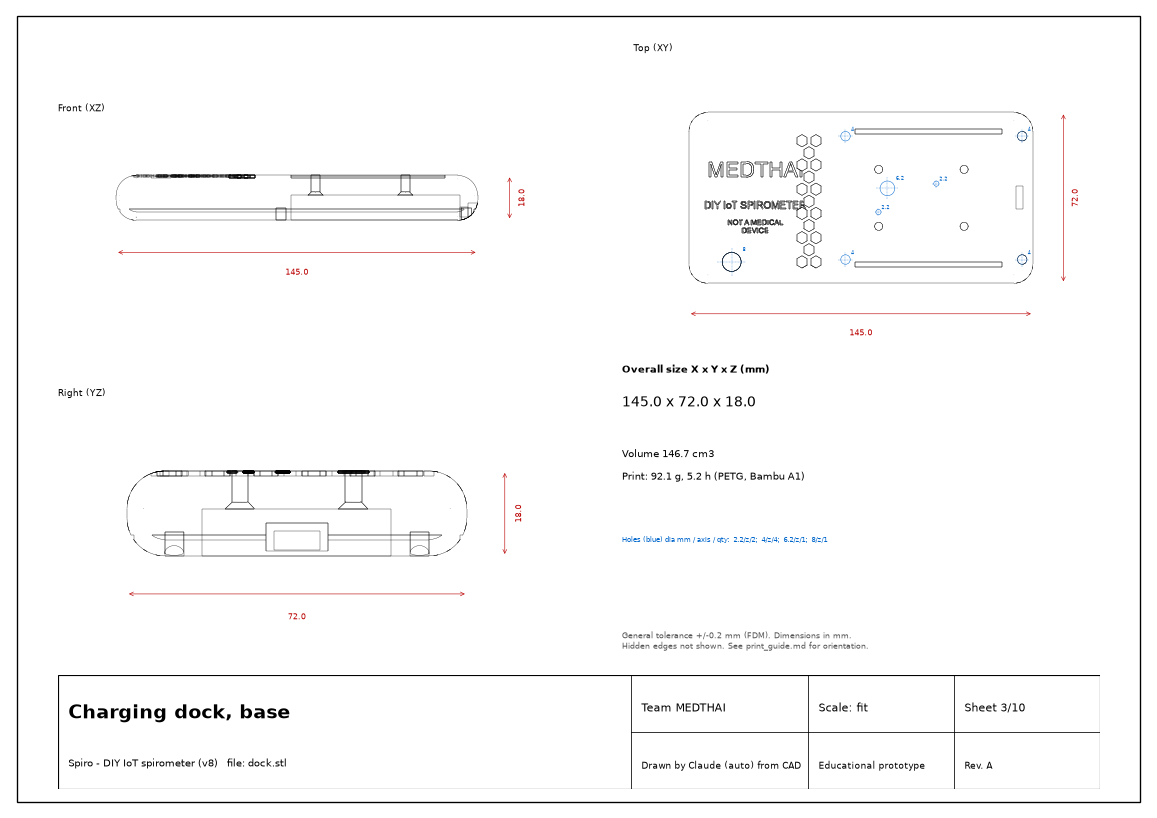
10_manual/drawings/dock.png
