TANACHAT007/diy-spirometer/10_manual/drawings/dock_bottom.png

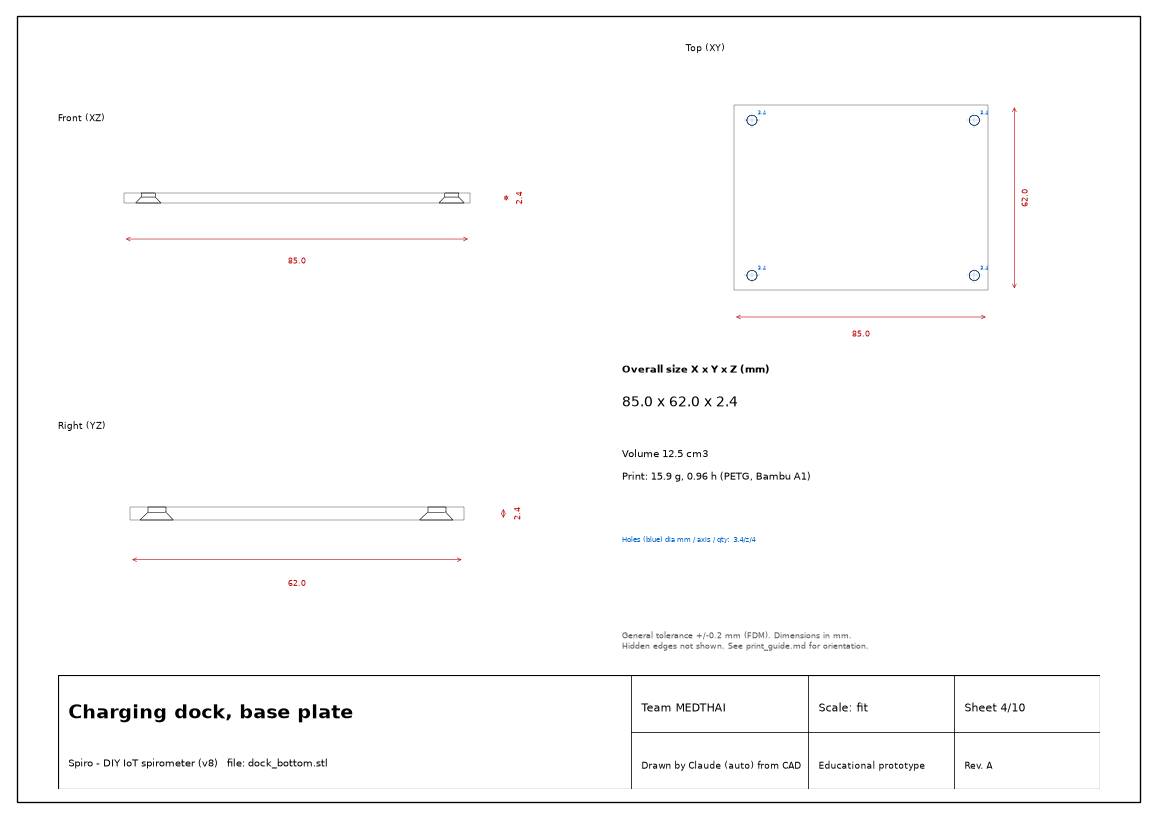
10_manual/drawings/dock_bottom.png
