TANACHAT007/diy-spirometer/10_manual/drawings/dock_cradle.png

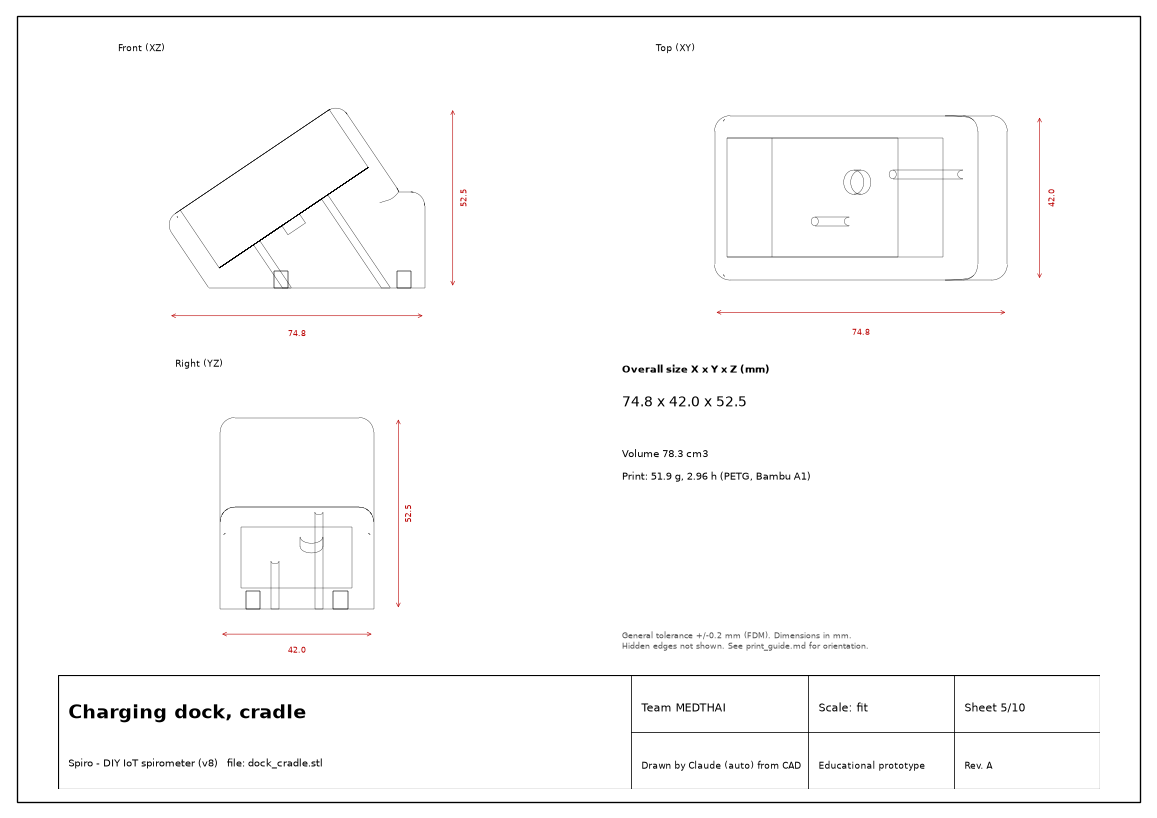
10_manual/drawings/dock_cradle.png
