TANACHAT007/diy-spirometer/10_manual/drawings/dock_left.png

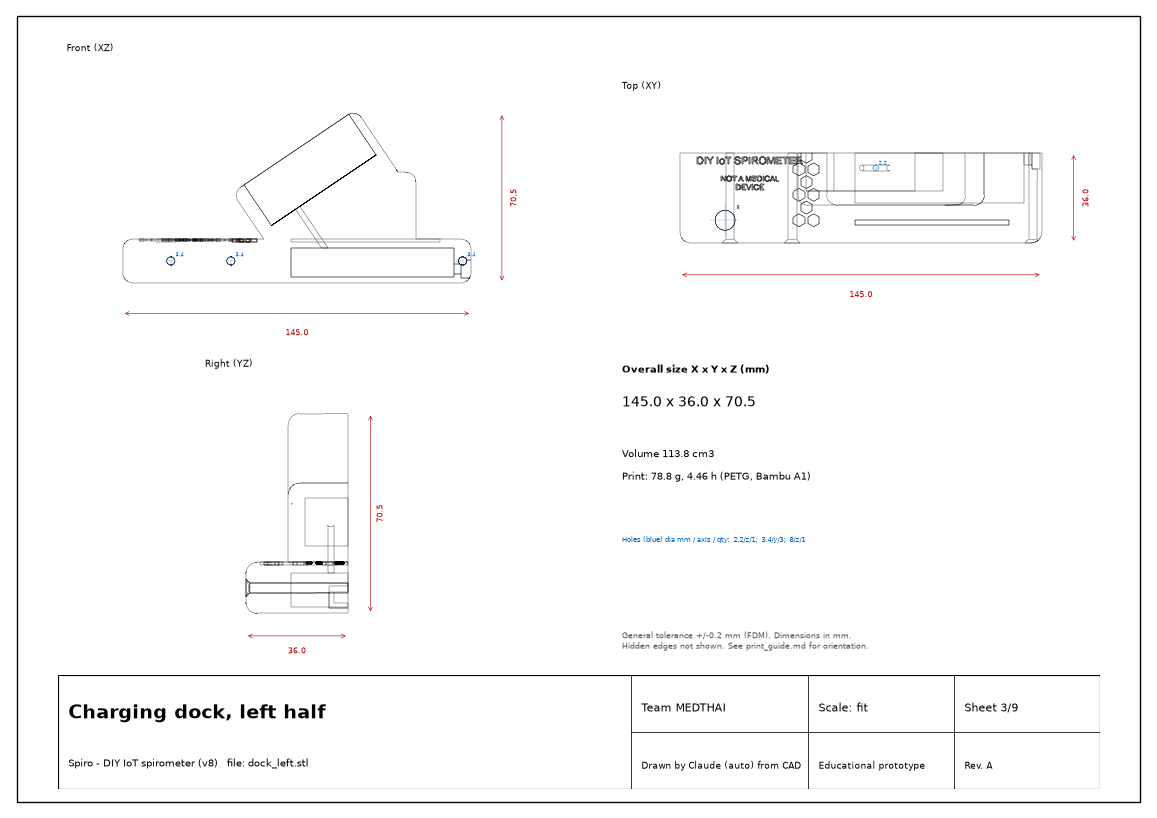
10_manual/drawings/dock_left.png
