TANACHAT007/diy-spirometer/10_manual/drawings/flow_tube.png

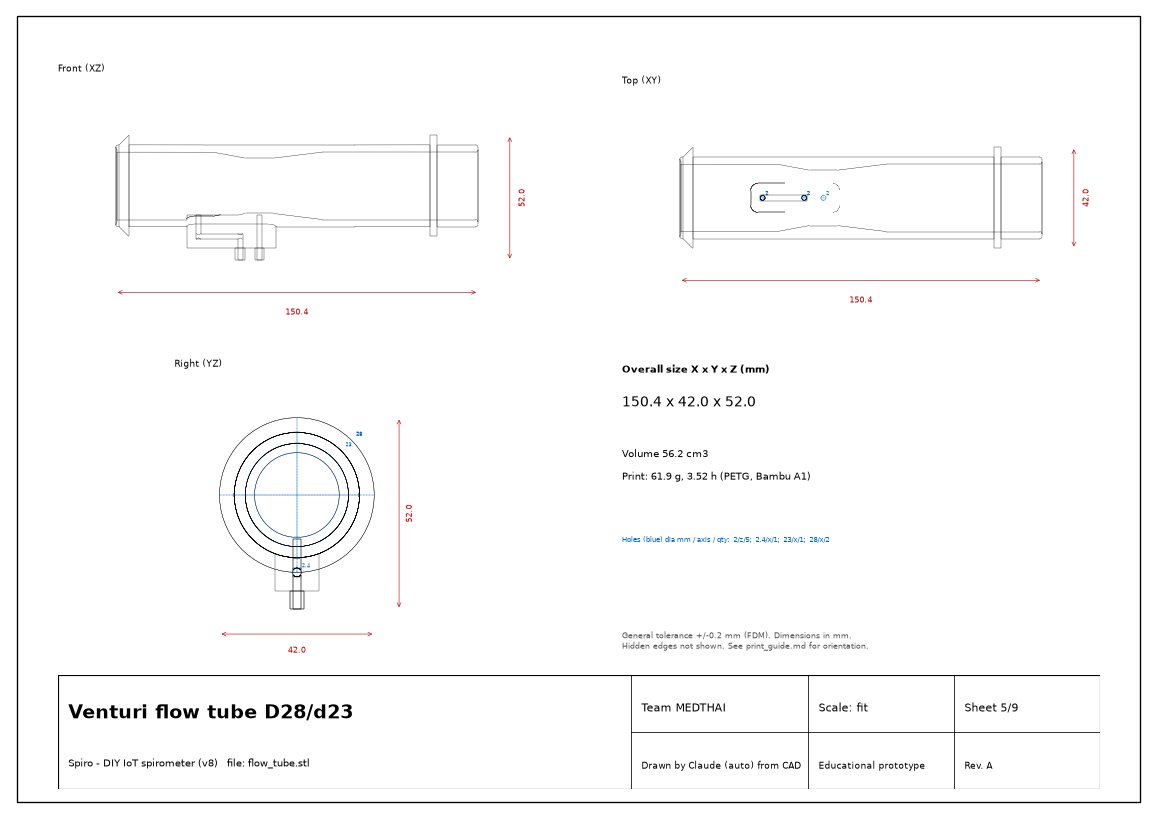
10_manual/drawings/flow_tube.png
