TANACHAT007/diy-spirometer/10_manual/drawings/housing_left.png

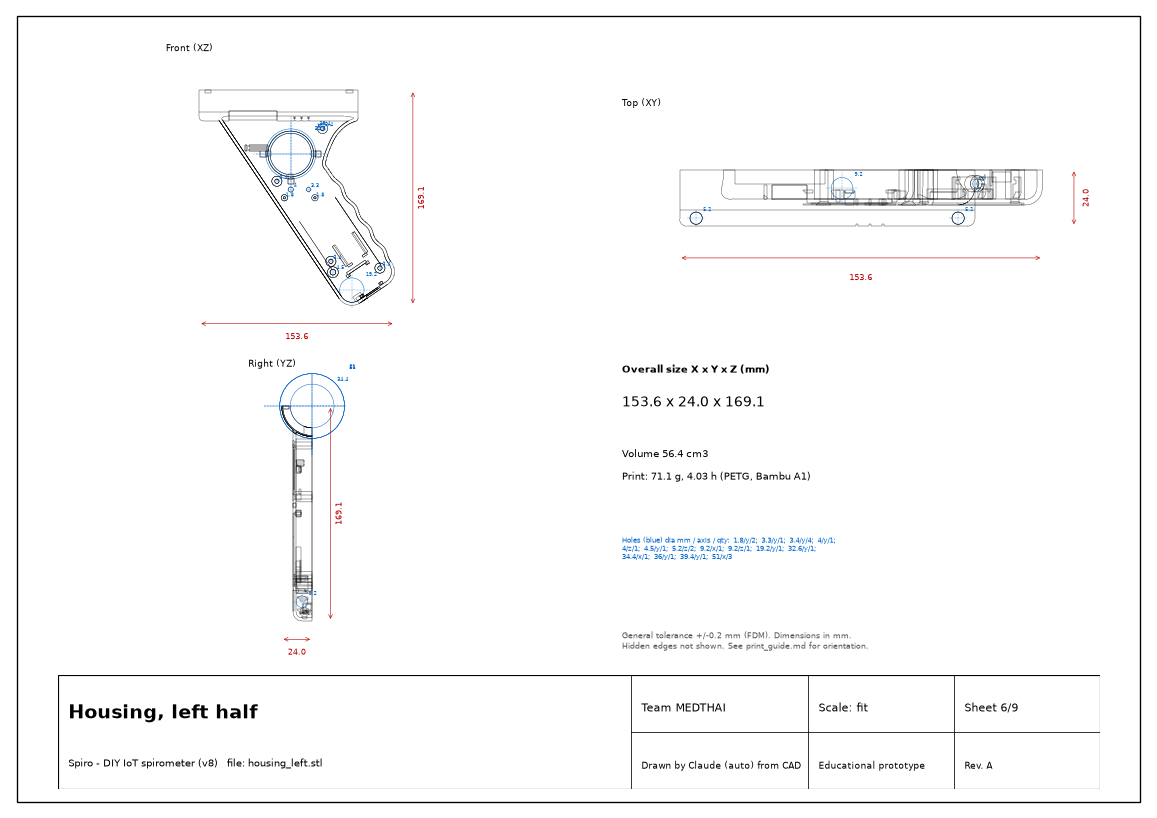
10_manual/drawings/housing_left.png
