TANACHAT007/diy-spirometer/10_manual/drawings/mouthpiece.png

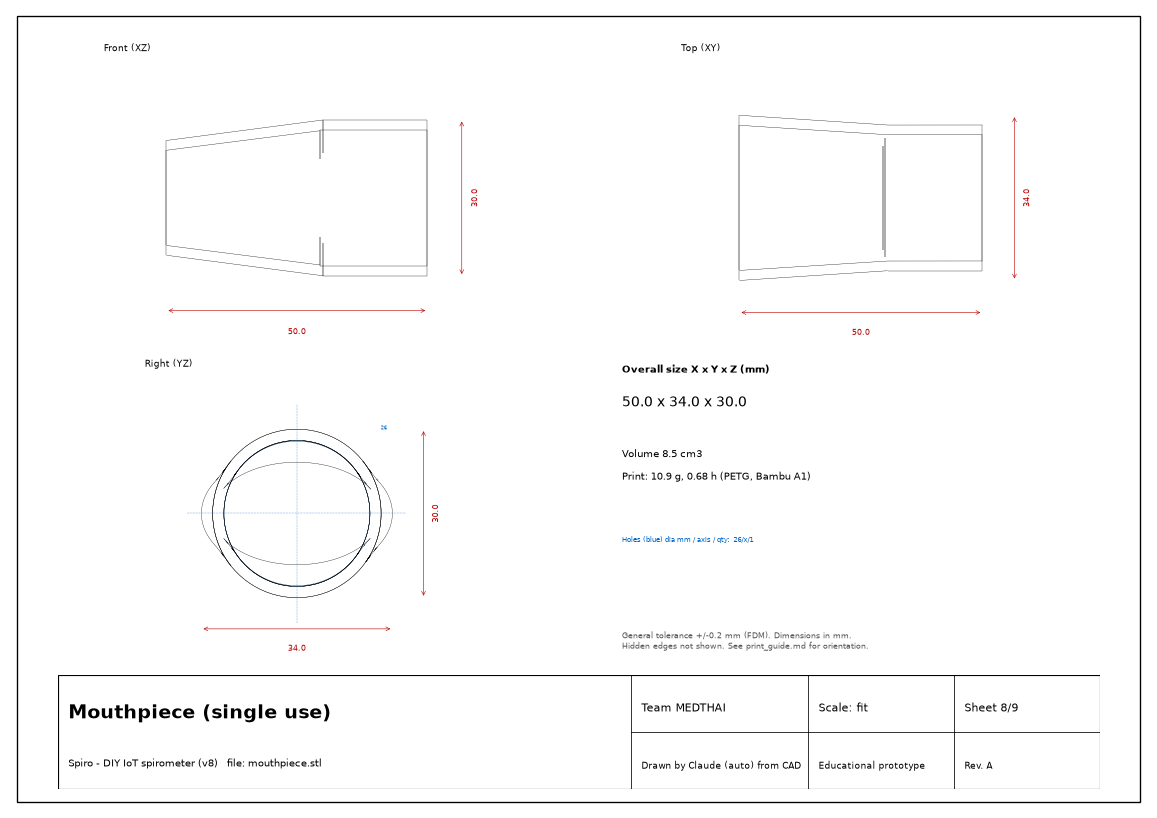
10_manual/drawings/mouthpiece.png
