TANACHAT007/diy-spirometer/10_manual/drawings/top_cover.png

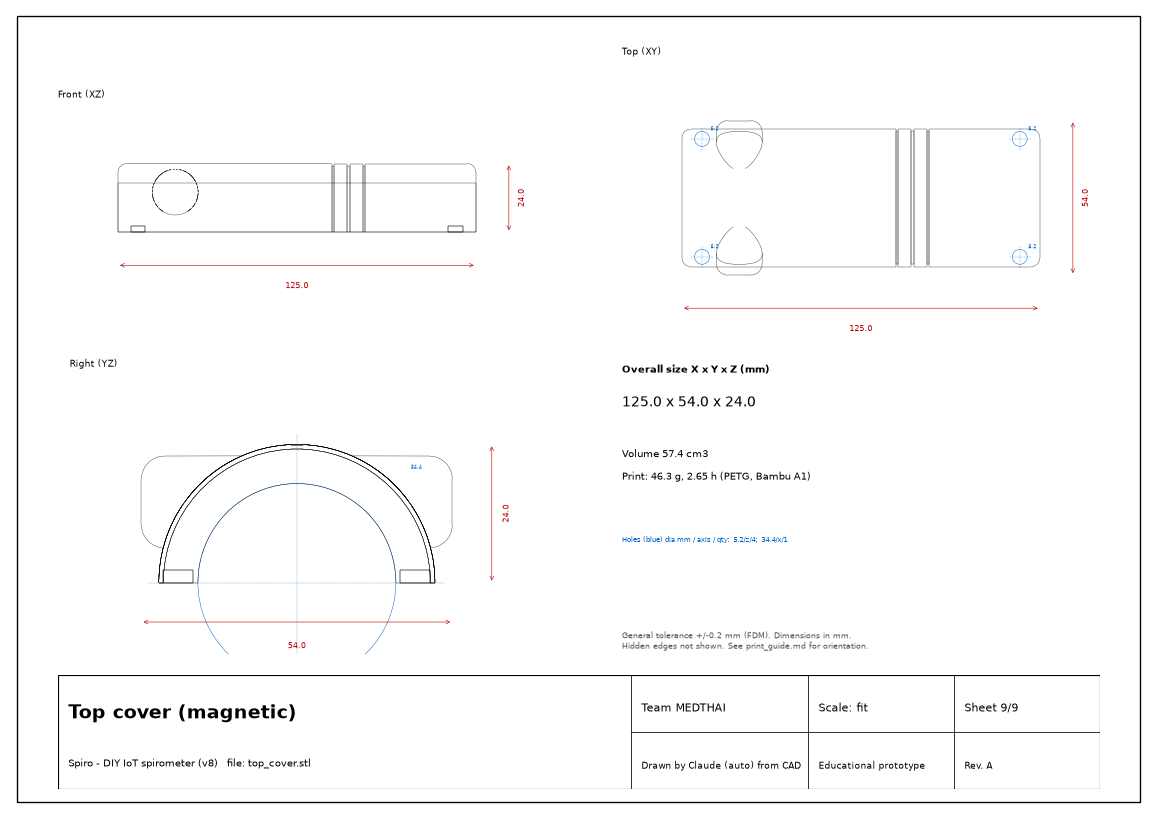
10_manual/drawings/top_cover.png
