TANACHAT007/diy-spirometer/10_manual/web/img/cu_dock.jpg

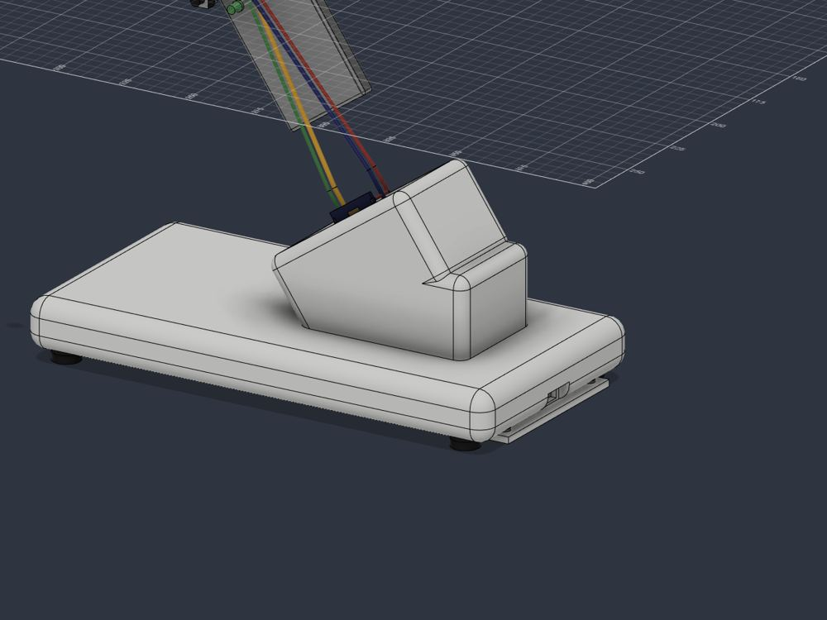
10_manual/web/img/cu_dock.jpg
