TANACHAT007/diy-spirometer/10_manual/web/img/cu_inside.jpg

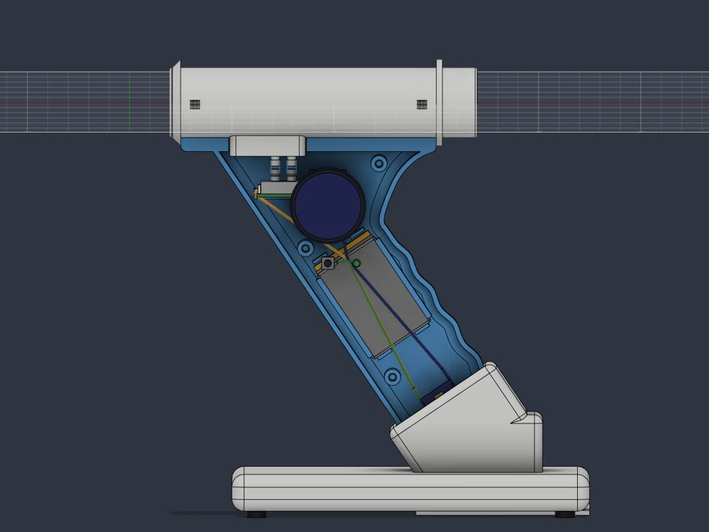
10_manual/web/img/cu_inside.jpg
