TANACHAT007/diy-spirometer/10_manual/web/img/v_dock.png

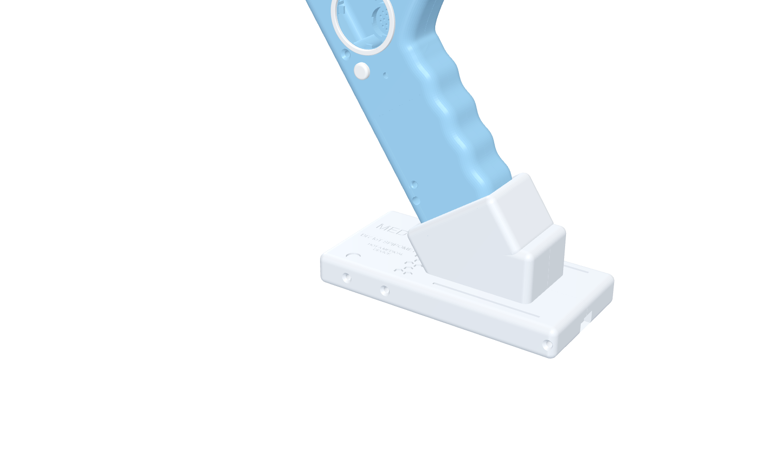
10_manual/web/img/v_dock.png
