TANACHAT007/diy-spirometer/08_firmware/diy_spirometer/diy_spirometer.ino

// CREDIT-STAMP: (c) 2026 Tanachat S. (TANACHAT007) / MEDTHAI - https://github.com/TANACHAT007/diy-spirometer - MIT
// DIY IoT Spirometer — XIAO ESP32-S3 + SDP810-500Pa (venturi D28/d23)
// Targets: XIAO ESP32-S3 or XIAO ESP32-C3 (same 21 x 17.8 footprint; pins switch automatically).
// Features: breath test (FVC/FEV1/FEV1-FVC/PEF), BLE live stream, Wi-Fi upload to Firebase RTDB (REST), battery %, NTP time.
// Button (D1 = GPIO2): short press = start test, hold 1.5 s = zero offset, hold 4 s = new mouthpiece, hold 8 s = show device code and open the 5-minute pairing window. LED on D2 = GPIO3.
// ESP32-S3 only: GC9A01 round display (LovyanGFX) + MAX98357A I2S speaker (soft tones) + disposable-mouthpiece life counter.
// NOT a medical device. Venturi model Q = K*sqrt(dP); K from calibration with a 3 L syringe (see README).
#include <Wire.h>
#include <WiFi.h>
#include <HTTPClient.h>
#include <WiFiClientSecure.h>
#include <Preferences.h>
#include <time.h>
#include <BLEDevice.h>
#include <BLEServer.h>
#include <BLEUtils.h>
#include <BLE2902.h>
#if CONFIG_IDF_TARGET_ESP32C3
#define HAS_UI 0                          // C3: no display / speaker (fewer pins, one core)
#else
#define HAS_UI 1
#endif
#if HAS_UI
#define LGFX_USE_V1
#include <LovyanGFX.hpp>
#include <driver/i2s.h>
#endif

// Config is stored in flash; set it over serial: "wifi SSID PASS", "db URL", "dev ID", "auth SECRET", "k 0.705"
Preferences prefs;
String WIFI_SSID = "", WIFI_PASS = "", DB_URL = "", DEV_ID = "spiro-01", DB_AUTH = "";
float K_VENT = 0.705f;                    // L/s per sqrt(Pa): theory Cd=0.97, D28/d23. CALIBRATE.
#if CONFIG_IDF_TARGET_ESP32C3             // XIAO ESP32-C3: D4=GPIO6, D5=GPIO7, D1=GPIO3, D2=GPIO4, D0=GPIO2
const int SDA_PIN = 6, SCL_PIN = 7, BTN_PIN = 3, LED_PIN = 4, BAT_PIN = 2;
#else                                     // XIAO ESP32-S3: D4=GPIO5, D5=GPIO6, D1=GPIO2, D2=GPIO3, D0=GPIO1
const int SDA_PIN = 5, SCL_PIN = 6, BTN_PIN = 2, LED_PIN = 3, BAT_PIN = 1;
#endif
#if HAS_UI                                // XIAO ESP32-S3: TFT SCK=D8, MOSI=D10, DC=D9 (CS->GND, RST->3V3: 3 pins only); I2S BCLK=D3, LRC=D6, DIN=D7
const int TFT_SCK = 7, TFT_MOSI = 9, TFT_DC = 8, I2S_BCLK = 4, I2S_LRC = 43, I2S_DIN = 44;
#endif
const float DEADBAND_PA = 0.15f;          // |dP| below this -> 0 flow (sqrt law blows up zero-offset noise; ~0.27 L/s)
const float END_FLOW = 0.25f;             // end of test when flow stays below this for 1 s
const uint32_t SAMPLE_US = 2500;          // 400 Hz

float scalePa = 60.0f, offsetPa = 0;
struct Result { float fvc, fev1, ratio, pef; uint32_t ms; time_t ts; bool valid; } last;
BLECharacteristic* chLive = nullptr;
BLECharacteristic* chRes = nullptr;
BLECharacteristic* chCfg = nullptr;       // phone -> device Wi-Fi setup + device info (only while the pairing window is open)
String DEV_CODE = "";                      // SP-XXXXX-XXXXX, random, made on first boot, shown on the screen only (hold button 8 s)
bool pairOpen = false; uint32_t pairUntil = 0;
volatile bool wifiPending = false; String pendSsid, pendPass;
bool bleOn = false;

uint8_t crc8(const uint8_t* d, int n) {
  uint8_t c = 0xFF;
  for (int i = 0; i < n; i++) { c ^= d[i]; for (int b = 0; b < 8; b++) c = (c & 0x80) ? (c << 1) ^ 0x31 : (c << 1); }
  return c;
}
bool sdpStart() {
  Wire.beginTransmission(0x25); Wire.write(0x36); Wire.write(0x15);   // continuous, differential pressure, averaged
  return Wire.endTransmission() == 0;
}
bool sdpRead(float& dp) {
  if (Wire.requestFrom(0x25, 9) != 9) return false;
  uint8_t b[9]; for (int i = 0; i < 9; i++) b[i] = Wire.read();
  if (crc8(b, 2) != b[2] || crc8(b + 6, 2) != b[8]) return false;
  int16_t raw = (int16_t)((b[0] << 8) | b[1]);
  int16_t sc = (int16_t)((b[6] << 8) | b[7]);
  if (sc) scalePa = sc;
  dp = raw / scalePa;
  return true;
}
float flowLps(float dp) {
  if (fabsf(dp) < DEADBAND_PA) return 0;
  float s = dp < 0 ? -1 : 1;
  return s * K_VENT * sqrtf(fabsf(dp));
}
float batteryPct() {
  float v = analogReadMilliVolts(BAT_PIN) * 2.0f / 1000.0f;
  return constrain((v - 3.3f) / (4.15f - 3.3f) * 100.0f, 0, 100);
}


// ================= disposable mouthpiece life (plant-based PLA, one person; replace after 20 blows or 7 days) =========
const uint16_t MP_MAX_USES = 20;
const uint8_t MP_MAX_DAYS = 7;
uint16_t mpUses = 0; uint32_t mpStart = 0;     // blows since "new mouthpiece", epoch of the first blow (0 = clock unknown)
int volPct = 40;                               // speaker volume 0..100 (serial "vol 40")
bool clockOk() { return time(nullptr) > 1700000000; }
int mpDays() { return (mpStart && clockOk()) ? (int)((time(nullptr) - mpStart) / 86400) : 0; }
bool mpExpired() { return mpUses >= MP_MAX_USES || mpDays() >= MP_MAX_DAYS; }
void mpSave() { prefs.begin("spiro", false); prefs.putUShort("mpn", mpUses); prefs.putUInt("mps", mpStart); prefs.putInt("vol", volPct); prefs.end(); }
void mpNew() { mpUses = 0; mpStart = 0; mpSave(); }
void mpCount() { mpUses++; if (!mpStart && clockOk()) mpStart = time(nullptr); mpSave(); }

#if HAS_UI
// ================= speaker: MAX98357A over I2S, sine + 2nd harmonic with fade in/out (soft, not a raw buzzer) ==========
const int SR = 16000;
void audioInit() {
  i2s_config_t c = {};
  c.mode = (i2s_mode_t)(I2S_MODE_MASTER | I2S_MODE_TX); c.sample_rate = SR;
  c.bits_per_sample = I2S_BITS_PER_SAMPLE_16BIT; c.channel_format = I2S_CHANNEL_FMT_ONLY_LEFT;
  c.communication_format = I2S_COMM_FORMAT_STAND_I2S; c.intr_alloc_flags = ESP_INTR_FLAG_LEVEL1;
  c.dma_buf_count = 4; c.dma_buf_len = 256; c.use_apll = false; c.tx_desc_auto_clear = true;
  i2s_driver_install(I2S_NUM_0, &c, 0, NULL);
  i2s_pin_config_t p = {};
  p.mck_io_num = I2S_PIN_NO_CHANGE; p.bck_io_num = I2S_BCLK; p.ws_io_num = I2S_LRC;
  p.data_out_num = I2S_DIN; p.data_in_num = I2S_PIN_NO_CHANGE;
  i2s_set_pin(I2S_NUM_0, &p);
}
void playTone(float f, int ms) {
  if (volPct <= 0) return;
  int n = SR / 1000 * ms; int16_t buf[256]; size_t w;
  for (int i = 0; i < n;) {
    int m = min(256, n - i);
    for (int k = 0; k < m; k++) {
      float t = (float)(i + k) / SR;
      float env = min(1.0f, min((i + k) / (0.012f * SR), (n - i - k) / (0.030f * SR)));
      buf[k] = (int16_t)((sinf(6.2832f * f * t) * 0.8f + sinf(12.566f * f * t) * 0.12f) * env * (volPct / 100.0f) * 24000.0f);
    }
    i2s_write(I2S_NUM_0, buf, m * 2, &w, portMAX_DELAY);
    i += m;
  }
  i2s_zero_dma_buffer(I2S_NUM_0);
}
void sndReady() { playTone(523, 110); playTone(659, 110); playTone(784, 160); }          // C5 E5 G5: start blowing
void sndDone()  { playTone(784, 120); playTone(1047, 220); }                              // test finished
void sndGood()  { playTone(523, 90); playTone(659, 90); playTone(784, 90); playTone(1047, 240); }
void sndLow()   { playTone(392, 160); playTone(330, 160); playTone(262, 300); }           // lower result: calm descending, not an alarm
void sndWarn()  { for (int i = 0; i < 3; i++) { playTone(440, 120); delay(90); } }         // change mouthpiece / low battery
void sndClick() { playTone(880, 40); }

// ================= round display GC9A01 (LovyanGFX, 3-wire: CS tied low, RST tied high) =========
class LGFX : public lgfx::LGFX_Device {
  lgfx::Panel_GC9A01 _panel; lgfx::Bus_SPI _bus;
 public:
  LGFX() {
    auto b = _bus.config();
    b.spi_host = SPI2_HOST; b.spi_mode = 0; b.freq_write = 40000000; b.freq_read = 0;
    b.pin_sclk = TFT_SCK; b.pin_mosi = TFT_MOSI; b.pin_miso = -1; b.pin_dc = TFT_DC;
    _bus.config(b); _panel.setBus(&_bus);
    auto p = _panel.config();
    p.pin_cs = -1; p.pin_rst = -1; p.panel_width = 240; p.panel_height = 240; p.invert = true; p.readable = false;
    _panel.config(p); setPanel(&_panel);
  }
} tft;
const uint16_t SKY = 0x5D7C, OKC = 0x2EC9, WARNC = 0xFD20, BADC = 0xF9A6, DIM = 0x7BEF;   // sky-blue, green, amber, red, grey (RGB565)
void uiRing(uint16_t c) { tft.fillArc(120, 120, 117, 112, 0, 360, c); }
void uiMsg(const char* a, const char* b, uint16_t c) {
  tft.fillScreen(TFT_BLACK); uiRing(c); tft.setTextDatum(middle_center);
  tft.setTextColor(c); tft.setFont(&fonts::FreeSansBold18pt7b); tft.drawString(a, 120, 100);
  tft.setTextColor(TFT_WHITE); tft.setFont(&fonts::FreeSans12pt7b); tft.drawString(b, 120, 145);
}
void uiIdle(float bat) {
  tft.fillScreen(TFT_BLACK); uiRing(mpExpired() ? WARNC : SKY); tft.setTextDatum(middle_center);
  tft.setTextColor(DIM); tft.setFont(&fonts::FreeSans9pt7b); tft.drawString("SPIROMETER", 120, 52);
  tft.setTextColor(TFT_WHITE); tft.setFont(&fonts::FreeSansBold24pt7b); tft.drawString("READY", 120, 105);
  tft.setFont(&fonts::FreeSans9pt7b); tft.setTextColor(bleOn ? SKY : DIM); tft.drawString(bleOn ? "Bluetooth connected" : "press to blow", 120, 140);
  char s[40]; snprintf(s, sizeof s, "mouthpiece %u/%u", mpUses, MP_MAX_USES);
  tft.setTextColor(mpExpired() ? WARNC : DIM); tft.drawString(mpExpired() ? "CHANGE MOUTHPIECE" : s, 120, 170);
  snprintf(s, sizeof s, "battery %.0f%%", bat);
  tft.setTextColor(bat < 15 ? BADC : DIM); tft.drawString(s, 120, 192);
}
void uiTest(float q, float vol) {
  static uint32_t last = 0; if (millis() - last < 90) return; last = millis();
  float f = constrain(q / 12.0f, 0, 1);
  tft.fillArc(120, 120, 117, 108, 135, 135 + 270, 0x2104);
  if (f > 0.01f) tft.fillArc(120, 120, 117, 108, 135, 135 + 270 * f, SKY);
  tft.fillRect(40, 70, 160, 100, TFT_BLACK); tft.setTextDatum(middle_center);
  char s[24]; snprintf(s, sizeof s, "%.2f", vol);
  tft.setTextColor(TFT_WHITE); tft.setFont(&fonts::FreeSansBold24pt7b); tft.drawString(s, 120, 105);
  tft.setFont(&fonts::FreeSans12pt7b); tft.setTextColor(DIM); tft.drawString("litres", 120, 140);
  snprintf(s, sizeof s, "%.1f L/s", q); tft.drawString(s, 120, 165);
}
void uiResult(const Result& r, const char* qual, char g) {
  uint16_t c = strcmp(qual, "ok") ? WARNC : (r.ratio >= 70 ? OKC : WARNC);
  tft.fillScreen(TFT_BLACK); uiRing(c); tft.setTextDatum(middle_center); char s[40];
  tft.setFont(&fonts::FreeSans9pt7b); tft.setTextColor(DIM); tft.drawString("FEV1", 120, 45);
  tft.setFont(&fonts::FreeSansBold24pt7b); tft.setTextColor(TFT_WHITE); snprintf(s, sizeof s, "%.2f L", r.fev1); tft.drawString(s, 120, 80);
  tft.setFont(&fonts::FreeSans12pt7b); tft.setTextColor(SKY);
  snprintf(s, sizeof s, "FVC %.2f L", r.fvc); tft.drawString(s, 120, 125);
  snprintf(s, sizeof s, "FEV1/FVC %.0f%%", r.ratio); tft.drawString(s, 120, 150);
  snprintf(s, sizeof s, "PEF %.1f L/s", r.pef); tft.drawString(s, 120, 175);
  tft.setFont(&fonts::FreeSans9pt7b); tft.setTextColor(c);
  snprintf(s, sizeof s, "quality %s  grade %c", qual, g); tft.drawString(s, 120, 200);
}
void uiInit() { tft.init(); tft.setRotation(0); tft.setBrightness(200); tft.fillScreen(TFT_BLACK); }
void uiCode(const char* code, const char* hint, uint16_t c) {            // pairing screen: device code + what to do next
  tft.fillScreen(TFT_BLACK); uiRing(c); tft.setTextDatum(middle_center);
  tft.setTextColor(c); tft.setFont(&fonts::FreeSans12pt7b); tft.drawString("DEVICE CODE", 120, 70);
  tft.setTextColor(TFT_WHITE); tft.setFont(&fonts::FreeSansBold12pt7b); tft.drawString(code, 120, 120);
  tft.setTextColor(DIM); tft.setFont(&fonts::FreeSans9pt7b); tft.drawString(hint, 120, 170);
}
#else
void uiMsg(const char*, const char*, uint16_t) {}
void uiCode(const char*, const char*, uint16_t) {}
void uiIdle(float) {} void uiTest(float, float) {} void uiResult(const Result&, const char*, char) {} void uiInit() {} void audioInit() {}
const uint16_t SKY = 0, OKC = 0, WARNC = 0, BADC = 0, DIM = 0;
void sndReady() {} void sndDone() {} void sndGood() {} void sndLow() {} void sndWarn() {} void sndClick() {}
#endif

void loadCfg() {
  prefs.begin("spiro", true);
  WIFI_SSID = prefs.getString("ssid", ""); WIFI_PASS = prefs.getString("pass", "");
  DB_URL = prefs.getString("db", ""); DEV_ID = prefs.getString("dev", "spiro-01"); DB_AUTH = prefs.getString("auth", "");
  K_VENT = prefs.getFloat("k", 0.705f); offsetPa = prefs.getFloat("off", 0);
  mpUses = prefs.getUShort("mpn", 0); mpStart = prefs.getUInt("mps", 0); volPct = prefs.getInt("vol", 40);
  prefs.end();
}
void ensureCode();
void saveStr(const char* k, const String& v) { prefs.begin("spiro", false); prefs.putString(k, v); prefs.end(); }
void saveF(const char* k, float v) { prefs.begin("spiro", false); prefs.putFloat(k, v); prefs.end(); }

void ensureCode() {                        // 10 random characters from a 31-letter alphabet (about 50 bits), no I L O 0 1
  prefs.begin("spiro", true); DEV_CODE = prefs.getString("dcode", ""); prefs.end();
  if (DEV_CODE.length() == 13) return;
  const char* A = "ABCDEFGHJKMNPQRSTUVWXYZ23456789";
  String c = "SP-";
  for (int i = 0; i < 10; i++) { c += A[esp_random() % 31]; if (i == 4) c += '-'; }
  DEV_CODE = c; saveStr("dcode", c);
}
void zero() {
  float sum = 0, v; int n = 0;
  for (int i = 0; i < 400; i++) { if (sdpRead(v)) { sum += v; n++; } delayMicroseconds(SAMPLE_US); }
  if (n) { offsetPa = sum / n; saveF("off", offsetPa); }
  Serial.printf("zero offset %.3f Pa (n=%d)\n", offsetPa, n);
}
void wifiUp() {
  if (WiFi.status() == WL_CONNECTED || WIFI_SSID == "") return;
  WiFi.mode(WIFI_STA); WiFi.begin(WIFI_SSID.c_str(), WIFI_PASS.c_str());
  uint32_t t = millis();
  while (WiFi.status() != WL_CONNECTED && millis() - t < 8000) delay(100);
  if (WiFi.status() == WL_CONNECTED) configTime(7 * 3600, 0, "pool.ntp.org", "time.google.com");
}
bool upload(const Result& r) {
  wifiUp();
  if (WiFi.status() != WL_CONNECTED || DB_URL == "") return false;
  WiFiClientSecure cli; cli.setInsecure();      // no cert pinning: ok for a class demo
  HTTPClient http;
  String url = DB_URL + "/devices/" + DEV_ID + "/sessions.json" + (DB_AUTH.length() ? "?auth=" + DB_AUTH : "");
  char body[256];
  snprintf(body, sizeof body,
           "{\"ts\":%lld,\"fvc\":%.2f,\"fev1\":%.2f,\"ratio\":%.1f,\"pef\":%.2f,\"dur_ms\":%lu,\"bat\":%.0f,\"mp\":%u,\"fw\":\"1.3\"}",
           (long long)r.ts * 1000LL, r.fvc, r.fev1, r.ratio, r.pef, (unsigned long)r.ms, batteryPct(), (unsigned)mpUses);
  if (!http.begin(cli, url)) return false;
  http.addHeader("Content-Type", "application/json");
  int code = http.POST(body);
  http.end();
  Serial.printf("upload -> HTTP %d\n", code);
  return code >= 200 && code < 300;
}
void bleNotify(const char* s, BLECharacteristic* c) {
  if (bleOn && c) { c->setValue((uint8_t*)s, strlen(s)); c->notify(); }
}
class SrvCb : public BLEServerCallbacks {
  void onConnect(BLEServer*) { bleOn = true; }
  void onDisconnect(BLEServer* s) { bleOn = false; s->startAdvertising(); }
};
class CfgCb : public BLECharacteristicCallbacks {
  // write "W|<device code>|<ssid>|<password>" : accepted only while the pairing window is open AND the code matches
  void onWrite(BLECharacteristic* c) {
    String v = String(c->getValue().c_str());
    if (!pairOpen || millis() > pairUntil || !v.startsWith("W|")) return;
    int a = v.indexOf('|', 2), b = v.indexOf('|', a + 1);
    if (a < 0 || b < 0) return;
    if (v.substring(2, a) != DEV_CODE) return;
    pendSsid = v.substring(a + 1, b); pendPass = v.substring(b + 1); wifiPending = true;
  }
  void onRead(BLECharacteristic* c) {
    String info = String("SP1|") + (pairOpen && millis() < pairUntil ? "open" : "closed") + "|" + DEV_ID + "|" + (WiFi.status() == WL_CONNECTED ? WIFI_SSID : String(""));
    c->setValue(info.c_str());                 // never contains the code or the password
  }
};
void bleInit() {
  BLEDevice::init(("Spiro-" + DEV_ID).c_str());
  BLEServer* s = BLEDevice::createServer();
  s->setCallbacks(new SrvCb());
  BLEService* sv = s->createService("6e400001-b5a3-f393-e0a9-e50e24dcca9e");
  chLive = sv->createCharacteristic("6e400002-b5a3-f393-e0a9-e50e24dcca9e", BLECharacteristic::PROPERTY_NOTIFY);
  chRes = sv->createCharacteristic("6e400003-b5a3-f393-e0a9-e50e24dcca9e",
                                   BLECharacteristic::PROPERTY_NOTIFY | BLECharacteristic::PROPERTY_READ);
  chCfg = sv->createCharacteristic("6e400004-b5a3-f393-e0a9-e50e24dcca9e", BLECharacteristic::PROPERTY_READ | BLECharacteristic::PROPERTY_WRITE);
  chCfg->setCallbacks(new CfgCb());
  chLive->addDescriptor(new BLE2902());
  chRes->addDescriptor(new BLE2902());
  sv->start();
  BLEDevice::getAdvertising()->addServiceUUID(sv->getUUID());
  BLEDevice::startAdvertising();
}

// ---- quality: ATS/ERS-style checks that this firmware CAN do (no flow-time back-extrapolation yet)
const char* quality(const Result& r) {
  if (r.ms < 2000) return "short";            // < 2 s exhalation (the device cut-off ends healthy blows at ~2.5-4 s; ATS wants 6 s)
  if (r.pef < 1.0f) return "weak";
  return "ok";
}
// repeatability over the last 3 valid tests: best two FVC and FEV1 within 0.15 L (ATS 2019) -> grade A
float histFvc[3] = {0, 0, 0}, histFev[3] = {0, 0, 0}; int nHist = 0;
char grade() {
  if (nHist < 2) return '-';
  int n = nHist < 3 ? nHist : 3; float a = 0, b = 0, c = 0, d = 0;
  for (int i = 0; i < n; i++) { if (histFvc[i] > a) { b = a; a = histFvc[i]; } else if (histFvc[i] > b) b = histFvc[i];
                                if (histFev[i] > c) { d = c; c = histFev[i]; } else if (histFev[i] > d) d = histFev[i]; }
  return (a - b <= 0.15f && c - d <= 0.15f) ? 'A' : 'C';
}
// offline queue: results that failed to upload are kept in flash (max 20) and sent with the next result
void queuePush(const Result& r) {
  prefs.begin("q", false);
  int n = prefs.getInt("n", 0); if (n >= 20) n = 19;
  char k[8]; snprintf(k, sizeof k, "r%d", n);
  prefs.putBytes(k, &r, sizeof r); prefs.putInt("n", n + 1); prefs.end();
}
void queueFlush() {
  prefs.begin("q", false); int n = prefs.getInt("n", 0); prefs.end();
  for (int i = 0; i < n; i++) {
    Result r; prefs.begin("q", true); char k[8]; snprintf(k, sizeof k, "r%d", i);
    size_t got = prefs.getBytes(k, &r, sizeof r); prefs.end();
    if (got != sizeof r || !upload(r)) return;
  }
  prefs.begin("q", false); prefs.putInt("n", 0); prefs.end();
}

void runTest() {
  digitalWrite(LED_PIN, HIGH);
  if (mpExpired()) { uiMsg("CHANGE", "mouthpiece", WARNC); sndWarn(); delay(1000); }     // advice only: the test still runs
  uiMsg("BLOW", "now!", SKY); sndReady();
  Serial.println("blow now (max 15 s)...");
  float vol = 0, pef = 0, fev1 = 0, dp;
  uint32_t t0 = 0, tNext = micros(), lastFlow = millis(), tStart = millis(), tl = 0;
  static float ql[400]; int nl = 0;          // flow log every 40 ms, used to extrapolate the tail below the 0.25 L/s cut-off
  bool started = false;
  while (millis() - tStart < 15000) {
    while ((int32_t)(micros() - tNext) < 0) {}
    tNext += SAMPLE_US;
    if (!sdpRead(dp)) continue;
    float q = flowLps(dp - offsetPa);
    if (!started) { if (q > 0.3f) { started = true; t0 = millis(); lastFlow = millis(); } else continue; }
    uint32_t t = millis() - t0;
    vol += q * SAMPLE_US * 1e-6f;
    if (q > pef) pef = q;
    uiTest(q, vol);          // self-throttled to ~11 Hz; sample clock catches up, volume integral stays correct
    if (t <= 1000) fev1 = vol;
    if (t - tl >= 40) {
      tl = t; if (nl < 400) ql[nl++] = q;
      char s[40]; snprintf(s, sizeof s, "%lu,%.2f,%.2f", (unsigned long)t, q, vol);
      bleNotify(s, chLive);
      Serial.println(s);
    }
    if (q > END_FLOW) lastFlow = millis();
    if (millis() - lastFlow > 1000 && t > 1000) break;     // end: flow < END_FLOW for 1 s
  }
  // The test stops when flow stays < END_FLOW; for a healthy blow that discards the slow tail (~5-12 % of FVC) and would
  // make FEV1/FVC look falsely normal. Estimate the tail as q_cut * tau (exponential decay fitted over the last second
  // above the cut-off), capped at 0.5 L and 15 % of the volume. Not validated: check against the 3 L syringe.
  float tail = 0;
  if (started && nl > 30) {
    int ic = -1; for (int i = nl - 1; i >= 0; i--) if (ql[i] > END_FLOW) { ic = i; break; }
    if (ic > 28) {
      float qc = (ql[ic] + ql[ic - 1] + ql[ic - 2]) / 3, qp = (ql[ic - 26] + ql[ic - 27] + ql[ic - 28]) / 3;
      if (qc > 0.1f && qp > qc * 1.2f) tail = min(qc / logf(qp / qc), min(0.5f, 0.15f * vol));
    }
  }
  vol += tail;
  Serial.printf("tail extrapolation +%.2f L\n", tail);
  digitalWrite(LED_PIN, LOW);
  if (batteryPct() < 15) for (int i = 0; i < 6; i++) { digitalWrite(LED_PIN, !digitalRead(LED_PIN)); delay(120); }  // low battery
  last = { vol, fev1, vol > 0 ? 100 * fev1 / vol : 0, pef, started ? millis() - t0 : 0, time(nullptr), started && vol > 0.2f };
  Serial.printf("RESULT FVC=%.2f L FEV1=%.2f L FEV1/FVC=%.0f%% PEF=%.1f L/s\n", last.fvc, last.fev1, last.ratio, last.pef);
  if (last.valid) {
    char s[96]; snprintf(s, sizeof s, "R,%.2f,%.2f,%.1f,%.2f,%s", last.fvc, last.fev1, last.ratio, last.pef, quality(last));
    bleNotify(s, chRes);
    histFvc[nHist % 3] = last.fvc; histFev[nHist % 3] = last.fev1; nHist++;
    Serial.printf("quality=%s grade=%c battery=%.0f%%\n", quality(last), grade(), batteryPct());
    mpCount();
    uiResult(last, quality(last), grade());
    sndDone();
    if (!strcmp(quality(last), "ok") && last.ratio >= 70) sndGood(); else sndLow();
    if (mpExpired()) { delay(600); sndWarn(); }
    if (batteryPct() < 15) { delay(300); sndWarn(); }
    if (upload(last)) { Serial.println("cloud: saved"); queueFlush(); }
    else { queuePush(last); Serial.println("cloud: offline -> queued in flash"); }
  } else {
    uiMsg("NO BLOW", "try again", WARNC); sndWarn();
  }
}
void cmd(String l) {
  l.trim();
  if (l == "z") zero();
  else if (l == "s") runTest();
  else if (l.startsWith("wifi ")) {
    int i = l.indexOf(' ', 5);
    saveStr("ssid", l.substring(5, i)); saveStr("pass", l.substring(i + 1)); loadCfg(); Serial.println("wifi saved");
  }
  else if (l.startsWith("db ")) { saveStr("db", l.substring(3)); loadCfg(); Serial.println("db saved"); }
  else if (l.startsWith("auth ")) { saveStr("auth", l.substring(5)); loadCfg(); Serial.println("auth saved"); }
  else if (l.startsWith("dev ")) { saveStr("dev", l.substring(4)); loadCfg(); Serial.println("device id saved (reboot)"); }
  else if (l.startsWith("k ")) { K_VENT = l.substring(2).toFloat(); saveF("k", K_VENT); Serial.printf("K=%.4f\n", K_VENT); }
  else if (l.startsWith("vol ")) { volPct = constrain(l.substring(4).toInt(), 0, 100); mpSave(); sndClick(); Serial.printf("volume %d\n", volPct); }
  else if (l == "code") Serial.printf("device code: %s\n", DEV_CODE.c_str());
  else if (l == "pair") { pairOpen = true; pairUntil = millis() + 300000; Serial.println("pairing window open for 5 min"); }
  else if (l == "mp new") { mpNew(); Serial.println("new mouthpiece: counter reset"); }
  else if (l == "info")
    Serial.printf("code=%s dev=%s wifi=%s db=%s K=%.4f off=%.3f bat=%.0f%% mouthpiece=%u/%u uses, day %d/%d, vol=%d\n", DEV_CODE.c_str(), DEV_ID.c_str(),
                  WIFI_SSID.c_str(), DB_URL.c_str(), K_VENT, offsetPa, batteryPct(), mpUses, MP_MAX_USES, mpDays(), MP_MAX_DAYS, volPct);
}
void setup() {
  Serial.begin(115200);
  pinMode(BTN_PIN, INPUT_PULLUP);
  pinMode(LED_PIN, OUTPUT);
  loadCfg(); ensureCode();
  uiInit(); audioInit(); uiMsg("SPIRO", "starting...", SKY);
  Wire.begin(SDA_PIN, SCL_PIN, 400000);
  Serial.println(sdpStart() ? "SDP810 ok" : "SDP810 NOT FOUND");
  delay(100);
  zero();
  bleInit();
  wifiUp();
  Serial.println("cmds: z s info | wifi SSID PASS | db https://<proj>.firebaseio.com | dev ID | auth SECRET | k 0.705 | vol 0-100 | mp new");
  uiIdle(batteryPct()); sndGood();
}
void loop() {
  static bool lastBle = false;
  if (Serial.available()) cmd(Serial.readStringUntil('\n'));
  if (bleOn != lastBle) { lastBle = bleOn; uiIdle(batteryPct()); }
  if (pairOpen && millis() > pairUntil) { pairOpen = false; uiIdle(batteryPct()); }
  if (wifiPending) {                                                   // set from the phone over Bluetooth
    wifiPending = false; saveStr("ssid", pendSsid); saveStr("pass", pendPass); loadCfg();
    WiFi.disconnect(); wifiUp();
    bool ok = WiFi.status() == WL_CONNECTED;
    char m[80]; snprintf(m, sizeof m, ok ? "WIFI,ok,%s" : "WIFI,fail", WiFi.localIP().toString().c_str());
    bleNotify(m, chRes); uiMsg(ok ? "WI-FI OK" : "WI-FI FAIL", WIFI_SSID.c_str(), ok ? OKC : BADC);
    if (ok) pairOpen = false; delay(1500); uiIdle(batteryPct());
  }
  if (digitalRead(BTN_PIN) == LOW) {
    uint32_t t = millis(); bool m1 = false, m2 = false, m3 = false;
    while (digitalRead(BTN_PIN) == LOW && millis() - t < 9000) {          // hold 1.5 s = zero, 4 s = new mouthpiece, 8 s = show device code + open pairing
      uint32_t d = millis() - t;
      if (d > 1500 && !m1) { m1 = true; uiMsg("ZERO", "release to zero", SKY); sndClick(); }
      if (d > 4000 && !m2) { m2 = true; uiMsg("NEW", "mouthpiece? release", OKC); sndClick(); }
      if (d > 8000 && !m3) { m3 = true; uiCode(DEV_CODE.c_str(), "release; open the app", SKY); sndGood(); }
      delay(10);
    }
    uint32_t d = millis() - t;
    if (d > 8000) { pairOpen = true; pairUntil = millis() + 300000; uiCode(DEV_CODE.c_str(), "pairing open 5 min", SKY); delay(8000); }
    else if (d > 4000) { mpNew(); sndGood(); } else if (d > 1500) zero(); else runTest();
    while (digitalRead(BTN_PIN) == LOW) delay(10);
    uiIdle(batteryPct());
  }
}
