TANACHAT007/diy-spirometer/(commit log)

2026-10-15 DIY IoT spirometer: CAD, firmware, web pages, BOM
    [bom.csv, diy-spirometer_assembly.step, dock.stl, dock_bottom.stl, fasteners_bom.csv, flow_tube.stl, housing_left.stl, housing_right.stl]
2026-10-15 Add authorship credit: licenses, CREDITS, file headers, STL/STEP metadata, watermarks
    [diy-spirometer_assembly.step, dock.stl, dock_bottom.stl, flow_tube.stl, housing_left.stl, housing_right.stl, mouthpiece.stl, top_cover.stl]
2026-10-15 Product page: interactive 3D hero from STL (solid/ghost modes)
2026-10-15 Web: lab-grid restyle, 3D hero, multi-device doctor view, BLE live panel, CSV fix
2026-10-15 3D viewer x-ray mode with internal electronics; handoff notes
    [Charge_Contacts.stl, E1_XIAO_ESP32S3.stl, E2_SDP810_500Pa.stl, E3_GC9A01_Round_TFT.stl, E4_LiPo_603450.stl, E5_Button_6x6.stl, E6_LED_3mm.stl, E7_USB_C_Breakout_Dock.stl]
2026-10-15 Add speaker + I2S amp, display/audio firmware, disposable PLA mouthpiece with life counter
    [E8_Speaker_16mm.stl, E9_MAX98357A_I2S_Amp.stl, Wires_Audio.stl, bom.csv, diy-spirometer_assembly.step, housing_left.stl, housing_right.stl, mouthpiece.stl]
2026-10-15 Dashboard: clinical report look, interpretation, personal-best zones, trend alert, A4 print, PWA install
2026-10-15 Rounder grip corners, white top cover + display bezel, engraved dock plate
    [bezel.stl, diy-spirometer_assembly.step, dock.stl, housing_left.stl, housing_right.stl, top_cover.stl]
2026-10-15 Spiro Clinic web app, ring grooves, button cap, strap hole, tail extrapolation firmware
    [bom.csv, button_cap.stl, diy-spirometer_assembly.step, dock.stl, housing_left.stl, housing_right.stl, top_cover.stl]
2026-10-16 Add agricultural-waste material story section to product page
2026-10-16 Mouthpiece prototype material: PETG
2026-10-16 Mouthpiece colour: agri-waste pulp tone; rebuilt CAD renders
    [diy-spirometer_assembly.step, mouthpiece.stl]
2026-10-16 Illustrated click-to-expand material story with research sources
2026-10-16 Product page: HK-Green style (emoji tiles, spring hover, floating chips, stat strip, reveal); fix refs CSS outside style; story CSS now applied
    [diy-spirometer_assembly.step, housing_left.stl]
2026-10-16 Clean three.js renders for the view section (no CAD grid), soft studio background
2026-10-16 3-role system: login/register, admin console, doctor + patient modes in clinic app, shared core.js adapter, Firebase migration notes
2026-10-16 Enable email/password auth config; verified cloud flow end to end
2026-10-16 v6: button/LED on a daughter board dropped in before closing; new renders, BOM, guide
    [E6_LED_3mm.stl, E7_Button_LED_Board.stl, bom.csv, diy-spirometer_assembly.step]
2026-10-16 Essay: frame as v3 built on proven v1/v2
2026-10-16 Essay: need/importance of the device, medical-use evidence for plant fibre, confidence grading
2026-10-16 Device pairing: claim by on-screen code (cloud rules + UI), admin device list; fix admin.html alert string syntax error
2026-10-16 Firmware v1.3 (device code, BLE Wi-Fi setup) WIP; GitHub Pages off; test-account note
2026-10-16 Patient home (2 big buttons), doctor-prescribed training plans + guided sessions, calm light theme, plans/trainings rules
2026-10-17 firmware v1.3: device code, pairing window, BLE Wi-Fi config (compiles S3+C3)
2026-10-19 IYS7 A1 poster (pre-made, in case of Top 100)
2026-10-19 drawings: auto orthographic part sheets (A3) from STL
2026-10-19 drawings: hole dimensions from Fusion B-Rep (dump_features.py), A3 sheets x9
2026-10-21 dock v8: smaller base, light-guide strips, status LED, reveal groove; rebuilt STL/STEP/renders/drawings
    [bezel.stl, button_cap.stl, diy-spirometer_assembly.step, dock.stl, dock_bottom.stl, flow_tube.stl, housing_left.stl, housing_right.stl]
2026-10-21 dock v9: honeycomb panel on top face
    [diy-spirometer_assembly.step, dock.stl]
2026-10-21 dock: recentre engraved text (was clipped at edge); rebuilt STL/STEP/renders/drawings
    [diy-spirometer_assembly.step, dock.stl]
2026-10-21 dock v10: cradle printed separately and bolted to base; joint check script; guide + drawings
    [diy-spirometer_assembly.step, dock.stl, dock_cradle.stl, fasteners_bom.csv]
2026-10-21 grip anti-slip pad recess both halves; performance audit report; print guide: housings seam-down
    [diy-spirometer_assembly.step, housing_left.stl, housing_right.stl]
2026-10-21 half-cut (right half hidden) renders + cutaway.py
2026-10-21 dock cutaway renders (plate/cradle off) + dock_cutaway.py
2026-10-21 dock v12: clamshell halves (left/right), internal cavity, half-cut renders
    [diy-spirometer_assembly.step, dock.stl, dock_bottom.stl, dock_cradle.stl, dock_left.stl, dock_right.stl, fasteners_bom.csv]
2026-10-22 dock v12: guide rows, drawings, hole data for dock halves; drop stale dock.stl/dock_bottom.stl
2026-10-22 web 3D: rebuild product page with dock halves (internals re-exported, views re-rendered)
    [E7_USB_C_Breakout_Dock.stl, Rubber_Feet.stl, plate1_housing_left.stl, plate2_housing_right.stl, plate3_dock_halves.stl, plate4_small_parts.stl]
